BitPeppr/Hojicha44/generated/renders/v0.5.0/bright/orbit_08.png

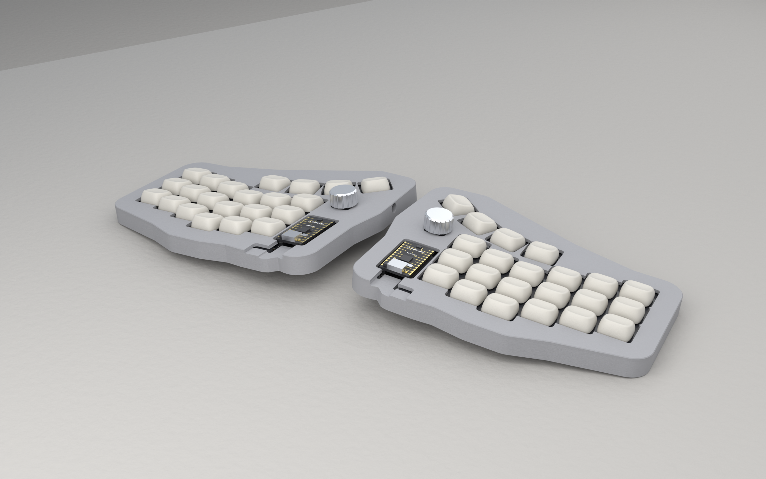
generated/renders/v0.5.0/bright/orbit_08.png
