BitPeppr/Hojicha44/generated/renders/v0.5.0/env/mat.png

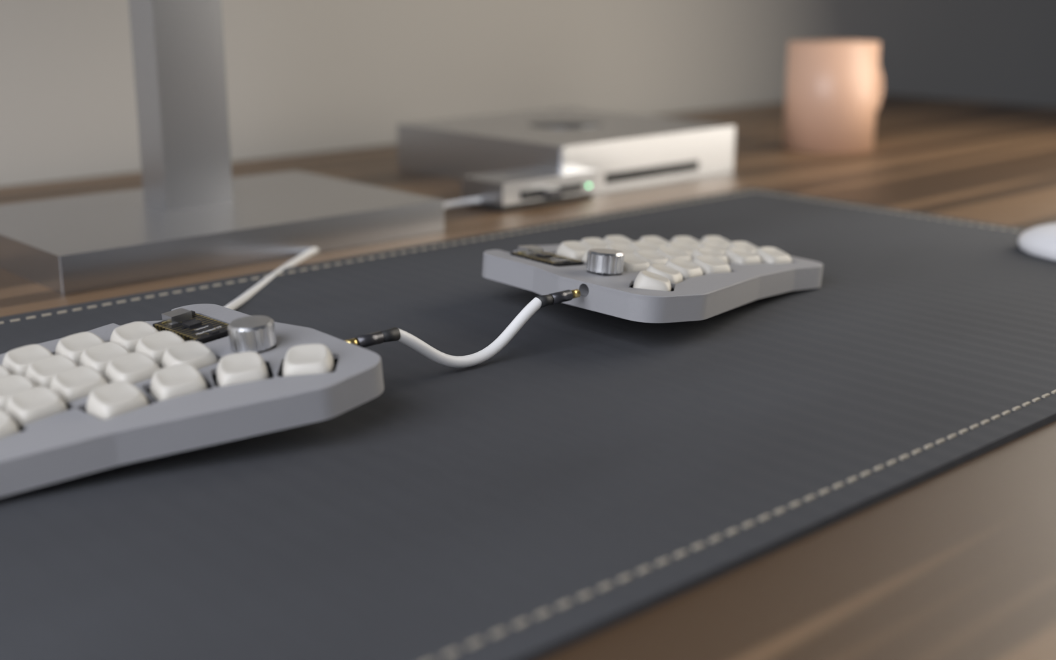
generated/renders/v0.5.0/env/mat.png
