BitPeppr/Hojicha44/generated/renders/v0.5.0/bright/exploded.png

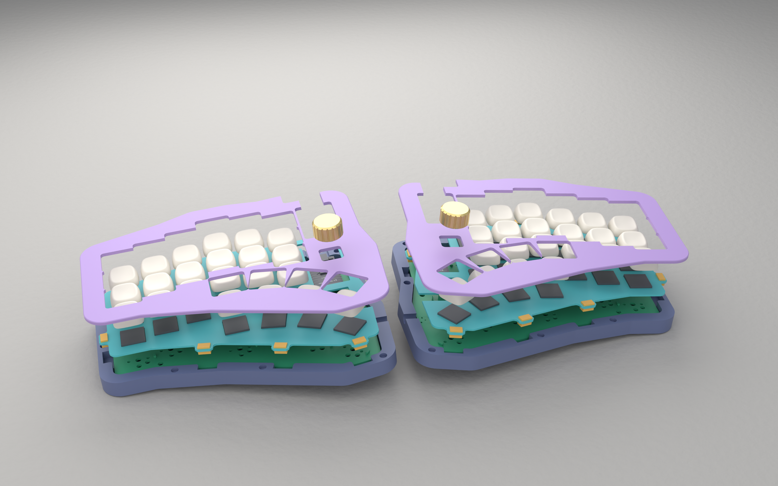
generated/renders/v0.5.0/bright/exploded.png
