BitPeppr/Hojicha44/generated/renders/v0.5.0/bright/hero.png

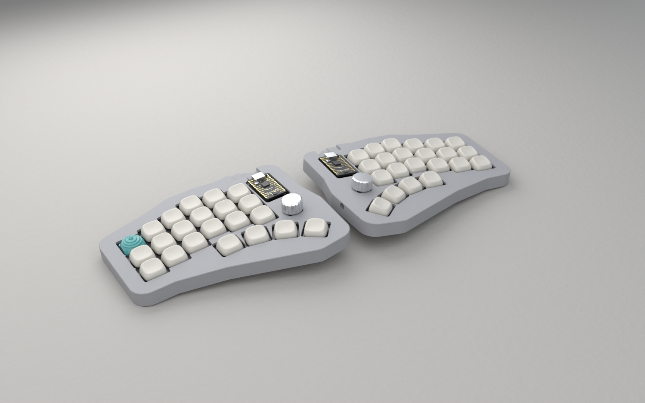
generated/renders/v0.5.0/bright/hero.png
