BitPeppr/Hojicha44/generated/renders/v0.5.0/bright/orbit_02.png

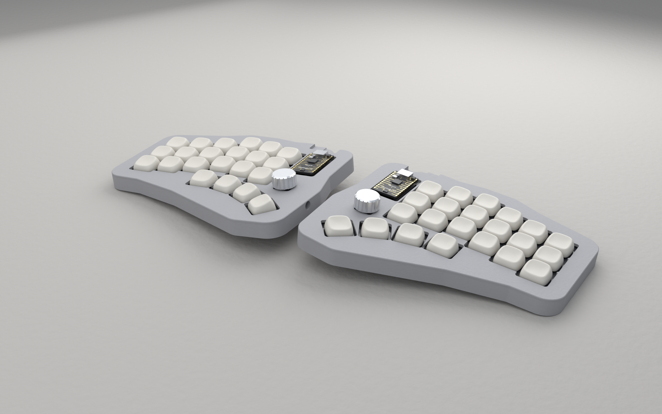
generated/renders/v0.5.0/bright/orbit_02.png
