BitPeppr/Hojicha44/generated/renders/v0.5.0/dark/hero.png

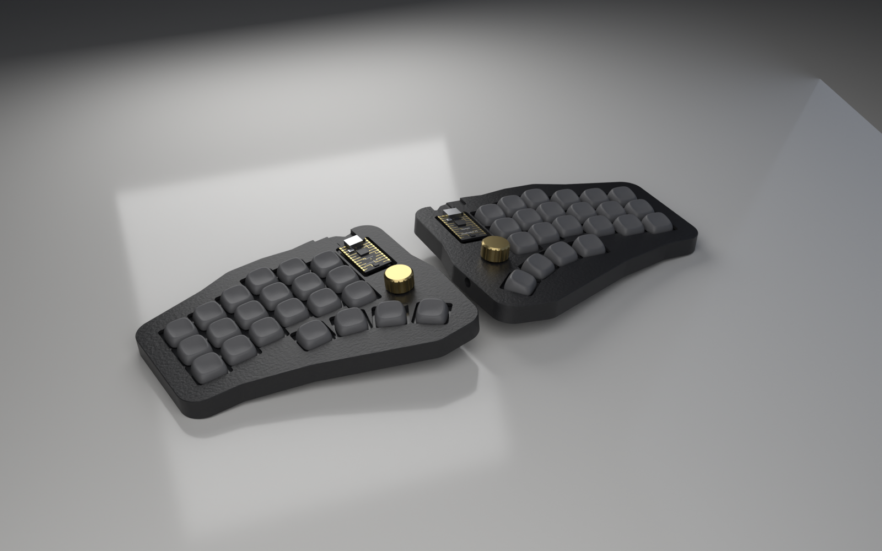
generated/renders/v0.5.0/dark/hero.png
