BitPeppr/Hojicha44/generated/renders/v0.5.0/dark/orbit_02.png

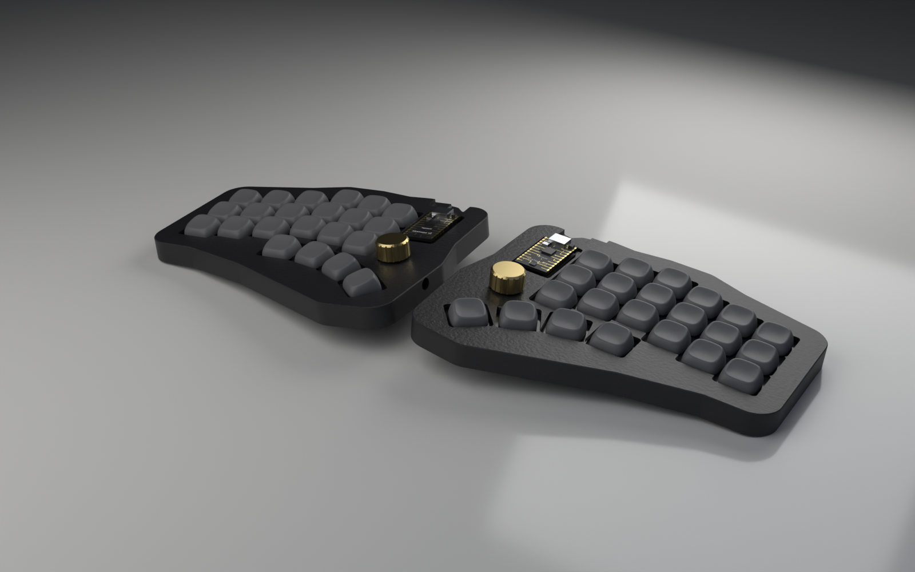
generated/renders/v0.5.0/dark/orbit_02.png
