BitPeppr/Hojicha44/generated/renders/v0.5.0/env/desk.png

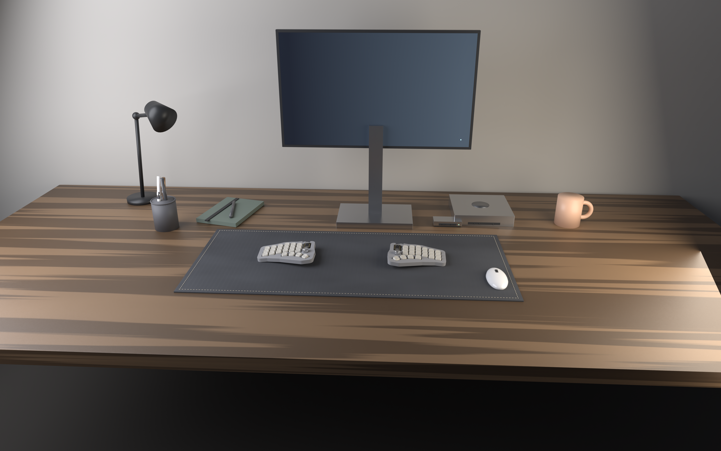
generated/renders/v0.5.0/env/desk.png
