BitPeppr/Hojicha44/spec/bom.md

# Hojicha44 — bill of materials (per half ×2, plus assembly notes)

Source of truth for part numbers: `spec/electronics.yaml`. Schematic symbols
carry `MPN` (all parts) and `Datasheet` (controller) properties from
`pcb/generators/gen_schematic.py`; verify with:

```sh
K=/Applications/KiCad/KiCad.app/Contents/MacOS/kicad-cli
$K sch export bom --fields "Reference,Value,Footprint,MPN,Datasheet,QUANTITY" \
  -o /tmp/bom.csv pcb/kicad/Hojicha44-Left.kicad_sch
```

`Datasheet` holds a URL only where one is certain (controller docs); every
other part is identified by exact `MPN` text — no guessed vendor links.

## SMT (fab assembly)

| Qty | Part | Notes |
|---|---|---|
| 22 | 1N4148W, SOD-123 (example MPN: Diodes Incorporated 1N4148W-7-F, SOD-123 — listed at DigiKey `1N4148W-7-F` and Mouser `1N4148W-7-F`, manufacturer page `diodes.com/part/view/1N4148W`; or equivalent) | matrix diodes, front side |

## Hand assembly (through-hole / modules / mechanical)

| Qty | Part | Notes |
|---|---|---|
| 22 | Kailh PG1350 (Choc v1) switches | top side, seat into sockets — PG1350 names the family/series; builder chooses the exact feel/variant as a kit part (e.g. linear/tactile/clicky) — any PG1350 Choc v1 fits |
| 22 | MBK Choc v1 keycaps (PBT) | one per switch; 44–50 for the split incl. spares — order rows in `pcb/BOM_ORDER.md` §D |
| 22 | Kailh Choc v1 hotswap sockets | SMD bottom (pads part of footprint) |
| 1 | nice!nano v2 module | socketed, USB end to board notch |
| 2 | machine-pin SIP strips 2×12, 2.54mm pitch | socket rows 15.24mm apart; ASSEMBLED STACK HEIGHT (socket + pins, no module) must measure 4.5–5.0mm — caliper at first article; the 2.11mm-height Mill-Max 315 variant is banned BY HEIGHT (cannot clear the 3.0 cell); the 43-112-41-003000 3.0-class socket + matching pins are the order |
| 1 | Rotary encoder, **short-shaft EC11-class with push** (generic "EC11 10–15mm D-shaft, 30 detents/15 pulses, with push" — the class the Sofle Choc build guide documents; verify tip ≤14mm above the PCB + push on the listing) | ALPS EC11E15244G1 (20mm actuator, tip 24.55mm) is the fallback — pair it with a tall knob or trim the shaft; ALPS EC12 (≈8.5mm total) is lower still but has NO push switch |
| 1 | Knob, Ø6 D bore, **round Ø15–17, height ≤12** (committed geometry: Ø16.8 × 9.2, 18 flutes, e.g. fluted aluminium EC11 knobs or 3D-print `renders/build_assets.py`'s) | skirt bottom ≥ 0.9mm above the 5.2 cover (EC11 push travel 0.5±0.3); bore ceiling above the ~13.5 tip; the Ø16.8 sweep clears the nearest cap corner (SW_L17, 24.04mm centre − 12.0 cap half-diagonal) by 3.6mm at every angle — round knobs need no 45° corner sweep check |
| 1 | XKB PJ-320A TRRS 3.5mm | bring-up/debug link only; 90° cable required |
| 1 | TRRS cable, 4-pole CTIA, right-angle 3.5mm both ends, short | mouths face each other across a 22.40mm gap — straight plugs collide head-on; measure the boot, must clear the recessed mouths (0.99mm). No vendor link guessed; any CTIA right-angle cable meeting the fit check in §1 does |
| 1 | Kapton (polyimide) tape, ≥10mm wide | cell sandwich: pouch face + nano underside before the cell goes in |
| 1 | JST S2B-PH-K-S + PHR-2 housing + 2× SPH-002T-P0.5S crimps | battery connector set, side-entry |
| 1 | Würth WS-SLTV 450301014042 | slide SPDT, pad 1 (middle) = common, 300mA switching (fine at 100mA default; leave charge-boost open) |
| 1 | 301230 LiPo cell (see below) | with protection PCM + JST-PH 2.0mm pigtail |

## Case (rev-1 plate + gaskets, per half ×2)

| Qty | Part | Notes |
|---|---|---|
| 1 | Switch plate, **1.2mm**, laser-cut | `plate/Hojicha44-{Left,Right}-plate.dxf` (R12, mm); material per `spec/case.md` (default PC); **22× 14×14 Choc cutouts** (the 13.8 lower body must pass and the clip must overlap the plate edge — 15.0 gave no retention), **16.2×12.4 encoder window** (clears the encoder's 14.95mm terminal-block envelope at the rev-2 plate height), component windows, 8 gasket tabs (NO screws/holes beyond openings). **EXTRA INSTRUCTION TO THE VENDOR: the RELIEF layer is a 0.55mm PARTIAL-DEPTH pocket in the UNDERSIDE under each of the 22 diodes — machine it, do NOT cut through** (0.65mm of plate must remain) |
| ~2 | Poron gasket stock, 4701-30 Very Soft 240kg/m³, 3mm adhesive (sheet/strip cut to 90×4; Keebox 32-pack -40 strips are the drop-in fallback) | per half: 16 pads (8 tabs × 2 faces) cut 7×4 (audit-round carve, corner-edge 0.71mm); swap ladder -30-15 → -40 → -50, no CAD change |
| 16 | N52 disc magnet Ø4×2×2mm (nickel-plated) | TUB magnet pockets (8 per half, Ø4.3×2.2 recess, face-UP flush at the lip plane) |
| 16 | N52 disc magnet Ø4×1.5mm (nickel-plated) | COVER magnet pockets (8 per half, Ø4.3×1.7 recess, face-DOWN flush — T4 review fix: 1.3mm pocket floor; asymmetric pair with the tub's 2.0s is fine, faces meet at the lip plane); supermagnete/GK-class stocked size |

## Cell — locked to orderable stock (was TBD)

- Primary: kriscables 301230 110mAh + JST PH 2.0mm (€8.90–18.90 seen,
  re-check at checkout; SKU
  `Li-Po Battery 110mah-1`, tagged nice!nano — order 2 for a split).
  Verified on the listing: 3×12×30mm, 3.7V, 110mAh, PH 2.0mm, ~3cm leads.
  Charge math on the same page: 100mA → ~1.1h, i.e. 0.9C — suitable.
- Alternates (same class, check stock): KEEBD 301230 110mAh (states PCM
  explicitly, PH 2.0mm options, $5.00) and Typeractive 110mAh 301230
  (PH 2.0mm, "fits snugly underneath a nice!nano", $3.00) — both were
  sold out at check time.
- Hard requirements any cell must meet: 301230 size (302030 does NOT fit —
  20mm fouls the socket pins), 3.7V, ≥100mAh, protection PCM (reject any
  unprotected pouch on arrival), JST-PH 2.0mm pigtail with red=pack+.
- Pack+ (red) → PPTC fuse → switch common, pack− (black) → GND; charges
  only with the switch ON. Meter the pigtail polarity against JST pin 1
  BEFORE the first plug-in (reverse polarity kills board and cell).
- Series PPTC polyfuse, 0.5–1 A hold, ≥16 V, in the pack+ lead — not a
  PCB part; 1 per half (the first-article list buys 20 for 10 halves).
- First-article DMM checks (both halves): RAW↔B+ short, GND↔B− short,
  RAW↔VCC open; charge-ON orange LED.
- Charge-ON labeling: mark the case at each half "charge only when ON"
  (switch upstream of RAW — OFF does nothing); first-article verifies the
  orange LED lights with switch ON and stays dark with OFF.

## Fab limits — confirm with the chosen fab BEFORE ordering

- Confirm minima/cost for this 2-layer 1.6mm stackup: 0.25mm track /
  0.2mm clearance / 0.30-drill-in-0.65-pad signal vias + 0.50-in-1.00
  power vias, plus routed-slot rules for rev-2 flex
  cuts (typically >=1mm). Do not order until the fab accepts the
  Gerber/drill pack against these limits.

## Not parts (fab features)

3× fiducials + 2× 3.2mm NPTH tooling holes per half, placed by the
generator. Gasket mounting uses no PCB holes.

## Fab note

Each half is ~150×115mm — over the 100×100mm value tier at JLCPCB/PCBWay,
so price both tiers (and panel-by-2 quotes) before ordering. Design-vs-fab
limits, checked 2026-10-14 against JLCPCB's published 1–2 layer
capabilities (PCBWay comparable — recheck its page if you use them):
0.25mm tracks (min 0.10), 0.2mm clearance (min 0.10), 0.3/0.65mm signal
vias + 0.5/1.0mm power vias (min drill 0.3 this tier, annular ≥0.15;
ours = 0.30 drill in 0.65 pad → annular 0.175 — JLC-verified 2026-10; the
old "0.15/0.25" line quoted the KiCad template, not the boards),
150×115mm halves (2-layer max 670×600), 1.6mm/0.3 drill = 5.3:1 aspect
(max 8:1). Order **tab-routed, not V-scored**: V-cut wants 0.3mm
copper-to-edge and our measured minimum is 0.29. The outline is concave,
so put this in the fab order comment verbatim: `CONCAVE OUTLINE —
TAB-ROUTE ONLY, NO V-CUT / V-SCORE` — otherwise the outline is rejected
or broken at depaneling.

Stack budget (cell under module, per half): 4.5mm sockets − 3.0 cell −
~0.5 PCM − ~0.2 tape ≈ 0.8mm spare (1.3 with 5.0mm rows). Mill-Max 2.11mm
goes negative — banned, as specified. Confirm PCM/tape thickness and wire
dressing on the first cell; JST lives beside the cell, never under it.
