BitPeppr/Hojicha44/generated/release/v0.5.0/Left/bom.csv

Reference | Value | Footprint | MPN | Datasheet | QUANTITY
D_L00 | 1N4148W | Diode_SMD:D_SOD-123 | 1N4148W |  | 1
D_L01 | 1N4148W | Diode_SMD:D_SOD-123 | 1N4148W |  | 1
D_L02 | 1N4148W | Diode_SMD:D_SOD-123 | 1N4148W |  | 1
D_L03 | 1N4148W | Diode_SMD:D_SOD-123 | 1N4148W |  | 1
D_L04 | 1N4148W | Diode_SMD:D_SOD-123 | 1N4148W |  | 1
D_L05 | 1N4148W | Diode_SMD:D_SOD-123 | 1N4148W |  | 1
D_L06 | 1N4148W | Diode_SMD:D_SOD-123 | 1N4148W |  | 1
D_L07 | 1N4148W | Diode_SMD:D_SOD-123 | 1N4148W |  | 1
D_L08 | 1N4148W | Diode_SMD:D_SOD-123 | 1N4148W |  | 1
D_L09 | 1N4148W | Diode_SMD:D_SOD-123 | 1N4148W |  | 1
D_L10 | 1N4148W | Diode_SMD:D_SOD-123 | 1N4148W |  | 1
D_L11 | 1N4148W | Diode_SMD:D_SOD-123 | 1N4148W |  | 1
D_L12 | 1N4148W | Diode_SMD:D_SOD-123 | 1N4148W |  | 1
D_L13 | 1N4148W | Diode_SMD:D_SOD-123 | 1N4148W |  | 1
D_L14 | 1N4148W | Diode_SMD:D_SOD-123 | 1N4148W |  | 1
D_L15 | 1N4148W | Diode_SMD:D_SOD-123 | 1N4148W |  | 1
D_L16 | 1N4148W | Diode_SMD:D_SOD-123 | 1N4148W |  | 1
D_L17 | 1N4148W | Diode_SMD:D_SOD-123 | 1N4148W |  | 1
D_L18 | 1N4148W | Diode_SMD:D_SOD-123 | 1N4148W |  | 1
D_L19 | 1N4148W | Diode_SMD:D_SOD-123 | 1N4148W |  | 1
D_L20 | 1N4148W | Diode_SMD:D_SOD-123 | 1N4148W |  | 1
D_L21 | 1N4148W | Diode_SMD:D_SOD-123 | 1N4148W |  | 1
ENC_L1 | EC11E-Switch | Rotary_Encoder:RotaryEncoder_Alps_EC11E-Switch_Vertical_H20mm_CircularMountingHoles | Alps EC11E15244G1 |  | 1
J_L1 | PJ-320A TRRS | Hojicha44:TRRS-PJ-320A | XKB PJ-320A |  | 1
J_L2 | BATT_LIPO | Connector_JST:JST_PH_S2B-PH-K_1x02_P2.00mm_Horizontal | JST S2B-PH-K-S |  | 1
SW_L00 | K00 | Hojicha44:SW_Hotswap_Kailh_Choc_V1_1.00u | Kailh PG1350 |  | 1
SW_L01 | K01 | Hojicha44:SW_Hotswap_Kailh_Choc_V1_1.00u | Kailh PG1350 |  | 1
SW_L02 | K02 | Hojicha44:SW_Hotswap_Kailh_Choc_V1_1.00u | Kailh PG1350 |  | 1
SW_L03 | K03 | Hojicha44:SW_Hotswap_Kailh_Choc_V1_1.00u | Kailh PG1350 |  | 1
SW_L04 | K04 | Hojicha44:SW_Hotswap_Kailh_Choc_V1_1.00u | Kailh PG1350 |  | 1
SW_L05 | K05 | Hojicha44:SW_Hotswap_Kailh_Choc_V1_1.00u | Kailh PG1350 |  | 1
SW_L06 | K06 | Hojicha44:SW_Hotswap_Kailh_Choc_V1_1.00u | Kailh PG1350 |  | 1
SW_L07 | K07 | Hojicha44:SW_Hotswap_Kailh_Choc_V1_1.00u | Kailh PG1350 |  | 1
SW_L08 | K08 | Hojicha44:SW_Hotswap_Kailh_Choc_V1_1.00u | Kailh PG1350 |  | 1
SW_L09 | K09 | Hojicha44:SW_Hotswap_Kailh_Choc_V1_1.00u | Kailh PG1350 |  | 1
SW_L10 | K10 | Hojicha44:SW_Hotswap_Kailh_Choc_V1_1.00u | Kailh PG1350 |  | 1
SW_L11 | K11 | Hojicha44:SW_Hotswap_Kailh_Choc_V1_1.00u | Kailh PG1350 |  | 1
SW_L12 | K12 | Hojicha44:SW_Hotswap_Kailh_Choc_V1_1.00u | Kailh PG1350 |  | 1
SW_L13 | K13 | Hojicha44:SW_Hotswap_Kailh_Choc_V1_1.00u | Kailh PG1350 |  | 1
SW_L14 | K14 | Hojicha44:SW_Hotswap_Kailh_Choc_V1_1.00u | Kailh PG1350 |  | 1
SW_L15 | K15 | Hojicha44:SW_Hotswap_Kailh_Choc_V1_1.00u | Kailh PG1350 |  | 1
SW_L16 | K16 | Hojicha44:SW_Hotswap_Kailh_Choc_V1_1.00u | Kailh PG1350 |  | 1
SW_L17 | K17 | Hojicha44:SW_Hotswap_Kailh_Choc_V1_1.00u | Kailh PG1350 |  | 1
SW_L18 | K18 | Hojicha44:SW_Hotswap_Kailh_Choc_V1_1.00u | Kailh PG1350 |  | 1
SW_L19 | K19 | Hojicha44:SW_Hotswap_Kailh_Choc_V1_1.00u | Kailh PG1350 |  | 1
SW_L20 | K20 | Hojicha44:SW_Hotswap_Kailh_Choc_V1_1.00u | Kailh PG1350 |  | 1
SW_L21 | K21 | Hojicha44:SW_Hotswap_Kailh_Choc_V1_1.00u | Kailh PG1350 |  | 1
SW_LPWR1 | PWR_SW | Button_Switch_THT:SW_Slide-03_Wuerth-WS-SLTV_10x2.5x6.4_P2.54mm | Wuerth 450301014042 |  | 1
U_L1 | nice!nano v2 | Hojicha44:Socket_Strips_2x12_P2.54mm_NiceNano | nice!nano v2 | https://nicekeyboards.com/docs/nice-nano/ | 1
