BitPeppr/Hojicha44/case/out/Hojicha44-Right-cover.step

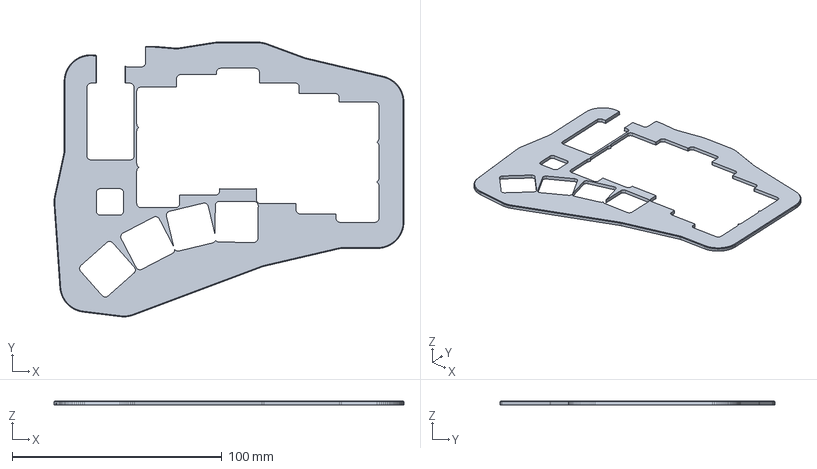
[picture p11: CAD file, 2026-10-24]
case/out/Hojicha44-Right-cover.step
166.9 x 131.0 x 2.00 mm
