BitPeppr/Hojicha44/layout/generated/v2/outlines/board.dxf

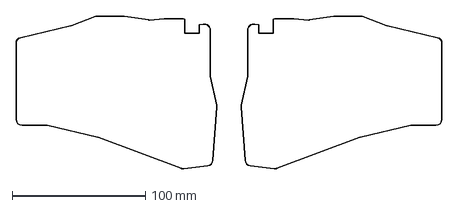
[picture p12: CAD file, 2026-10-21]
layout/generated/v2/outlines/board.dxf
319.5 x 114.7 mm
