BitPeppr/Hojicha44/plate/Hojicha44-Right-plate.dxf

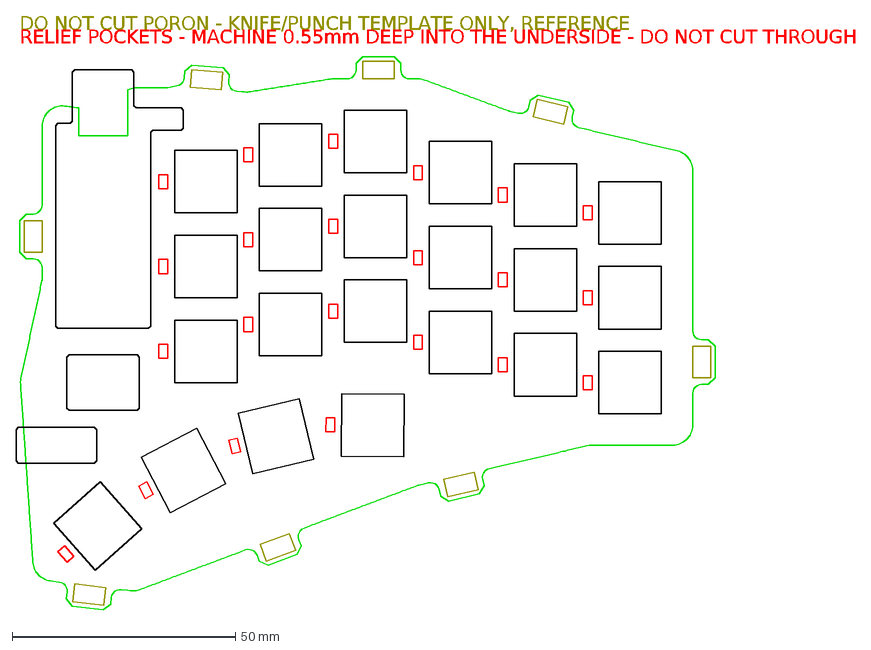
[picture p13: CAD file, 2026-10-22]
plate/Hojicha44-Right-plate.dxf
DO NOT CUT PORON - KNIFE/PUNCH TEMPLATE ONLY, REFERENCE
RELIEF POCKETS - MACHINE 0.55mm DEEP INTO THE UNDERSIDE - DO NOT CUT THROUGH
