BitPeppr/Hojicha44/plate/Hojicha44-Left-plate.dxf

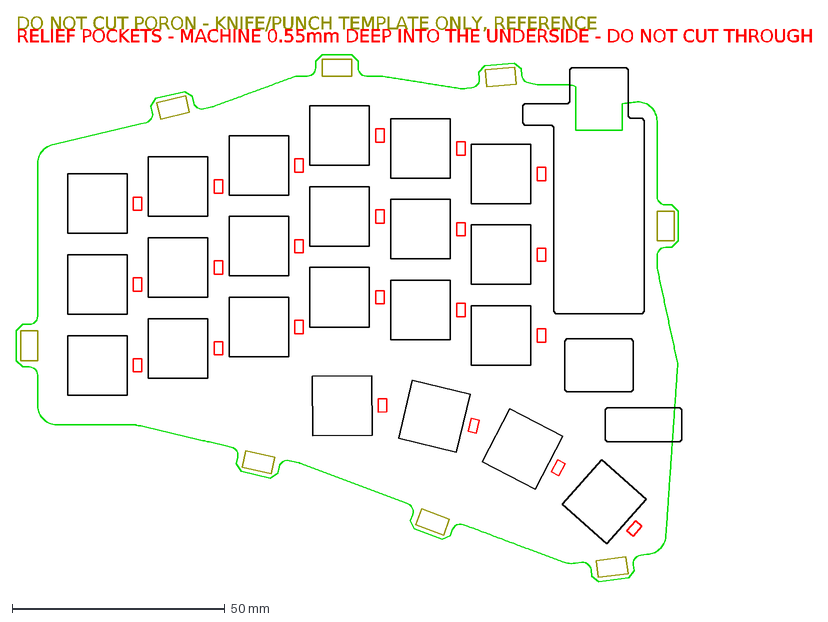
[picture p14: CAD file, 2026-10-22]
plate/Hojicha44-Left-plate.dxf
DO NOT CUT PORON - KNIFE/PUNCH TEMPLATE ONLY, REFERENCE
RELIEF POCKETS - MACHINE 0.55mm DEEP INTO THE UNDERSIDE - DO NOT CUT THROUGH
