BitPeppr/Hojicha44/case/out/Hojicha44-Right-tub.step

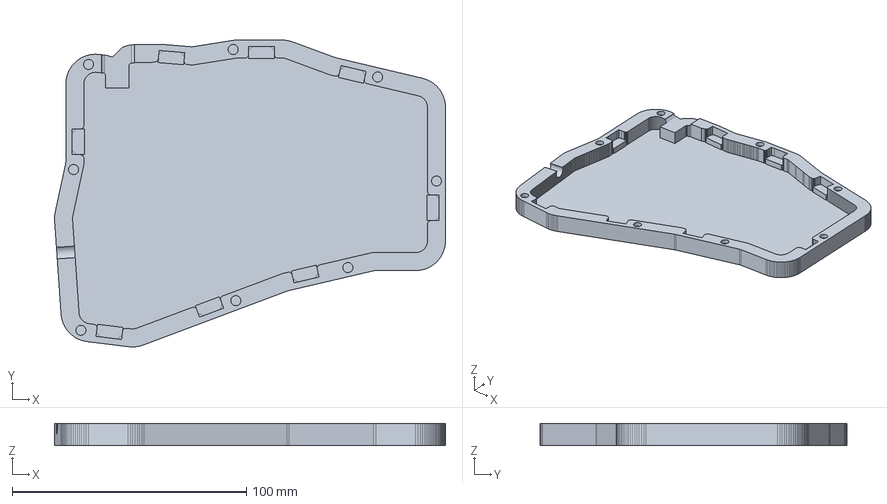
[picture p15: CAD file, 2026-10-24]
case/out/Hojicha44-Right-tub.step
166.9 x 131.0 x 9.55 mm
