BitPeppr/Hojicha44/(list of files, cad)

Other CAD files:
case/out/Hojicha44-Left-cover.step
case/out/Hojicha44-Left-tub.step
