BitPeppr/Hojicha44/pcb/kicad/Hojicha44-Right.kicad_pcb

## KiCad design pcb/kicad/Hojicha44-Right.kicad_pcb (2026-10-23)

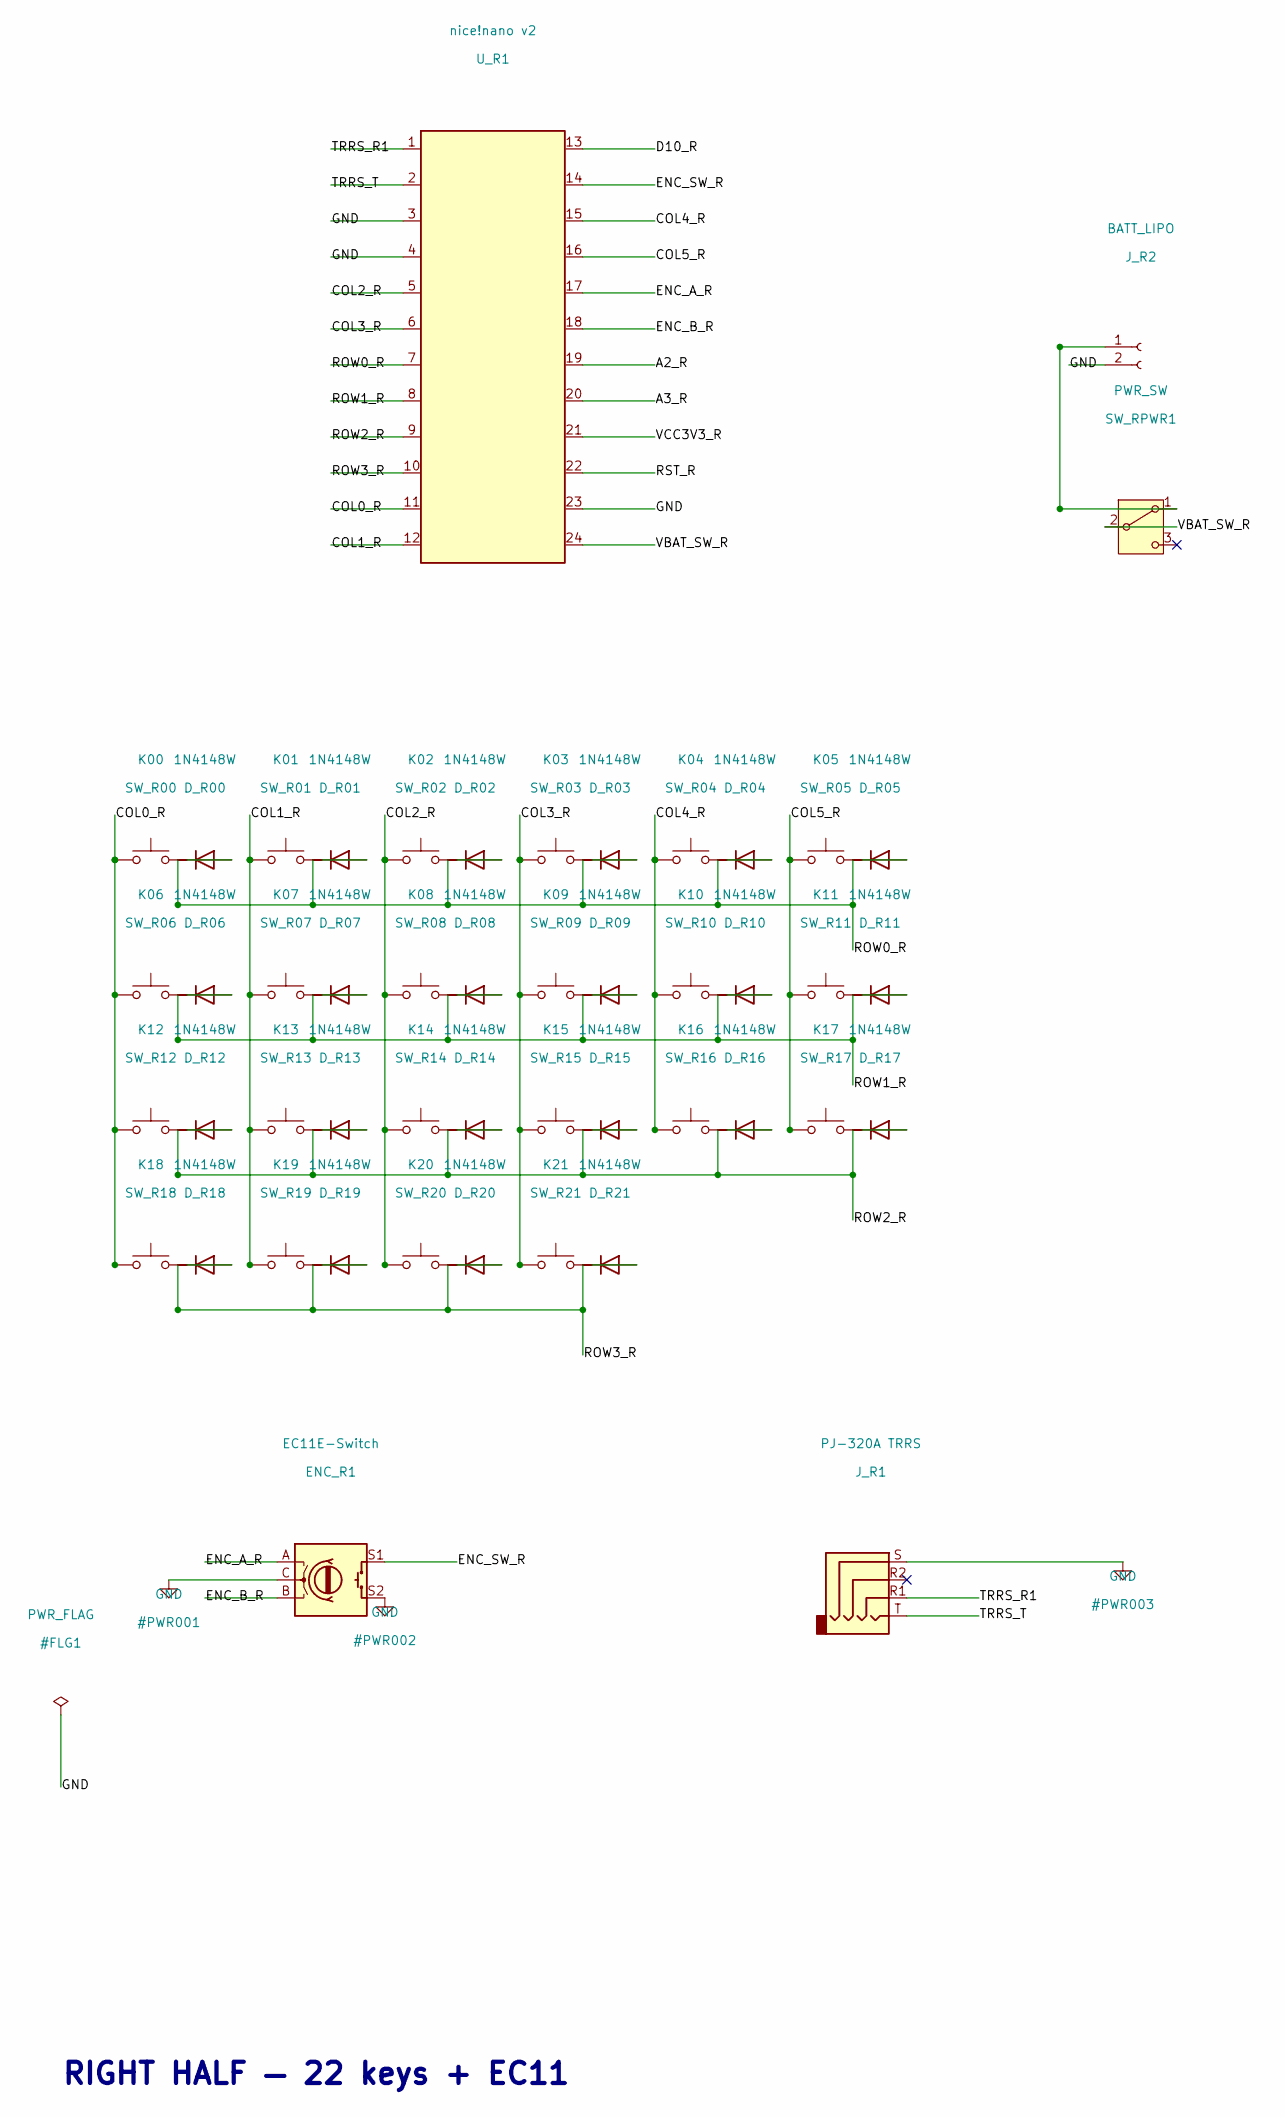
[picture p16: schematic Hojicha44-Right.kicad_sch, Hojicha44 Hojicha44-Right]

Parts:
D_R00, D_R01, D_R02, D_R03, D_R04, D_R05, D_R06, D_R07, D_R08, D_R09, D_R10, D_R11, D_R12, D_R13, D_R14, D_R15, D_R16, D_R17, D_R18, D_R19, D_R20, D_R21: 1N4148W; D_SOD-123; MPN 1N4148W
ENC_R1: EC11E-Switch; RotaryEncoder_Alps_EC11E-Switch_Vertical_H20mm_CircularMoun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; MPN Alps EC11E15244G1
J_R1: PJ-320A TRRS; TRRS-PJ-320A; MPN XKB PJ-320A
J_R2: BATT_LIPO; JST_PH_S2B-PH-K_1x02_P2.00mm_Horizontal; MPN JST S2B-PH-K-S
SW_R00: K00; SW_Hotswap_Kailh_Choc_V1_1.00u; MPN Kailh PG1350
SW_R01: K01; SW_Hotswap_Kailh_Choc_V1_1.00u; MPN Kailh PG1350
SW_R02: K02; SW_Hotswap_Kailh_Choc_V1_1.00u; MPN Kailh PG1350
SW_R03: K03; SW_Hotswap_Kailh_Choc_V1_1.00u; MPN Kailh PG1350
SW_R04: K04; SW_Hotswap_Kailh_Choc_V1_1.00u; MPN Kailh PG1350
SW_R05: K05; SW_Hotswap_Kailh_Choc_V1_1.00u; MPN Kailh PG1350
SW_R06: K06; SW_Hotswap_Kailh_Choc_V1_1.00u; MPN Kailh PG1350
SW_R07: K07; SW_Hotswap_Kailh_Choc_V1_1.00u; MPN Kailh PG1350
SW_R08: K08; SW_Hotswap_Kailh_Choc_V1_1.00u; MPN Kailh PG1350
SW_R09: K09; SW_Hotswap_Kailh_Choc_V1_1.00u; MPN Kailh PG1350
SW_R10: K10; SW_Hotswap_Kailh_Choc_V1_1.00u; MPN Kailh PG1350
SW_R11: K11; SW_Hotswap_Kailh_Choc_V1_1.00u; MPN Kailh PG1350
SW_R12: K12; SW_Hotswap_Kailh_Choc_V1_1.00u; MPN Kailh PG1350
SW_R13: K13; SW_Hotswap_Kailh_Choc_V1_1.00u; MPN Kailh PG1350
SW_R14: K14; SW_Hotswap_Kailh_Choc_V1_1.00u; MPN Kailh PG1350
SW_R15: K15; SW_Hotswap_Kailh_Choc_V1_1.00u; MPN Kailh PG1350
SW_R16: K16; SW_Hotswap_Kailh_Choc_V1_1.00u; MPN Kailh PG1350
SW_R17: K17; SW_Hotswap_Kailh_Choc_V1_1.00u; MPN Kailh PG1350
SW_R18: K18; SW_Hotswap_Kailh_Choc_V1_1.00u; MPN Kailh PG1350
SW_R19: K19; SW_Hotswap_Kailh_Choc_V1_1.00u; MPN Kailh PG1350
SW_R20: K20; SW_Hotswap_Kailh_Choc_V1_1.00u; MPN Kailh PG1350
SW_R21: K21; SW_Hotswap_Kailh_Choc_V1_1.00u; MPN Kailh PG1350
SW_RPWR1: PWR_SW; SW_Slide-03_Wuerth-WS-SLTV_10x2.5x6.4_P2.54mm; MPN Wuerth 450301014042
U_R1: nice!nano v2; Socket_Strips_2x12_P2.54mm_NiceNano; MPN nice!nano v2

Connections:
/A2_R: U_R1.19 (A2)
/A3_R: U_R1.20 (A3)
/COL0_R: SW_R00.1, SW_R06.1, SW_R12.1, SW_R18.1, U_R1.11 (D8)
/COL1_R: SW_R01.1, SW_R07.1, SW_R13.1, SW_R19.1, U_R1.12 (D9)
/COL2_R: SW_R02.1, SW_R08.1, SW_R14.1, SW_R20.1, U_R1.5 (D2)
/COL3_R: SW_R03.1, SW_R09.1, SW_R15.1, SW_R21.1, U_R1.6 (D3)
/COL4_R: SW_R04.1, SW_R10.1, SW_R16.1, U_R1.15 (D14)
/COL5_R: SW_R05.1, SW_R11.1, SW_R17.1, U_R1.16 (D15)
/D10_R: U_R1.13 (D10)
/ENC_A_R: ENC_R1.A, U_R1.17 (A0)
/ENC_B_R: ENC_R1.B, U_R1.18 (A1)
/ENC_SW_R: ENC_R1.S1, U_R1.14 (D16)
/ROW0_R: D_R00.1 (K), D_R01.1 (K), D_R02.1 (K), D_R03.1 (K), D_R04.1 (K), D_R05.1 (K), U_R1.7 (D4)
/ROW1_R: D_R06.1 (K), D_R07.1 (K), D_R08.1 (K), D_R09.1 (K), D_R10.1 (K), D_R11.1 (K), U_R1.8 (D5)
/ROW2_R: D_R12.1 (K), D_R13.1 (K), D_R14.1 (K), D_R15.1 (K), D_R16.1 (K), D_R17.1 (K), U_R1.9 (D6)
/ROW3_R: D_R18.1 (K), D_R19.1 (K), D_R20.1 (K), D_R21.1 (K), U_R1.10 (D7)
/RST_R: U_R1.22 (RST)
/TRRS_R1: J_R1.R1, U_R1.1 (D1)
/TRRS_T: J_R1.T, U_R1.2 (D0)
/VBAT_SW_R: SW_RPWR1.2 (B), U_R1.24 (RAW)
/VCC3V3_R: U_R1.21 (VCC)
GND: ENC_R1.C, ENC_R1.S2, J_R1.S, J_R2.2, U_R1.3 (GND), U_R1.4 (GND), U_R1.23 (GND)
unnamed: D_R00.2 (A), SW_R00.2
unnamed: D_R01.2 (A), SW_R01.2
unnamed: D_R02.2 (A), SW_R02.2
unnamed: D_R03.2 (A), SW_R03.2
unnamed: D_R04.2 (A), SW_R04.2
unnamed: D_R05.2 (A), SW_R05.2
unnamed: D_R06.2 (A), SW_R06.2
unnamed: D_R07.2 (A), SW_R07.2
unnamed: D_R08.2 (A), SW_R08.2
unnamed: D_R09.2 (A), SW_R09.2
unnamed: D_R10.2 (A), SW_R10.2
unnamed: D_R11.2 (A), SW_R11.2
unnamed: D_R12.2 (A), SW_R12.2
unnamed: D_R13.2 (A), SW_R13.2
unnamed: D_R14.2 (A), SW_R14.2
unnamed: D_R15.2 (A), SW_R15.2
unnamed: D_R16.2 (A), SW_R16.2
unnamed: D_R17.2 (A), SW_R17.2
unnamed: D_R18.2 (A), SW_R18.2
unnamed: D_R19.2 (A), SW_R19.2
unnamed: D_R20.2 (A), SW_R20.2
unnamed: D_R21.2 (A), SW_R21.2
unnamed: J_R2.1, SW_RPWR1.1 (A)

Notes on the sheet:
RIGHT HALF — 22 keys + EC11

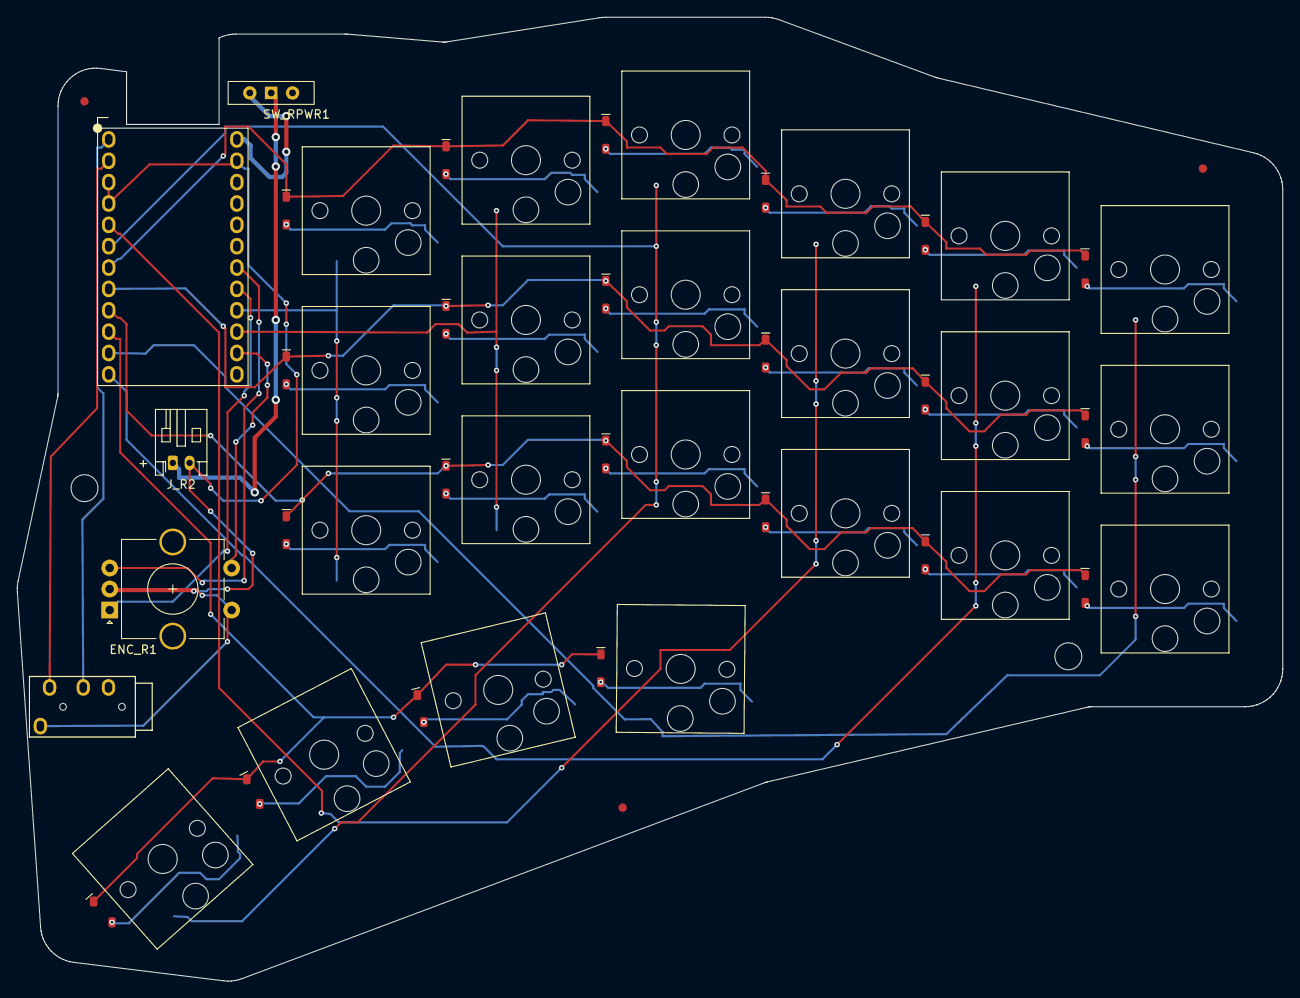
[picture p17: board Hojicha44-Right.kicad_pcb from above]

Board: 2 copper layers, 150.5 x 114.6 mm, 54 parts (0 on the bottom side), 40 nets.

Other parts of the board:
FID_R1, FID_R2, FID_R3: FIDUCIAL; Fiducial_1mm_Mask3mm
MT_R1, MT_R2: TOOLING; MountingHole_3.2mm_M3
