BitPeppr/Hojicha44/pcb/generators/gen_pcb.py

#!/usr/bin/env python3
"""Hojicha44 PCB generator — source of truth for placed+routed .kicad_pcb.

Reads ergogen points + board outline DXF + the per-half schematic netlists,
embeds footprints at their placed positions, and writes both board files.

  python3 pcb/generators/gen_pcb.py        # place + route + DRC

Routed: tracks/vias come from the deterministic router
(pcb/generators/gen_route.py). Hand-tuned copper is preserved by an explicit
provenance manifest (pcb/kicad/hand-copper.txt): only items matching a
manifest signature survive a regen, everything else is router-owned and
regenerated wholesale — extraction reads the committed baseline (git HEAD),
so a failed build can never become its own next input. DRC must show zero
unconnected (clean modulo waivers W1/W2); what this pass must satisfy is
outline validity, footprint embedding, net assignment parity with the
schematic, and courtyard sanity.

Right-half rule: the mirror_* points are already mirrored coordinates. Use
them directly with the SAME layers and the given rotations — no footprint
mirroring/flipping. (Flipping would swap F.Cu/B.Cu and put sockets on top.)
"""
import math
import os
import re
import shutil
import subprocess
import sys
import uuid

import frame

REPO = os.path.dirname(os.path.dirname(os.path.dirname(os.path.abspath(__file__))))
PCB_DIR = os.path.join(REPO, "pcb", "kicad")
POINTS = os.path.join(REPO, "layout", "generated", "v2", "points", "points.yaml")
BOARD_DXF = os.path.join(REPO, "layout", "generated", "v2", "outlines", "board.dxf")
PROJECT = {"L": "Hojicha44-Left", "R": "Hojicha44-Right"}
HALVES = ("L", "R")
MIRROR_AXIS = 145.75  # (x_left + x_mirror)/2 for every ergogen pair

KICAD_CLI = os.environ.get(
    "KICAD_CLI",
    shutil.which("kicad-cli")
    or "/Applications/KiCad/KiCad.app/Contents/MacOS/kicad-cli",
)
STOCK_FP = "/Applications/KiCad/KiCad.app/Contents/SharedSupport/footprints"

FP_SRC = {
    "SW": ("Hojicha44", "SW_Hotswap_Kailh_Choc_V1_1.00u"),
    "DIODE": ("Diode_SMD", "D_SOD-123"),
    "MCU": ("Hojicha44", "Socket_Strips_2x12_P2.54mm_NiceNano"),
    "ENC": ("Rotary_Encoder",
            "RotaryEncoder_Alps_EC11E-Switch_Vertical_H20mm_CircularMountingHoles"),
    "TRRS": ("Hojicha44", "TRRS-PJ-320A"),
    "JST": ("Connector_JST", "JST_PH_S2B-PH-K_1x02_P2.00mm_Horizontal"),
    "PWR": ("Button_Switch_THT", "SW_Slide-03_Wuerth-WS-SLTV_10x2.5x6.4_P2.54mm"),
    "FID": ("Fiducial", "Fiducial_1mm_Mask3mm"),
    "TOOL": ("MountingHole", "MountingHole_3.2mm_M3"),
}

COLS = ["outer", "pinky", "ring", "middle", "index", "inner"]
ROW_OF_R = {0: "top", 1: "home", 2: "bottom"}
THUMBS = ["t_ctrl", "t_cmd", "t_l1", "t_space"]

# 3D-model overrides, applied at embed: the footprint keeps its stock
# geometry (pads/silk/courtyard untouched — DRC sees the same copper),
# only the render/stack model pointer is re-homed to a vendored file.
# Needed because the stock references dangle: neither file ships in any
# KiCad bundle nor exists in any upstream repo (footprints added without
# their models). ENC remap: measured DIRECTLY from the STEP pin geometry,
# not from marbastlib's pairing (whose offset (-2.5,-7.5)+rot-90 does not
# land its own model's pins on its own pads — provenance untrustworthy).
# Model-space contacts: 3-pin column x=0 at y=-5.01/-2.48/+0.02, 2-pin
# column x=14.5 at y=-5.03/-0.02, lugs x~7.47 at y=-8.38/+3.39. Stock pads:
# A/B/C x=0 y=0/5/2.5, S2/S1 x=14.5 y=0/5, MP x=7.5 y=-3.1/8.1. Pure shift
# (0,5,0) + rot 0 lands every signal/switch pin within 0.03mm (lugs within
# 0.3mm — fine inside the 2.6mm MP drills) and the shaft at (7.47,2.49).
# NOTE the trap: the shaft alone lands (within 0.03mm) under rot-180 too,
# so shaft-centering can NOT verify this — only legs-on-pads can.
MODEL_OVERRIDES = {
    ("Rotary_Encoder",
     "RotaryEncoder_Alps_EC11E-Switch_Vertical_H20mm_CircularMountingHoles"):
        ("${KIPRJMOD}/Hojicha44.3dshapes/ROT_EC11E.step",
         "(xyz 0 5 0)", "(xyz 0 0 0)"),
    ("Button_Switch_THT",
     "SW_Slide-03_Wuerth-WS-SLTV_10x2.5x6.4_P2.54mm"):
        ("${KIPRJMOD}/Hojicha44.3dshapes/ws-sltv-envelope.wrl",
         "(xyz 0 0 0)", "(xyz 0 0 0)"),
}


def U():
    return str(uuid.uuid4())


def r2(v):
    return round(v, 3)


# ---------------------------------------------------------------- points

def load_points():
    """{name: (x, y, r)} parsed with regex (no yaml dependency)."""
    t = open(POINTS).read()
    out = {}
    for m in re.finditer(
            r"^([A-Za-z0-9_]+):\n  x: ([-\d.]+)\n  'y': ([-\d.]+)\n  r: ([-\d.]+)",
            t, re.M):
        out[m.group(1)] = (float(m.group(2)), float(m.group(3)), float(m.group(4)))
    assert len(out) >= 60, f"points: {len(out)} entries, want >= 60"
    return out


def key_points(pts, tag):
    """22 (idx, point_name, x, y, rot) in schematic idx order.

    Schematic idx: r0c0..r0c5 (0-5, top row), r1 (6-11, home), r2 (12-17,
    bottom), thumbs R3C0-3 (18-21, west->east). Right half uses the already-
    mirrored mirror_* coordinates with their given rotations.
    """
    pre = "" if tag == "L" else "mirror_"
    out = []
    for r in range(3):
        for c in range(6):
            idx = r * 6 + c
            name = f"{pre}matrix_{COLS[c]}_{ROW_OF_R[r]}"
            x, y, rot = pts[name]
            out.append((idx, name, x, y, rot))
    for i, th in enumerate(THUMBS):
        idx = 18 + i
        name = f"{pre}thumbs_{th}_cluster"
        x, y, rot = pts[name]
        out.append((idx, name, x, y, rot))
    assert len(out) == 22
    return out


# ---------------------------------------------------------------- netlist

def load_nets(tag, refresh=False):
    """Schematic netlist -> (nets, pin_net).

    Exported by kicad-cli straight into pcb/kicad/<project>-<tag>.net,
    a TRACKED artifact: the export is deterministic and byte-stable
    (unlike the boards, which are only geometry-stable — uuid/date
    churn), and CI's check_board has no KiCad — it parses the
    committed bytes and is the only net source when kicad-cli is
    absent.

    refresh=False (default) READS the committed netlist and never
    touches the file — the gates must not mutate tracked artifacts
    (audit round 2026-10-21: the gates re-exported the netlist in
    place whenever kicad-cli was present, so a "read-only" gate rewrote
    a tracked file and locally tested different bytes than CI did).
    refresh=True is the BUILDER's path: it re-exports the netlist from
    the schematic before placing.

    nets: [(code, name)]; pin_net: {(ref, pin): (code, name)}.
    """
    netpath = os.path.join(PCB_DIR, PROJECT[tag] + ".net")
    sch = os.path.join(PCB_DIR, PROJECT[tag] + ".kicad_sch")
    if refresh and os.path.exists(KICAD_CLI):
        r = subprocess.run(
            [KICAD_CLI, "sch", "export", "netlist", "--format",
             "kicadsexpr", "-o", netpath, sch],
            capture_output=True, text=True)
        if r.returncode != 0:
            raise RuntimeError(f"netlist export failed for {tag}:\n{r.stderr}")
        # KiCad stamps the header (date "…") and the ABSOLUTE source
        # path of the exporting machine — both non-deterministic /
        # machine-specific bytes in the export (audit-3 R3-03). Neutralize
        # both so consecutive builds on any machine commit identical,
        # machine-neutral files (same hygiene as the board uuid/date
        # churn); the committed artifact names its source repo-relatively.
        body = open(netpath).read()
        body = re.sub(r'\(date\s*"[^"]*"\)', '(date "")', body)
        body = re.sub(r'\(source\s*"[^"]*"\)',
                      f'(source "pcb/kicad/{PROJECT[tag]}.kicad_sch")',
                      body)
        open(netpath, "w").write(body)
    elif not os.path.exists(netpath):
        raise RuntimeError(f"{tag}: kicad-cli absent and {netpath} missing "
                           "(the committed netlist is CI's only source)")
    s = open(netpath).read()
    nets = [(0, "")]
    pin_net = {}
    for m in re.finditer(
            r"\(net\s*\(code \"(\d+)\"\)\s*\(name \"([^\"]*)\"\)"
            r"\s*\(class \"[^\"]*\"\)(.*?)\n\t\t\)", s, re.S):
        code, name, body = int(m.group(1)), m.group(2), m.group(3)
        nets.append((code, name))
        for n in re.finditer(
                r"\(node\s*\(ref \"([^\"]+)\"\)\s*\(pin \"([^\"]+)\"\)",
                body):
            pin_net[(n.group(1), n.group(2))] = (code, name)
    nn = len(nets) - 1  # nets[0] is the (0, "") placeholder
    if not 30 <= nn <= 70:
        raise RuntimeError(
            f"{tag}: {nn} nets parsed — outside the sane 30..70 band "
            "(a regex/netlist regression used to pass at len==1 with 0 "
            "pin nets, silently dropping every connectivity gate)")
    return nets, pin_net


# ---------------------------------------------------------------- outline

def load_dxf_entities():
    """Parse ENTITIES section: [('line', x1,y1,x2,y2), ('arc', cx,cy,r,a1,a2)]."""
    lines = open(BOARD_DXF).read().splitlines()
    try:
        i = lines.index("ENTITIES")
    except ValueError:
        raise RuntimeError("board.dxf has no ENTITIES section")
    ents = []
    j = i + 1
    while j < len(lines):
        t = lines[j].strip()
        if t == "ENDSEC":
            break
        if t == "LINE":
            d = {}
            j += 1
            while j + 1 < len(lines) and lines[j].strip() != "0":
                d[lines[j].strip()] = lines[j + 1].strip()
                j += 2
            ents.append(("line", float(d["10"]), float(d["20"]),
                         float(d["11"]), float(d["21"])))
            continue
        if t == "ARC":
            d = {}
            j += 1
            while j + 1 < len(lines) and lines[j].strip() != "0":
                d[lines[j].strip()] = lines[j + 1].strip()
                j += 2
            ents.append(("arc", float(d["10"]), float(d["20"]),
                         float(d["40"]), float(d["50"]), float(d["51"])))
            continue
        j += 1
    return ents


def arc_segments(cx, cy, r, a1, a2, max_step=6.0):
    """DXF arc (deg, CCW) -> list of ((x1,y1),(x2,y2)) chords.

    Ergogen emits zero-span fillet dots (span ~1e-7 deg) at tangent joints;
    those are not geometry — skip them, and drop sub-micron chords, so the
    loop-closure check sees real joints only.
    """
    while a2 < a1:
        a2 += 360.0
    span = a2 - a1
    if span < 1e-3:
        return []
    n = max(2, int(math.ceil(span / max_step)))
    pts = []
    for k in range(n + 1):
        a = math.radians(a1 + span * k / n)
        pts.append((cx + r * math.cos(a), cy + r * math.sin(a)))
    segs = list(zip(pts, pts[1:]))
    return [(p1, p2) for p1, p2 in segs
            if math.hypot(p2[0] - p1[0], p2[1] - p1[1]) >= 1e-3]


def outline_graphics(side):
    """Edge.Cuts gr_line items for one side, arcs segmented."""
    ents = load_dxf_entities()
    out = []
    n_arc = 0
    for e in ents:
        if e[0] == "line":
            _, x1, y1, x2, y2 = e
            if side == "L" and max(x1, x2) >= MIRROR_AXIS:
                continue
            if side == "R" and min(x1, x2) < MIRROR_AXIS:
                continue
            out.append(
                f'\t(gr_line (start {r2(x1)} {r2(y1)}) (end {r2(x2)} {r2(y2)})'
                f' (layer "Edge.Cuts") (stroke (width 0.1) (type solid))'
                f' (uuid "{U()}"))')
        else:
            _, cx, cy, r, a1, a2 = e
            if side == "L" and cx >= MIRROR_AXIS:
                continue
            if side == "R" and cx < MIRROR_AXIS:
                continue
            n_arc += 1
            for (p1, p2) in arc_segments(cx, cy, r, a1, a2):
                out.append(
                    f'\t(gr_line (start {r2(p1[0])} {r2(p1[1])})'
                    f' (end {r2(p2[0])} {r2(p2[1])})'
                    f' (layer "Edge.Cuts") (stroke (width 0.1) (type solid))'
                    f' (uuid "{U()}"))')
    # closed-loop sanity: every segment endpoint meets another segment
    ends = {}
    for g in out:
        m = re.search(r"\(start ([-\d.]+) ([-\d.]+)\) \(end ([-\d.]+) ([-\d.]+)\)", g)
        a = (round(float(m.group(1)), 2), round(float(m.group(2)), 2))
        b = (round(float(m.group(3)), 2), round(float(m.group(4)), 2))
        ends[a] = ends.get(a, 0) + 1
        ends[b] = ends.get(b, 0) + 1
    dangle = [p for p, n in ends.items() if n != 2]
    print(f"  outline {side}: {len(out)} segments ({n_arc} arcs), "
          f"{len(dangle)} open endpoints")
    assert not dangle, f"outline {side} not closed: {dangle[:6]}"
    return out


# ---------------------------------------------------------------- footprints

def fp_source(lib, name):
    """Footprint definition text.

    Hojicha44 = the project's own lib. Anything else must be a stock
    KiCad lib resolve from pcb/stock/<lib>.pretty (byte-identical
    vendored copies — KiCad-free CI has no install; see pcb/stock/
    README.md), falling back to the local install for anything missing.
    """
    if lib == "Hojicha44":
        p = os.path.join(PCB_DIR, "Hojicha44.pretty", name + ".kicad_mod")
    else:
        v = os.path.join(REPO, "pcb", "stock", lib + ".pretty",
                         name + ".kicad_mod")
        p = v if os.path.exists(v) else \
            os.path.join(STOCK_FP, lib + ".pretty", name + ".kicad_mod")
    return open(p).read()


# KiCad footprint rotation is CLOCKWISE-positive (verified: stock TRRS at
# rot=270 maps local (-2.3,11.3) to global offset (-11.3,-2.3), i.e. CW270).
# Ergogen r is CCW-positive (makerjs). Same visual orientation therefore
# needs KiCad rot = -ergogen_r. Gets this wrong and every rotated footprint
# tilts the mirror image (plus a lib_footprint_mismatch warning per part).
def krot(erg_r):
    return r2(-erg_r)


def embed(src, libref, ref, value, x, y, rot, pin_nets, hide_ref=False,
          ref_on_fab=False, strip_silk=False, cathode_tick=False,
          ref_shift=(0.0, 0.0)):
    """Embed a .kicad_mod as a board instance.

    Keeps all local geometry; sets the instance position, reference/value,
    per-pad nets, and fresh uuids (instances must not share uuids).
    hide_ref hides the silk reference designator; ref_on_fab moves it to
    Fab instead (dense matrix: silk refs sit on neighbour silk/pads);
    ref_shift offsets the Reference field's local coordinates (per-half
    silk-collision dodge; PWR uses mirrored x signs across the halves);
    strip_silk drops F.SilkS graphics (SOD-123: the cathode bar sits 0.2mm
    from the pad and trips angle-dependent DRC noise; Fab keeps polarity).
    cathode_tick re-adds a minimal cathode tick for stripped SOD-123s:
    1.0mm bar just outside pad 1 (cathode) at 0.29mm local clearance, so
    on-board polarity stays readable after placement (independent review
    F1). Local geometry rotates with the footprint, so the clearance is
    rotation-proof; DRC re-verifies every placed rotation.
    """
    s = re.sub(r'\(footprint "[^"]*"', f'(footprint "{libref}"', src, count=1)
    s = re.sub(r'(\(layer "F\.Cu"\)\n)',
               rf'\1\t(uuid "{U()}")\n\t(at {r2(x)} {r2(y)} {r2(rot)})\n',
               s, count=1)
    s = re.sub(r'\(property "Reference" "[^"]*"',
               f'(property "Reference" "{ref}"', s, count=1)
    # ref_shift nudges the silk Reference field off the stock position
    # (M3: the PWR switch moved +4.3 inboard; the 8-char ref string is
    # left-justified and pronounced into the nice!nano socket's silk
    # spill at x>=109.05, y~48.07 — M2 avoided this only because the
    # switch sat 4.3mm further west). Keeps the ref on-board and clear.
    if ref_shift[0] or ref_shift[1]:
        def ref_at(m):
            toks = m.group(2).split()
            rest = toks[2:] if len(toks) > 2 else []
            at = (f"{r2(float(toks[0]) + ref_shift[0])} "
                  f"{r2(float(toks[1]) + ref_shift[1])}")
            if rest:
                at += " " + " ".join(rest)
            return f"{m.group(1)}{at}{m.group(3)}"
        s = re.sub(r'(\(property "Reference" "[^"]*"\n\t\t\(at )([^)]*)(\))',
                   ref_at, s, count=1)
    if hide_ref:
        s = re.sub(r'(\(property "Reference" "[^"]*"\n\t\t\(at [^)]*\)\n'
                   r'\t\t\(layer "[^"]*"\))',
                   r'\1\n\t\t(hide yes)', s, count=1)
    if ref_on_fab:
        s = re.sub(r'(\(property "Reference" "[^"]*"\n\t\t\(at [^)]*\)\n'
                   r'\t\t\(layer ")F\.SilkS(")',
                   r'\1F.Fab\2', s, count=1)
    if strip_silk:
        s = strip_layer_graphics(s, "F.SilkS")
    s = re.sub(r'\(property "Value" "[^"]*"',
               f'(property "Value" "{value}"', s, count=1)

    def padsub(blk, num):
        if num and num in pin_nets and "(net " not in blk:
            code, name = pin_nets[num]
            if "(uuid " in blk:
                blk = blk.replace("(uuid ", f'(net {code} "{name}") (uuid ',
                                  1)
            else:
                blk = blk[:-1].rstrip() + f' (net {code} "{name}")\n\t)'
        return blk

    out = []
    i = 0
    while i < len(s):
        m = re.search(r'\(pad "([^"]*)"', s[i:])
        if not m:
            out.append(s[i:])
            break
        j = i + m.start()
        out.append(s[i:j])
        depth, k = 0, j
        while True:
            if s[k] == "(":
                depth += 1
            elif s[k] == ")":
                depth -= 1
                if depth == 0:
                    break
            k += 1
        out.append(padsub(s[j:k + 1], m.group(1)))
        i = k + 1
    s = "".join(out)
    s = re.sub(r'uuid "[^"]*"', lambda m: f'uuid "{U()}"', s)
    if cathode_tick:
        s = (s.rstrip()[:-1].rstrip() +
             f'\n\t(fp_line (start -2.45 -0.5) (end -2.45 0.5)'
             f' (stroke (width 0.12) (type solid)) (layer "F.SilkS")'
             f' (uuid "{U()}"))\n)')
    if ":" in libref:
        _lib, _name = libref.split(":", 1)
        if (_lib, _name) in MODEL_OVERRIDES:
            _path, _off, _rot = MODEL_OVERRIDES[(_lib, _name)]
            _new = (f'\t(model "{_path}"\n'
                    f'\t\t(offset\n\t\t\t{_off}\n\t\t)\n'
                    f'\t\t(scale\n\t\t\t(xyz 1 1 1)\n\t\t)\n'
                    f'\t\t(rotate\n\t\t\t{_rot}\n\t\t)\n'
                    f'\t)')
            s, _n = re.subn(
                r'\t\(model "[^"]*"\n'
                r'(?:\t\t\(\w+\n\t\t\t\(xyz [^)]*\)\n\t\t\)\n)+'
                r'\t\)', _new, s)
            assert _n == 1, f"model override missed for {libref}"
    return s


def ref_nets(pin_net, ref):
    """{pin: (code, name)} for one refdes."""
    return {p: v for (r, p), v in pin_net.items() if r == ref}


def cw_rotate(x, y, deg):
    """KiCad clockwise-positive rotation of a local point."""
    a = math.radians(deg)
    return (x * math.cos(a) + y * math.sin(a),
            -x * math.sin(a) + y * math.cos(a))


def outline_loops(side):
    """Closed Edge.Cuts loops for one side, largest first."""
    ents = load_dxf_entities()
    segs = []
    for e in ents:
        if e[0] == "line":
            _, x1, y1, x2, y2 = e
            if side == "L" and max(x1, x2) >= MIRROR_AXIS:
                continue
            if side == "R" and min(x1, x2) < MIRROR_AXIS:
                continue
            segs.append(((x1, y1), (x2, y2)))
        else:
            _, cx, cy, r, a1, a2 = e
            if side == "L" and cx >= MIRROR_AXIS:
                continue
            if side == "R" and cx < MIRROR_AXIS:
                continue
            segs.extend(arc_segments(cx, cy, r, a1, a2))
    # chain into loops (segments usable in either direction)
    def key(p):
        return (round(p[0], 2), round(p[1], 2))
    adj = {}
    for a, b in segs:
        adj.setdefault(key(a), []).append((a, b))
        adj.setdefault(key(b), []).append((a, b))
    used = set()
    loops = []
    for idx, (a0, b0) in enumerate(segs):
        if idx in used:
            continue
        loop, cur, prev = [key(a0)], key(b0), key(a0)
        # mark first segment used
        for j, (a, b) in enumerate(segs):
            if j not in used and ((key(a) == prev and key(b) == cur)
                                  or (key(b) == prev and key(a) == cur)):
                used.add(j)
                break
        while cur != loop[0]:
            nxt = None
            for j, (a, b) in enumerate(segs):
                if j in used:
                    continue
                if key(a) == cur and key(b) != prev:
                    nxt = (j, key(b))
                    break
                if key(b) == cur and key(a) != prev:
                    nxt = (j, key(a))
                    break
            if nxt is None:
                # dead end: try any unused segment touching cur (T-junction)
                for j, (a, b) in enumerate(segs):
                    if j in used:
                        continue
                    if key(a) == cur:
                        nxt = (j, key(b))
                        break
                    if key(b) == cur:
                        nxt = (j, key(a))
                        break
            if nxt is None:
                raise RuntimeError(f"outline {side}: open loop at {cur}")
            used.add(nxt[0])
            prev, cur = cur, nxt[1]
            loop.append(cur)
            assert len(loop) < len(segs) + 2, f"outline {side}: loop runaway"
        loops.append(loop)
    def area(loop):
        return sum(loop[i][0] * loop[(i + 1) % len(loop)][1]
                   - loop[(i + 1) % len(loop)][0] * loop[i][1]
                   for i in range(len(loop))) / 2
    loops.sort(key=lambda l: -abs(area(l)))
    return loops


def inside_outline(loops, x, y):
    """In largest loop and not inside any smaller (notch/hole) loop."""
    def inside(loop):
        c = False
        n = len(loop)
        for i in range(n):
            x1, y1 = loop[i]
            x2, y2 = loop[(i + 1) % n]
            if ((y1 > y) != (y2 > y)):
                xin = (x2 - x1) * (y - y1) / (y2 - y1) + x1
                if x < xin:
                    c = not c
        return c
    if not loops or not inside(loops[0]):
        return False
    return not any(inside(l) for l in loops[1:])


def footprint_pads(src, numbered=True):
    """[(number, x, y)] for pads in a .kicad_mod.

    numbered=True (default): only net-assignable pads. numbered=False also
    returns NPTH/mechanical "" pads — needed for clearance searches (a
    tooling hole drilled 1.5mm from a switch mounting hole proved it).
    """
    return [(m.group(1), float(m.group(2)), float(m.group(3)))
            for m in re.finditer(r'\(pad "([^"]*)"\s+\S+\s+\S+\s*\(at ([-\d.]+) ([-\d.]+)',
                                 src) if (m.group(1) or not numbered)]


def courtyard_segments(src, circle_steps=16):
    """F.CrtYd outline as segments (circles approximated), footprint-local."""
    segs = []
    s = src

    def blocks():
        i = 0
        while True:
            m = re.search(
                r"\n\t\((fp_line|fp_rect|fp_circle|fp_arc|fp_poly)[\s]", s[i:])
            if not m:
                return
            j = i + m.start()
            depth, k = 0, j + 1
            while True:
                if s[k] == "(":
                    depth += 1
                elif s[k] == ")":
                    depth -= 1
                    if depth == 0:
                        break
                k += 1
            yield s[j:k + 1]
            i = k + 1

    for blk in blocks():
        if '(layer "F.CrtYd")' not in blk:
            continue
        if blk.startswith("\n\t(fp_line"):
            a = re.search(r"\(start ([-\d.]+) ([-\d.]+)\)", blk)
            b = re.search(r"\(end ([-\d.]+) ([-\d.]+)\)", blk)
            segs.append(((float(a.group(1)), float(a.group(2))),
                         (float(b.group(1)), float(b.group(2)))))
        elif blk.startswith("\n\t(fp_rect"):
            a = re.search(r"\(start ([-\d.]+) ([-\d.]+)\)", blk)
            b = re.search(r"\(end ([-\d.]+) ([-\d.]+)\)", blk)
            x1, y1, x2, y2 = (float(a.group(1)), float(a.group(2)),
                              float(b.group(1)), float(b.group(2)))
            c = [(x1, y1), (x2, y1), (x2, y2), (x1, y2)]
            segs += list(zip(c, c[1:] + c[:1]))
        elif blk.startswith("\n\t(fp_circle"):
            c = re.search(r"\(center ([-\d.]+) ([-\d.]+)\)", blk)
            e = re.search(r"\(end ([-\d.]+) ([-\d.]+)\)", blk)
            cx, cy = float(c.group(1)), float(c.group(2))
            r = math.hypot(float(e.group(1)) - cx, float(e.group(2)) - cy)
            pts = [(cx + r * math.cos(2 * math.pi * k / circle_steps),
                    cy + r * math.sin(2 * math.pi * k / circle_steps))
                   for k in range(circle_steps)]
            segs += list(zip(pts, pts[1:] + pts[:1]))
    return segs


def check_containment(tag, placements):
    """Every numbered pad must sit inside its half's outline.

    Would have caught the original TRRS error (mouth-end pads off-board)
    which DRC does not check.
    """
    loops = outline_loops(tag)
    bad = []
    for kind, lib, name, ref, value, x, y, rot, *_ in placements:
        if kind in ("FID", "TOOL"):
            if not inside_outline(loops, x, y):
                bad.append(f"{ref} at ({r2(x)}, {r2(y)})")
            continue
        src = fp_source(lib, name)
        for num, px, py in footprint_pads(src):
            gx, gy = cw_rotate(px, py, rot)
            if not inside_outline(loops, x + gx, y + gy):
                bad.append(f"{ref}.{num} at ({r2(x + gx)}, {r2(y + gy)})")
    print(f"  containment {tag}: {len(placements)} "
          f"footprints checked" + ("" if not bad else f" — {len(bad)} OFF-BOARD"))
    for b in bad[:10]:
        print(f"  !! off-board pad {b}")
    assert not bad, f"{len(bad)} pads outside the {tag} outline"


def strip_layer_graphics(s, layer):
    """Drop top-level fp_* graphics blocks on one layer (keep pads/text)."""
    out = []
    i = 0
    while i < len(s):
        m = re.search(r"\n\t\((fp_line|fp_rect|fp_circle|fp_arc|fp_poly|fp_curve|fp_text)[\s]",
                      s[i:])
        if not m:
            out.append(s[i:])
            break
        j = i + m.start()
        out.append(s[i:j])
        depth, k = 0, j + 1
        while True:
            if s[k] == "(":
                depth += 1
            elif s[k] == ")":
                depth -= 1
                if depth == 0:
                    break
            k += 1
        blk = s[j:k + 1]
        if f'(layer "{layer}")' not in blk:
            out.append(blk)
        i = k + 1
    return "".join(out)


def seg_dist(px, py, a, b):
    """Distance from a point to a segment."""
    (ax, ay), (bx, by) = a, b
    dx, dy = bx - ax, by - ay
    L2 = dx * dx + dy * dy
    t = 0.0 if L2 == 0 else max(0.0, min(1.0, ((px - ax) * dx + (py - ay) * dy) / L2))
    return math.hypot(px - (ax + t * dx), py - (ay + t * dy))


# ---------------------------------------------------------------- fiducials

FID_EDGE_MM = 3.0  # min distance from any Edge.Cuts segment (fix.md P0-2)
FID_PAD_MM = 3.0   # min distance from any placed pad centre (mask clearance)


def pick_fiducials(tag, placements, n=3):
    """n fiducial centres on real board area, clear of the edge and pads.

    Targets are the old intent (outer top-left, outer top-right, bottom
    centre) but each one snaps to the nearest valid 1 mm grid point. The old
    bbox-corner rule put all six fiducials outside the irregular outline.
    """
    loops = outline_loops(tag)
    edges = [(a, b) for loop in loops
             for a, b in zip(loop, loop[1:] + loop[:1])]
    pads = []
    for kind, lib, name, ref, value, x, y, rot, *_ in placements:
        if kind == "FID":
            continue
        for num, px, py in footprint_pads(fp_source(lib, name),
                                          numbered=False):
            gx, gy = cw_rotate(px, py, rot)
            pads.append((x + gx, y + gy))

    xs = [p[0] for loop in loops for p in loop]
    ys = [p[1] for loop in loops for p in loop]
    x0, x1, y0, y1 = min(xs), max(xs), min(ys), max(ys)
    cands = []
    for gx in range(math.floor(x0), math.ceil(x1) + 1):
        for gy in range(math.floor(y0), math.ceil(y1) + 1):
            if not inside_outline(loops, gx, gy):
                continue
            if min(seg_dist(gx, gy, a, b) for a, b in edges) < FID_EDGE_MM:
                continue
            if any(math.hypot(gx - px, gy - py) < FID_PAD_MM for px, py in pads):
                continue
            cands.append((float(gx), float(gy)))
    assert cands, f"{tag}: no valid fiducial spot inside the outline"

    targets = [(x0 + 6, y1 - 6), (x1 - 6, y1 - 6), ((x0 + x1) / 2, y0 + 6)]
    chosen = []
    for tx, ty in targets[:n]:
        free = [c for c in cands
                if all(math.hypot(c[0] - q[0], c[1] - q[1]) >= 20 for q in chosen)]
        best = min(free or cands,
                   key=lambda c: math.hypot(c[0] - tx, c[1] - ty))
        chosen.append(best)
    print(f"  fiducials {tag}: " + ", ".join(f"({x:.0f},{y:.0f})" for x, y in chosen))
    return chosen


def pick_tooling(tag, placements, fiducials, n=2):
    """n 3.2mm NPTH tooling holes: inside, far from edge/pads/fiducials.

    Gasket mounting uses no PCB holes, but SMD assembly wants fab tooling.
    Stricter clearances than fiducials (drill breaks out near copper), and
    courtyard-aware: pad centres alone miss courtyard corners (MT_L1 vs
    SW_L12 proved it — 11.4mm centre distance still overlapped).
    """
    loops = outline_loops(tag)
    edges = [(a, b) for loop in loops
             for a, b in zip(loop, loop[1:] + loop[:1])]
    pads = []
    crt = []
    boxes = []
    for kind, lib, name, ref, value, x, y, rot, *_ in placements:
        if kind in ("FID", "TOOL"):
            continue
        src = fp_source(lib, name)
        for num, px, py in footprint_pads(src, numbered=False):
            gx, gy = cw_rotate(px, py, rot)
            pads.append((x + gx, y + gy))
        pts = []
        for (ax, ay), (bx, by) in courtyard_segments(src):
            gax, gay = cw_rotate(ax, ay, rot)
            gbx, gby = cw_rotate(bx, by, rot)
            crt.append(((x + gax, y + gay), (x + gbx, y + gby)))
            pts += [(x + gax, y + gay), (x + gbx, y + gby)]
        if pts:
            # grown by the tooling courtyard radius: a candidate INSIDE a
            # courtyard still has segment distance > 0, so the segment test
            # alone passes holes right through courtyards.
            xs2 = [p[0] for p in pts]
            ys2 = [p[1] for p in pts]
            boxes.append((min(xs2) - 3.7, min(ys2) - 3.7,
                          max(xs2) + 3.7, max(ys2) + 3.7))
    xs = [p[0] for loop in loops for p in loop]
    ys = [p[1] for loop in loops for p in loop]
    x0, x1, y0, y1 = min(xs), max(xs), min(ys), max(ys)
    cands = []
    for gx in range(math.floor(x0), math.ceil(x1) + 1):
        for gy in range(math.floor(y0), math.ceil(y1) + 1):
            if not inside_outline(loops, gx, gy):
                continue
            if min(seg_dist(gx, gy, a, b) for a, b in edges) < 4.0:
                continue
            if any(math.hypot(gx - px, gy - py) < 5.0 for px, py in pads):
                continue
            if any(bx0 <= gx <= bx1 and by0 <= gy <= by1
                   for bx0, by0, bx1, by1 in boxes):
                continue
            if any(seg_dist(gx, gy, a, b) < 3.7 for a, b in crt):
                continue
            cands.append((float(gx), float(gy)))
    assert cands, f"{tag}: no valid tooling-hole spot inside the outline"
    targets = [(x0 + 8, (y0 + y1) / 2), (x1 - 8, (y0 + y1) / 2)]
    chosen = []
    for tx, ty in targets[:n]:
        taken = fiducials + chosen
        free = [c for c in cands
                if all(math.hypot(c[0] - q[0], c[1] - q[1]) >= 20 for q in taken)]
        best = min(free or cands,
                   key=lambda c: math.hypot(c[0] - tx, c[1] - ty))
        chosen.append(best)
    print(f"  tooling {tag}: " + ", ".join(f"({x:.0f},{y:.0f})" for x, y in chosen))
    return chosen


# ---------------------------------------------------------------- copper
#
# Ownership split: the generator owns the outline, footprints, nets and
# placement; a human (or a router) owns copper. gen_pcb.py rebuilds the whole
# board body from scratch, so routed tracks would otherwise be thrown away by
# the next run — a fake segment injected into a sandbox copy did not survive
# build_board(). Preserved copper is remapped by net NAME (net codes are
# assigned per netlist export and are not stable) and then checked: every
# preserved track must still terminate on real copper, and none may enter the
# antenna keepout. A footprint that moves without re-routing therefore fails
# the build instead of producing a silently broken board.

ANT_R_MM = 5.0   # antenna keepout: no COPPER within 5.0mm of the
                  # antenna centre (edge-based: track centerline clears
                  # 5.0 + width/2, vias clear 5.0 + size/2 — the annular
                  # ring, not the drill hole)
COPPER_KINDS = ("segment", "via", "zone")


def top_level_items(s):
    """[(start, end, keyword)] for the board items inside (kicad_pcb ...).

    Depth 1 is a board item: the whole file is one s-expression, so the
    items to walk are the children of the root, not the root itself.
    """
    items, depth, start, keyword = [], 0, None, None
    in_str = esc = False
    for i, c in enumerate(s):
        if in_str:
            if esc:
                esc = False
            elif c == "\\":
                esc = True
            elif c == '"':
                in_str = False
        elif c == '"':
            in_str = True
        elif c == "(":
            if depth == 1:
                start = i
                m = re.match(r"\(([A-Za-z_][\w.-]*)", s[i:])
                keyword = m.group(1) if m else None
            depth += 1
        elif c == ")":
            depth -= 1
            if depth == 1 and start is not None:
                items.append((start, i + 1, keyword))
                start = None
    assert depth == 0, "unbalanced parentheses in board file"
    return items


def git_track_text(path):
    """Committed content of path at HEAD; None if the path is not in HEAD.

    Extraction reads the committed baseline, never the working file: a
    failed build on disk (DRC rejects it after the write) would otherwise
    become the next run's cut input and compound its damage — the failure
    mode that churned kept-classification across this week's runs.
    """
    rel = os.path.relpath(path, REPO)
    r = subprocess.run(["git", "cat-file", "-e", f"HEAD:{rel}"],
                       capture_output=True, cwd=REPO)
    if r.returncode != 0:
        return None
    r = subprocess.run(["git", "show", f"HEAD:{rel}"],
                       capture_output=True, text=True, cwd=REPO)
    assert r.returncode == 0, f"git show HEAD:{rel} failed:\n{r.stderr}"
    return r.stdout


def extract_copper_text(s, name_code, label):
    """[(kind, raw_block)] of existing copper, net codes remapped by name.

    A net the new netlist does not know is a hard error: silently renumbering
    would weld a track onto the wrong net, which DRC only notices as an
    unconnected item somewhere else.
    """
    code_name = {int(m.group(1)): m.group(2)
                 for m in re.finditer(r"\n\t\(net (\d+) \"([^\"]*)\"\)", s)}
    out = []
    for a, b, kw in top_level_items(s):
        if kw not in COPPER_KINDS:
            continue
        blk = s[a:b]
        m = re.search(r"\(net (\d+)\)", blk)
        if m:
            old = int(m.group(1))
            nm = re.search(r'\(net_name "([^"]*)"\)', blk)
            name = nm.group(1) if nm and nm.group(1) in name_code \
                else code_name.get(old)
            if name is None:
                raise RuntimeError(f"{label}: copper on net "
                                   f"code {old} with no name")
            if name not in name_code:
                raise RuntimeError(
                    f"{label}: preserved copper is on net "
                    f"'{name}', which the schematic no longer has — delete or "
                    f"re-route it")
            blk = blk.replace(f"(net {old})", f"(net {name_code[name]})", 1)
        out.append((kw, blk))
    return out


HAND_FILE = os.path.join(PCB_DIR, "hand-copper.txt")


def parse_hand_manifest(tag):
    """[(kind, net, layer, coords)] from pcb/kicad/hand-copper.txt for `tag`.

    The authoritative set of hand-tuned copper: only items whose signature
    matches a line under this half's [Left]/[Right] section are preserved
    across a regen; everything else is router-owned and regenerated.
    Coordinates are r2-rounded the way the generators write them. Lines
    under the other half's section are syntax-checked but not collected.
    Supported forms:

        segment NET LAYER x1,y1 -> x2,y2
        via NET x,y size,drill
        zone NET x1,y1 x2,y2 x3,y3        (first three outline points)
    """
    out = []
    cur = None
    if not os.path.exists(HAND_FILE):
        return out
    for i, ln in enumerate(open(HAND_FILE), 1):
        s = ln.strip()
        if not s or s.startswith("#"):
            continue
        if s in ("[Left]", "[Right]"):
            cur = {"[Left]": "L", "[Right]": "R"}[s]
            continue
        try:
            p = s.split()
            if p[0] == "segment":
                x1, y1 = (float(v) for v in p[3].split(","))
                x2, y2 = (float(v) for v in p[5].split(","))
                item = ("segment", p[1], p[2],
                        (round(x1, 2), round(y1, 2),
                         round(x2, 2), round(y2, 2)))
            elif p[0] == "via":
                x, y = (float(v) for v in p[2].split(","))
                size, drill = (float(v) for v in p[3].split(","))
                item = ("via", p[1], None,
                        (round(x, 2), round(y, 2),
                         round(size, 2), round(drill, 2)))
            elif p[0] == "zone":
                pts = [tuple(float(v) for v in q.split(",")) for q in p[2:5]]
                item = ("zone", p[1], None,
                        tuple(round(c, 2) for pt in pts for c in pt))
            else:
                raise ValueError(f"unknown kind {p[0]!r}")
        except (ValueError, IndexError) as e:
            sys.exit(f"{HAND_FILE}:{i}: bad line {s!r}: {e}")
        if cur == tag:
            out.append(item)
    return out


def copper_signature(kind, blk, n2c):
    """Manifest-comparable signature of one copper block, or None.

    Same 4-tuple shape as manifest entries: (kind, net, layer, coords).
    """
    mn = re.search(r"\(net (\d+)\)", blk)
    if not mn:
        return None
    net = n2c.get(int(mn.group(1)))
    r2 = lambda x: round(float(x), 2)
    if kind == "segment":
        g = re.search(r"\(start ([\d.-]+) ([\d.-]+)\)\s*"
                      r"\(end ([\d.-]+) ([\d.-]+)\)", blk)
        mly = re.search(r'\(layer "([^"]+)"\)', blk)
        if not (g and mly):
            return None
        return ("segment", net, mly.group(1),
                (r2(g.group(1)), r2(g.group(2)),
                 r2(g.group(3)), r2(g.group(4))))
    if kind == "via":
        g = re.search(r"\(at ([\d.-]+) ([\d.-]+)\)", blk)
        z = re.search(r"\(size ([\d.-]+)\)", blk)
        d = re.search(r"\(drill ([\d.-]+)\)", blk)
        if not g:
            return None
        return ("via", net, None,
                (r2(g.group(1)), r2(g.group(2)),
                 r2(z.group(1)) if z else 0.0,
                 r2(d.group(1)) if d else 0.0))
    if kind == "zone":
        pts = re.findall(r"\(xy ([\d.-]+) ([\d.-]+)\)", blk)
        if len(pts) < 3:
            return None
        flat = [v for a, b in pts[:3] for v in (r2(a), r2(b))]
        return ("zone", net, None, tuple(flat))
    return None


def manifest_line(item):
    """Manifest-format text for one signature (paste-ready debug output)."""
    kind, net, layer, v = item
    if kind == "segment":
        return (f"segment {net} {layer} "
                f"{v[0]:.2f},{v[1]:.2f} -> {v[2]:.2f},{v[3]:.2f}")
    if kind == "via":
        return f"via {net} {v[0]:.2f},{v[1]:.2f} {v[2]:.2f},{v[3]:.2f}"
    pts = " ".join(f"{v[i]:.2f},{v[i+1]:.2f}" for i in range(0, len(v), 2))
    return f"zone {net} {pts}"


def copper_pieces(copper, code_name):
    """(segments, vias) as {net name: [(...)]} for the dangling check.

    Segments carry their copper half-width (parsed from (width ..),
    default 0.125mm) and vias their drill + outer radius (parsed from
    (drill ..), default 0.4mm, and (size ..), default 0.6mm), so the
    antenna-keepout gate tests the copper EDGE against the 5.0mm
    radius, not the track centerline.
    """
    segs, vias = {}, {}
    for kind, blk in copper:
        m = re.search(r"\(net (\d+)\)", blk)
        if not m:
            continue
        name = code_name[int(m.group(1))]
        if kind == "segment":
            g = re.search(r"\(start ([\d.-]+) ([\d.-]+)\)\s*"
                          r"\(end ([\d.-]+) ([\d.-]+)\)", blk)
            w = re.search(r"\(width ([\d.-]+)\)", blk)
            try:
                hw = float(w.group(1)) / 2 if w else 0.125
            except ValueError:
                hw = 0.125
            segs.setdefault(name, []).append(
                (float(g.group(1)), float(g.group(2)),
                 float(g.group(3)), float(g.group(4)), hw))
        elif kind == "via":
            g = re.search(r"\(at ([\d.-]+) ([\d.-]+)\)", blk)
            z = re.search(r"\(size ([\d.-]+)\)", blk)
            d = re.search(r"\(drill ([\d.-]+)\)", blk)
            try:
                # the KEEPOUT is copper-edge vs radius: the via's outer
                # radius is size/2 (annular ring), NOT drill/2 — using the
                # drill under-enforces by (size-drill)/2, the hole is
                # smaller than the copper that touches the keepout
                out_r = float(z.group(1)) / 2 if z else 0.3
            except ValueError:
                out_r = 0.3
            drill = float(d.group(1)) if d else 0.4
            vias.setdefault(name, []).append(
                (float(g.group(1)), float(g.group(2)), drill, out_r))
    return segs, vias


def check_copper(tag, copper, placements, code_name, pts, dangle_items=None):
    """Copper must attach to copper and avoid the antenna keepout.

    Keepout is edge-based (spec: no copper within 5.0mm): track centerlines
    must clear 5.0 + width/2, via centres 5.0 + drill/2. Touch/dangle
    accounting runs on the MERGED board (router + preserved) — a GUI chain
    may legitimately junction into router-generated segments.

    `dangle_items` (default: all of `copper`) restricts which items the
    DANGLING check reports on. It must stay the preserved/GUI set: the
    invisible break this gate exists for ("move a footprint, regenerate,
    the old track now ends in the middle of nowhere") can only happen to
    copper that SURVIVES regeneration; router output is rebuilt from the
    current placements every run and its stub-ends near vias connect by
    copper overlap, not coordinate coincidence.
    """
    segs, vias = copper_pieces(copper, code_name)
    dsegs, dvias = copper_pieces(dangle_items, code_name) \
        if dangle_items is not None else (segs, vias)
    pads = {}
    for p in placements:
        kind, lib, name, ref, value, x, y, rot = p[:8]
        pn = p[11]
        for num, px, py in footprint_pads(fp_source(lib, name)):
            if num not in pn:
                continue
            gx, gy = cw_rotate(px, py, rot)
            pads.setdefault(pn[num][1], []).append((x + gx, y + gy))

    def same(a, b):
        return math.hypot(a[0] - b[0], a[1] - b[1]) < 0.01

    bad = []
    for name, ss in dsegs.items():
        all_ss = segs.get(name, [])
        plist, vlist = pads.get(name, []), vias.get(name, [])
        for i, seg in enumerate(ss):
            for pt in (seg[:2], seg[2:4]):
                touch = (sum(same(pt, q) for q in plist)
                         + sum(same(pt, q[:2]) for q in vlist)
                         + sum(1 for k, o in enumerate(all_ss)
                               if o is not seg and (same(pt, o[:2]) or same(pt, o[2:4]))))
                touch += sum(1 for o in all_ss
                             if o is not seg and
                             seg_dist(pt[0], pt[1], o[:2], o[2:4]) < 0.01)
                if touch == 0:
                    bad.append(f"{name}: dangling track end at "
                               f"({r2(pt[0])}, {r2(pt[1])})")
    for name, vs in dvias.items():
        plist = pads.get(name, [])
        ends = [e for s in segs.get(name, []) for e in (s[:2], s[2:4])]
        for vx, vy, _drill, _out in vs:
            pt = (vx, vy)
            touch = (sum(same(pt, q) for q in plist)
                     + sum(same(pt, q) for q in ends))
            if touch == 0:
                bad.append(f"{name}: dangling via at "
                           f"({r2(vx)}, {r2(vy)})")

    ax, ay, _ = pts["antenna" if tag == "L" else "mirror_antenna"]
    for name, ss in segs.items():
        for x1, y1, x2, y2, hw in ss:
            d = seg_dist(ax, ay, (x1, y1), (x2, y2))
            if d < ANT_R_MM + hw - 1e-9:
                bad.append(f"{name}: track passes {r2(d)}mm from the antenna "
                           f"centre (keepout r={ANT_R_MM})")
    for name, vs in vias.items():
        for vx, vy, _drill, out_r in vs:
            d = math.hypot(vx - ax, vy - ay)
            if d < ANT_R_MM + out_r - 1e-9:
                bad.append(f"{name}: via {r2(d)}mm from the antenna centre "
                           f"(keepout r={ANT_R_MM} + annular {r2(out_r)})")

    # Zones are copper too: a rev-2 GND pour must never land inside (or
    # touch) the keepout. Gate on the zone's authored rings — even-odd
    # inside test for fill-vs-holes plus ring-edge distance, so a pour
    # with a keepout cutout passes only if the cutout really keeps r out.
    for k, blk in copper:
        if k != "zone" or not re.search(r'\(layer "?[FB]\.Cu', blk):
            continue
        rings, i = [], 0
        while True:
            i = blk.find("(pts", i)
            if i < 0:
                break
            j, depth = i + 4, 1
            while depth and j < len(blk):
                if blk[j] == "(":
                    depth += 1
                elif blk[j] == ")":
                    depth -= 1
                j += 1
            inner = blk[i + 4:j - 1]
            rings.append([(float(a), float(b)) for a, b in
                          re.findall(r"\(xy ([-\d.]+) ([-\d.]+)\)", inner)])
            i = j

        def _in_ring(pt, ring):
            s, n = 0, len(ring)
            for a in range(n):
                x1, y1 = ring[a]
                x2, y2 = ring[(a + 1) % n]
                if (y1 > pt[1]) != (y2 > pt[1]):
                    s += (pt[0] - x1) * (y2 - y1) < (x2 - x1) * (pt[1] - y1)
            return s % 2 == 1

        in_fill = sum(_in_ring((ax, ay), r) for r in rings) % 2 == 1
        dmin = min((seg_dist(ax, ay, ring[a], ring[(a + 1) % len(ring)])
                    for ring in rings for a in range(len(ring))),
                   default=1e9)
        if in_fill:
            bad.append("zone lands inside the antenna keepout (centre in fill)")
        elif dmin < ANT_R_MM - 1e-9:
            bad.append(f"zone edge passes {r2(dmin)}mm from the antenna "
                       f"centre (keepout r={ANT_R_MM})")

    n = sum(1 for k, _ in copper if k == "segment")
    nv = sum(1 for k, _ in copper if k == "via")
    nz = sum(1 for k, _ in copper if k == "zone")
    print(f"  copper {tag}: {n} segments, {nv} vias, {nz} zones preserved"
          + ("" if not bad else f" — {len(bad)} PROBLEM"))
    for b in bad[:10]:
        print(f"  !! {b}")
    assert not bad, f"{len(bad)} copper problems on {tag}"


# ---------------------------------------------------------------- build

def build_placements(tag, pts, pin_net):
    """49 schematic placements + fiducials + tooling (no file I/O)."""
    placements = []

    keys = key_points(pts, tag)
    for idx, pname, x, y, rot in keys:
        placements.append(("SW", *FP_SRC["SW"], f"SW_{tag}{idx:02d}",
                           f"K{idx:02d}", x, y, krot(rot), False, True, False,
                           ref_nets(pin_net, f"SW_{tag}{idx:02d}")))
        # Diode in the inter-key gap beside its switch. The RIGHT half is a
        # true mirror: offset direction negates (east on L, west on R) while
        # the body rotation stays krot+90 — mod 180 that IS the mirrored axis
        # (-(k+90) == -k+90), and N/S polarity is preserved across the mirror
        # (nets follow pad numbers either way). Same-side offsets would pile
        # the outer-column diode against the board edge instead of the gap.
        sgn = 1 if tag == "L" else -1
        dx = sgn * 9.5 * math.cos(math.radians(rot))
        dy = sgn * 9.5 * math.sin(math.radians(rot))
        placements.append(("DIODE", *FP_SRC["DIODE"], f"D_{tag}{idx:02d}",
                           "1N4148W", x + dx, y + dy, krot(rot) + 90,
                           False, True, True,
                           ref_nets(pin_net, f"D_{tag}{idx:02d}")))

    mx, my, _ = pts["mcu" if tag == "L" else "mirror_mcu"]
    # socket USB end (local y=0) faces north: rot 180, pad-centre on mcu,
    # shifted 0.5mm south so the silk top clears the USB-notch cutout.
    # Vendored-source guard (audit 2026-10-20): the 2x12 strip's two pad
    # COLUMNS must be exactly 15.24 apart (nice!nano standard), at the
    # pinned local xs {-15.24, 0} (origin on pad column 1 — see
    # gen_schematic's 15.24 notes; the placement's -7.62 shift + rot 180
    # then straddles the mcu anchor ±7.62). The W1 content gate compares
    # committed-vs-vendored and would certify a drifted vendored file,
    # so the source itself is pinned here.
    _xcol = sorted({round(float(m.group(1)), 4) for m in re.finditer(
        r'\(pad "[^"]*" (?:smd|thru_hole) [^)]*?\(at ([-\d.]+) ([-\d.]+)',
        fp_source(*FP_SRC["MCU"]))})
    assert len(_xcol) == 2 and \
        abs((_xcol[1] - _xcol[0]) - 15.24) < 1e-3 and \
        abs(_xcol[0] + 15.24) < 1e-3, \
        f"MCU socket pad columns drifted: xs {_xcol} (want {{-15.24, 0}})"
    placements.append(("MCU", *FP_SRC["MCU"], f"U_{tag}1", "nice!nano v2",
                       mx - 7.62, my + 13.97 - 0.5, 180, False, False, False,
                       ref_nets(pin_net, f"U_{tag}1")))

    ex, ey, _ = pts["encoder" if tag == "L" else "mirror_encoder"]
    # stock origin is pad A; shaft centre is +(7.5, 2.5).
    placements.append(("ENC", *FP_SRC["ENC"], f"ENC_{tag}1", "EC11E-Switch",
                       ex - 7.5, ey - 2.5, 0, False, False, False,
                       ref_nets(pin_net, f"ENC_{tag}1")))

    tx, ty, _ = pts["trrs" if tag == "L" else "mirror_trrs"]
    # stock mouth at local +Y (sleeve text y=11.4, silk top 12.6); face the
    # split gap with the body 2mm inboard of the anchor so the mouth-end
    # pads stay on copper AND the mouth silk clears the slanted inner edge
    # (the edge leans 2.77mm over the jack height — mouth-at-anchor+8.5
    # would hang T/S pads off the board).
    if tag == "L":
        placements.append(("TRRS", *FP_SRC["TRRS"], f"J_{tag}1",
                           "PJ-320A TRRS", tx - 8.05, ty, 90,
                           False, False, False,
                           ref_nets(pin_net, f"J_{tag}1")))
    else:
        placements.append(("TRRS", *FP_SRC["TRRS"], f"J_{tag}1",
                           "PJ-320A TRRS", tx + 8.05, ty, 270,
                           False, False, False,
                           ref_nets(pin_net, f"J_{tag}1")))

    jx, jy, _ = pts["jst" if tag == "L" else "mirror_jst"]
    placements.append(("JST", *FP_SRC["JST"], f"J_{tag}2", "BATT_LIPO",
                       jx, jy, 0, False, False, False,
                       ref_nets(pin_net, f"J_{tag}2")))

    px, py, _ = pts["pwrsw" if tag == "L" else "mirror_pwrsw"]
    placements.append(("PWR", *FP_SRC["PWR"], f"SW_{tag}PWR1", "PWR_SW",
                       px, py, 0, False, False, False,
                       ref_nets(pin_net, f"SW_{tag}PWR1")))

    # every schematic footprint must be placed exactly once (no extras, none
    # missing) — otherwise net parity is a lie.
    placed_refs = {p[3] for p in placements}
    # pin_net only holds refs that own nets; power symbols own none. The
    # schematic-placement cross-check lives in gen_schematic; here assert the
    # 49 expected schematic footprints are present.
    want = {f"SW_{tag}{i:02d}" for i in range(22)} | \
        {f"D_{tag}{i:02d}" for i in range(22)} | \
        {f"U_{tag}1", f"ENC_{tag}1", f"J_{tag}1", f"J_{tag}2", f"SW_{tag}PWR1"}
    assert placed_refs == want, \
        f"placement refs drift: {sorted(placed_refs ^ want)}"

    # fiducials: three targets on real board area (see pick_fiducials —
    # edge-and-pad-clear, inside the outline; the old bbox-corner rule put
    # all six off the board).
    for i, (fx, fy) in enumerate(pick_fiducials(tag, placements), start=1):
        placements.append(("FID", *FP_SRC["FID"], f"FID_{tag}{i}",
                           "FIDUCIAL", fx, fy, 0, True, True, False, {}))
    # tooling holes: 2x 3.2mm NPTH for SMD assembly (gasket mounting itself
    # uses no PCB holes — these are fab tooling, in confirmed-open areas).
    fid_pts = [(p[5], p[6]) for p in placements if p[0] == "FID"]
    for i, (hx, hy) in enumerate(pick_tooling(tag, placements, fid_pts), start=1):
        placements.append(("TOOL", *FP_SRC["TOOL"], f"MT_{tag}{i}",
                           "TOOLING", hx, hy, 0, True, True, False, {}))
    return placements


def build_board(tag, pts):
    # the BUILDER re-exports the netlist from the schematic before
    # placing (the gates read the committed netlist read-only)
    nets, pin_net = load_nets(tag, refresh=True)
    codes = {c for c, _ in nets}
    assert 0 in codes, "net 0 missing"
    placements = build_placements(tag, pts, pin_net)
    gfx = outline_graphics(tag)

    # --- emit ---
    path = os.path.join(PCB_DIR, PROJECT[tag] + ".kicad_pcb")
    blank = open(path).read()
    name_code = {n: c for c, n in nets}
    # Copper comes from the committed baseline; the working preamble (same
    # source-of-truth story as below: setup block survives local edits).
    # The committed board may be design-frame (pre-v0.4.0) or the new
    # y-negated storage frame; the copper signatures are design-frame, so
    # convert before extraction.  The final board is reflected at the write
    # boundary (see frame.py) — every builder above stays in design frame.
    track = git_track_text(path)
    if track is not None:
        track = frame.to_design(track)
    label = "HEAD:" + os.path.relpath(path, REPO)
    copper = [] if track is None else extract_copper_text(track, name_code,
                                                          label)
    import gen_route as router
    tag_now = f"placed+routed r{router.ROUTER_VERSION}"
    head = blank.split('(net 0 "")')[0] + '(net 0 "")\n'
    head = frame.set_frame(head, frame.DESIGN)
    head = re.sub(r'\(comment 2 "[^"]*"\)', f'(comment 2 "{tag_now}")', head)
    for code, name in sorted(nets):
        if code == 0:
            continue
        head += f'\t(net {code} "{name}")\n'

    body = []
    for kind, lib, name, ref, value, x, y, rot, hide, fab, strip, pn in placements:
        src = fp_source(lib, name)
        if kind == "PWR":
            # M3: the switch moved +4.3 inboard; the stock left-justified
            # 8-char ref string now pronounces past the body end. Shift it
            # away from that half's inner bite wall (mirrored signs), keeping
            # the two halves' silk mirror-images of each other.
            ref_shift = (-3.0, 0.0) if tag == "L" else (3.0, 0.0)
        else:
            ref_shift = (0.0, 0.0)
        if kind == "DIODE":
            # co-invariant (audit 2026-10-20): the stripped SOD-123 must
            # actually lose its native silk — the cathode tick re-adds
            # the mark and unstripped native bar + tick would double-mark
            # the diode polarity (radiant ambiguity for hand-solder).
            assert strip, \
                f"{ref}: DIODE without strip_silk — native cathode bar " \
                f"would double-mark beneath the tick"
        body.append(embed(src, f"{lib}:{name}", ref, value, x, y, rot, pn,
                          hide_ref=hide, ref_on_fab=fab, strip_silk=strip,
                          cathode_tick=(kind == "DIODE"),
                          ref_shift=ref_shift))

    # antenna keepout marking + JST pin-1 "+" (placement review aids; the
    # copper-pour keepout is enforced at routing — no pours exist yet).
    ax, ay, _ = pts["antenna" if tag == "L" else "mirror_antenna"]
    jx, jy, _ = pts["jst" if tag == "L" else "mirror_jst"]
    body.append(
        f'\t(gr_circle (center {r2(ax)} {r2(ay)}) (end {r2(ax + 5)} {r2(ay)})'
        f' (layer "Cmts.User") (stroke (width 0.15) (type solid))'
        f' (fill none) (uuid "{U()}"))')
    body.append(
        f'\t(gr_text "ANT KEEPOUT" (at {r2(ax)} {r2(ay - 7)} 0)'
        f' (layer "Cmts.User") (uuid "{U()}")'
        f' (effects (font (size 1 1) (thickness 0.15))))')
    body.append(
        f'\t(gr_text "+" (at {r2(jx - 3.5)} {r2(jy)} 0)'
        f' (layer "F.SilkS") (uuid "{U()}")'
        f' (effects (font (size 1 1) (thickness 0.15))))')

    # --- route (deterministic; generator-owned copper) ---
    # Hand-copper provenance (pcb/kicad/hand-copper.txt) replaces the old
    # classify-by-reproduction heuristic: phase 1 was an unseeded plan run
    # solely to guess which tracked items were hand-tuned ("not reproduced
    # = GUI"), but the seeded phase-2 plan diverges near its own seeds —
    # so the next run classified phase-2's output as GUI and churned the
    # board on every regen (observed: kept oscillated 0 -> 11 -> 15 -> 59
    # as the same copper was reclassified). Provenance instead: manifest
    # items are preserved verbatim from the committed board; every other
    # copper item is regenerated. The router may change freely — the
    # preserve set no longer depends on reproducing its output, so the
    # plan is a pure function of (netlist, placements, manifest).
    import collections
    want = collections.Counter(parse_hand_manifest(tag))
    got = collections.Counter()
    kept, dropped = [], []
    n2c = {c: n for c, n in nets}
    for k, b in copper:
        sig = copper_signature(k, b, n2c)
        if sig is not None and got[sig] < want[sig]:
            got[sig] += 1
            kept.append((k, b))
        else:
            dropped.append(sig)
    miss = [s2 for s2 in want if want[s2] > got[s2]]
    if miss:
        sys.exit(f"{PROJECT[tag]}: hand-copper.txt claims {len(miss)} items "
                 f"the committed board does not contain — the manifest is "
                 f"authoritative and must match (first: "
                 + "; ".join(manifest_line(s2) for s2 in miss[:3])
                 + ")")
    if dropped:
        print(f"  copper {tag}: {len(kept)} hand items kept "
              f"({len(copper)} extracted), {len(dropped)} router-owned "
              f"regenerated")
        if os.environ.get("PCB_KEPT_DEBUG"):
            for sig in dropped:
                print(f"    drop "
                      f"{manifest_line(sig) if sig else '(unparseable)'}")
    # Single seeded plan — fresh routes de-conflict against the hand copper
    # they will share the board with (M2 round fix).
    _board, _tracks, _vias = router.plan(
        tag, pts, placements, nets, pin_net,
        avoid_segs=[b for k, b in kept if k == "segment"],
        avoid_vias=[b for k, b in kept if k == "via"])
    _segs, _vv = router.emit(_board, _tracks, _vias)
    # drop router vias that duplicate preserved GUI vias (same net, same
    # spot — emit's dedupe only sees its own list; co-located drills are
    # a DRC warning)
    gui_vias = []
    for k, b in kept:
        if k == "via":
            m = re.search(r"\(at ([\d.-]+) ([\d.-]+)\)", b)
            mn = re.search(r"\(net (\d+)\)", b)
            if m and mn:
                gui_vias.append((int(mn.group(1)), float(m.group(1)),
                                 float(m.group(2))))

    def _gui_dup(via_block):
        m = re.search(r"\(at ([\d.-]+) ([\d.-]+)\)", via_block)
        mn = re.search(r"\(net (\d+)\)", via_block)
        if not (m and mn):
            return False
        code, x, y = int(mn.group(1)), float(m.group(1)), float(m.group(2))
        return any(c == code and math.hypot(x - gx, y - gy) < 0.1
                   for c, gx, gy in gui_vias)

    _vv = [b for b in _vv if not _gui_dup(b)]
    route_blocks = _segs + _vv

    # M2 round: the dangle/keepout check must see the FINAL board copper
    # (routed + preserved). Preserved-only was a false-positive machine:
    # GUI-tuned chains legitimately junction into router-generated
    # segments (e.g. the pwrsw stubs meet the router's trunk at a
    # mid-board point no pad claims), and the isolation view flagged
    # those junctions as dangling. The gate's contract ("preserved track
    # must still terminate on real copper") is about the merged board.
    merged = kept + [(b.split()[0].strip("()"), b) for b in route_blocks]
    # Gates BEFORE the file hits disk: a failing build no longer leaves a
    # broken .kicad_pcb in the tree for silent patch-up afterwards.
    check_containment(tag, placements)
    check_copper(tag, merged, placements, {c: n for c, n in nets}, pts,
                 dangle_items=kept)
    text = (head
            + "\n".join(gfx) + "\n"
            + "\n".join(body + route_blocks + [b for _, b in kept]) + "\n)\n")
    # KiCad's Gerber/Excellon writers negate stored y.  Storing the board
    # y-negated makes the release artwork land in the plate/case design
    # frame (see frame.py for the full rationale and the T12/T10 gate).
    text = frame.to_storage(text)
    with open(path, "w") as f:
        f.write(text)
    print(f"{PROJECT[tag]}: {len(placements)} footprints, "
          f"{len(nets)} nets, {len(gfx)} edge segments, "
          f"{len(route_blocks)} routed + {len(kept)} preserved copper items")
    return path


def drc(tag):
    """Run DRC and enforce the placement gate.

    Passes with: documented waivers W1/W2 only. unconnected_items is NOT
    waived (routing landed — DRC is the connectivity backstop).
    Anything else fails the build.
    """
    out = os.path.join(PCB_DIR, PROJECT[tag] + "-drc.rpt")
    src = os.path.join(PCB_DIR, PROJECT[tag] + ".kicad_pcb")
    # DRC on the design-frame reflection, not the y-negated storage file.
    # The two are the same physical board (frame.py); KiCad's library
    # comparison, however, compares footprint-LOCAL geometry, and the
    # storage file deliberately mirrors every local primitive so the
    # Gerber export lands in the plate frame.  Running DRC on storage would
    # flag all 54 footprints as lib_footprint_mismatch (the 20 intentional
    # W1 edits would be buried); the reflection is an isometry, so DRC on
    # the design copy is the same geometry with the library in its native
    # frame.  Keep the copy inside the project dir so KIPRJMOD/lib tables
    # resolve exactly as for the exported board.
    stem = os.path.join(PCB_DIR, f".{PROJECT[tag]}-drc-design")
    tmp = stem + ".kicad_pcb"
    # KiCad picks design rules from <board-stem>.kicad_pro.  Without the
    # matching project copy the temp board silently falls back to the
    # default 0.5mm edge clearance and reports false copper_edge_clearance
    # hits that the real project rule allows.  Copy the project (and custom
    # rules, if any) beside the temp board, then remove all three.
    copied = [tmp]
    try:
        with open(tmp, "w") as f:
            f.write(frame.read_design(src))
        for ext in (".kicad_pro", ".kicad_dru"):
            s = os.path.join(PCB_DIR, PROJECT[tag] + ext)
            if os.path.exists(s):
                shutil.copyfile(s, stem + ext)
                copied.append(stem + ext)
        r = subprocess.run(
            [KICAD_CLI, "pcb", "drc", "--severity-all", "--format", "report",
             "-o", out, tmp], capture_output=True, text=True)
    finally:
        for p in copied:
            if os.path.exists(p):
                os.unlink(p)
    tail = (r.stdout + r.stderr).strip().splitlines()
    print(f"  {tail[-1] if tail else 'drc done'}")
    if r.returncode != 0:
        # a crashed/empty report must never read as "clean" — the checker
        # would pass on the absence of violations. Return 1: main() owns
        # the exit path so it can revert the rejected board first.
        print(f"  kicad-cli DRC failed for {tag} (exit {r.returncode}):\n"
              + "\n".join(tail[-10:]))
        return 1
    assert os.path.exists(out) and os.path.getsize(out) > 0, \
        f"drc wrote no report for {tag}"
    return check_drc_report(out, tag)


def w1_want(tag):
    """Waiver W1: exact expected lib_footprint_mismatch set per half.
    28 = 22x D_SOD-123 (stripped silk + cathode tick) + 4x thumb Choc
    (rotated) + MCU socket (reversed column) + TRRS (renamed pads).
    NOTE (verified 2026-10-15): (model ...) lines do NOT participate in
    the mismatch check — relinking the encoder/slide-switch bodies to
    vendored files left the set at exactly 28. Geometry only.
    A 29th mismatch (or a missing one) fails the build instead of passing
    silently under the old blanket skip. Shared with check_board (the
    content gate compares each waived ref's committed pads here)."""
    return (
        {("D_SOD-123", f"D_{tag}{i:02d}") for i in range(22)}
        | {("SW_Hotswap_Kailh_Choc_V1_1.00u", f"SW_{tag}{i:02d}")
           for i in (18, 19, 20, 21)}
        | {("Socket_Strips_2x12_P2.54mm_NiceNano", f"U_{tag}1"),
           ("TRRS-PJ-320A", f"J_{tag}1")}
    )


def check_drc_report(path, tag=None):
    """0 if clean (modulo waivers), 1 otherwise. Prints non-waived items."""
    import collections
    if tag is None:
        tag = "R" if "-Right-" in path or "Right" in path else "L"
    s = open(path).read()
    pats = re.findall(r"\[(.*?)\]: (.*?)\n((?:    .*\n)+)", s)
    counts = collections.Counter()
    bad = []
    w1_got = set()
    for typ, desc, body in pats:
        counts[typ] += 1
        # unconnected_items: NOT waived — routing landed (r10), DRC is the
        # backstop and must stay armed. Any unconnected item fails the build.
        if typ == "lib_footprint_mismatch":
            txt = f"{desc}\n{body}"
            for m in re.finditer(
                    r"Footprint '([^']+)' does not match.*?Footprint (\S+)",
                    txt, re.S):
                w1_got.add((m.group(1), m.group(2)))
            continue  # set asserted after the loop, not blanket-skipped
        if typ == "silk_over_copper":
            refs = set(re.findall(r"of (SW_[LR]\d+|SW_[LR]PWR1) on [BM]\.Cu", body))
            segs = set(re.findall(r"Segment of (SW_[LR]\d+|SW_[LR]PWR1) on [BM]\.Silk(?:screen|S)", body))
            pads = re.findall(r"Pad (\d+) \[.*?\] of (SW_[LR]\d+|SW_[LR]PWR1) on ([BM])\.Cu", body)
            # waiver W2: Choc B.SilkS socket outline vs its OWN pad 2 —
            # vendor marginality, proven angle-dependent rasterization noise
            # (lone footprint: rot +13.5 clean, -13.5 flagged; rigid geometry
            # is rotation-invariant, so the flag cannot be real). Silk sits
            # under the socket frame, covered by the solder fillet.
            if (refs == segs and len(refs) == 1
                    and all(p[0] == "2" and p[1] in refs and p[2] == "B"
                            for p in pads) and pads):
                continue
        bad.append((typ, desc, body))
    if w1_got != w1_want(tag):
        print(f"  drc W1 mismatch {tag}: want {len(w1_want(tag))}, "
              f"got {len(w1_got)}")
        for m in sorted(w1_want(tag) - w1_got)[:10]:
            print(f"  !! W1 missing {m}")
        for m in sorted(w1_got - w1_want(tag))[:10]:
            print(f"  !! W1 extra {m}")
        bad.append(("lib_footprint_mismatch", "W1 set drift",
                    f"want {sorted(w1_want(tag))}\ngot {sorted(w1_got)}\n"))
    print(f"  drc: {dict(counts)}" +
          ("" if not bad else f" — {len(bad)} NON-WAIVED"))
    for typ, desc, body in bad[:10]:
        print(f"  !! [{typ}] {desc}\n{body}")
    return 1 if bad else 0


def board_dirty(tag):
    """True if the working .kicad_pcb differs from HEAD (hand edits?)."""
    r = subprocess.run(
        ["git", "status", "--porcelain", "--",
         os.path.join("pcb", "kicad", PROJECT[tag] + ".kicad_pcb")],
        capture_output=True, text=True, cwd=REPO)
    return bool(r.stdout.strip())


def main():
    import datetime
    pts = load_points()
    stamp = datetime.datetime.now().strftime("%Y%m%d-%H%M%S")
    # Pre-regen hygiene: extraction reads HEAD, so uncommitted working-board
    # edits would be silently overwritten by the regen write. Archive them
    # first (hand copper flows into gen_pcb via hand-copper.txt, not by
    # working-file persistence).
    dirty = {}
    for tag in HALVES:
        src = os.path.join(PCB_DIR, PROJECT[tag] + ".kicad_pcb")
        dirty[tag] = board_dirty(tag)
        if dirty[tag]:
            dst = os.path.join(REPO, "opencode",
                               f"pre-regen-{tag}-{stamp}.kicad_pcb")
            shutil.copyfile(src, dst)
            print(f"{PROJECT[tag]}: uncommitted board edits archived to "
                  f"{os.path.relpath(dst, REPO)} — if these are hand copper, "
                  f"capture the items into hand-copper.txt; regen cuts from "
                  f"the committed baseline")
    for tag in HALVES:
        build_board(tag, pts)
    # Artifact gates (committed check_board.py — were /tmp scripts):
    # outline topology, fiducials, notch openness, per built board file.
    # DRC gate: placement must be clean modulo documented waivers
    # (W1/W2 only — unconnected is NOT waived).
    import check_board
    failed = set()
    rc = 0
    for tag in HALVES:
        rcg = check_board.check(tag, pts)
        rc |= rcg
        if rcg:
            failed.add(tag)
    for tag in HALVES:
        rcg = drc(tag)
        rc |= rcg
        if rcg:
            failed.add(tag)
    # Self-cleanup: a rejected board must never linger in the worktree to
    # feed some future tooling by accident. Revert to the committed baseline
    # (safe: if the tree was dirty pre-regen, the hand edits are archived
    # above already, so only this run's output is being discarded).
    for tag in sorted(failed):
        path = os.path.join(PCB_DIR, PROJECT[tag] + ".kicad_pcb")
        if dirty[tag]:
            print(f"{PROJECT[tag]}: build rejected — board left as-built "
                  f"(pre-regen archive above has the prior state)")
        else:
            dst = os.path.join(REPO, "opencode",
                               f"rejected-{tag}-{stamp}.kicad_pcb")
            shutil.copyfile(path, dst)
            subprocess.run(["git", "checkout", "--",
                            os.path.relpath(path, REPO)], cwd=REPO)
            print(f"{PROJECT[tag]}: build rejected — reverted to committed "
                  f"baseline (rejected copy: {os.path.relpath(dst, REPO)})")
    sys.exit(rc)


if __name__ == "__main__":
    main()
