BitPeppr/Hojicha44/spec/layout.yaml

# Layout-phase specification (frozen v2 baseline).
# Source of truth for geometry is layout/ergogen/config.yaml;
# this file records the keymap and decisions around it.
# Statuses: fixed | provisional | candidate | measured | undecided.

version: 0.9.3  # mirrors layout/ergogen/config.yaml (v7/0.9.2 = frozen snapshot)
status: provisional  # geometry agreed + PCB envelope added, awaiting print-test

key_count:
  total: 44
  per_side: 22
  matrix: 18        # 6 columns x 3 rows, MX 19 mm pitch
  thumbs: 4
  number_row: false # status: fixed — numbers/symbols live on L1

matrix:
  columns: [outer, pinky, ring, middle, index, inner]
  rows: [top, home, bottom]
  splay: 0                  # status: fixed — parallel columns
  stagger:                  # status: provisional — mm offsets, outer sits low
    outer: -8
    pinky: 4
    ring: 5
    middle: 7
    index: -3
    inner: -6

thumbs:
  # Left west->east / right west->east. All standalone keys (status: fixed),
  # all 1u. The four sit on one true circle (R=91.2 about the thumb joint)
  # even ~13.9deg steps give even ~22mm chords and
  # clock-tangent rotations (tangent error <=1.6deg), so every key sits ON
  # the curve facing along it. Edge clearance >=1.0mm on every cap pair at true 18x17 MBK caps
  (1.5mm at the modelled 17.5x16.5 KLP footprint; 1.3 was the KLP number)
  # (verified by polygon check, not center distance).
  left: [Esc, L1, Tab, Space]              # west->east == outer->inner
  right: [Enter, Backspace, L2, Delete]     # west->east == inner->outer
  notes:
    - Rev 3 (home-row mods): all four modifiers live on the home row, so
      the thumbs are freed for the frequent keys.  Measured off the
      thumb-joint circle (R=91.2mm, even ~13.9deg steps): the two MIDDLE
      keys sit 7.25/6.66deg off the arc's neutral and the extremes 21deg,
      so the rare keys (Esc/Delete) take the outermost, the layer HOLDS
      take the accessible mid-outer (comfort for a long hold), Tab and
      Backspace the mid-inner, and Space/Enter the innermost primaries.
      The space-hand variants swap Space and Enter between the two
      innermost thumbs; everything else is fixed (status: fixed).
    - Cmd is Super; Opt is Alt — both now live on the home row (rev 3).
    - L1 and L2 stay separate layers (status: fixed).
    - Fn is the L1+L2 chord, not a key (status: provisional).
    - Cluster arcs down-east into the split gap; inner key most rotated.

encoder:
  per_side: 1 # status: fixed — one EC11 per half (54 footprints/half incl. it)
  position: south of the inner column, clear of the MCU zone at top-inner
  # Knock-through belongs to the PLATE/CASE, not the PCB: the EC11E body sits
  # ON the board and all seven of its pads need copper (the A/B/C row is within
  # 7.9mm of the knob centre, i.e. inside an 8mm-radius hole).
  plate_cutout: 16.2 x 12.4mm chamfered window at the shaft (terminal-block
    envelope), cut in plate/
    (plate/Hojicha44-{Left,Right}-plate.dxf) — layout/generated/v2/outlines/plate.dxf
    is legacy ergogen output and no longer the cutout source
  footprint: Ergogen stock `rotary` (EC11), attached in the PCB phase

mcu:
  keepout: 18.3x34.1 rect (envelope only) north of the encoder, in the gap (`_mcu` outline)
  part: nice!nano (Pro Micro footprint) # status: provisional
  orientation: >-
    USB-UP — the USB end points at the north board edge, which is open, so
    the plug seats in the `usb` notch. The module's USB shell does NOT
    overhang that edge (measured: shell x 113.5..122.5 vs board edge x=131.5,
    so it sits ~9mm inboard); the notch alone provides plug seating.
    Because the nice!nano v2 puts D1/RAW at the USB end, that means pads
    1 (D1) and 24 (RAW) face north and the ANTENNA end (pads 12/13) faces
    south, into the board. Antenna keepout is the `antenna_keepout` circle
    (r=5) at `antenna`, copper-free for 5mm past the module's south edge.
  status: fixed (placement); case clearance for the antenna is a CAD-phase
    cut — mark the keepout on the case too.
  battery: 301230 (3x12x30) sits UNDER the socketed module; the `batt`
    outline reserves its footprint. JST tail exits south to the `jst` point.

non-key anchors:  # PCB-phase mechanical envelope (status: fixed; see config)
  usb:    module USB-C centre at the north edge (opens the seat notch)
  antenna: module south (antenna) end — r=5 copper keepout
  batt:   301230 cell under the module (outline `_batt`, 12.5x31)
  jst:    JST-PH socket, south of the battery (`_jst`, 9x9 zone)
  pwrsw:  WS-SLTV slide switch on the north edge, west of the USB notch;
    outline `_pwrsw` (13x5), case slot over the actuator
  trrs: >-
    PJ-320A at the inner (gap-facing) edge, outline `_trrs` (17x7) centred
    on the `trrs` anchor. Measured on placed boards with J_L1 at
    (122.45,-22) rot 90 and J_R1 at (169.05,-22) rot 270 (CW-positive) —
    plastic mouths at L 134.55 and R 156.95 for 22.40mm mouth-to-mouth,
    each 0.99mm RECESSED behind its board edge (edges L 135.54 and R
    155.96 for 20.42mm edge-to-edge). Silk tops at 21.40mm, still 0.49mm
    recessed. Supersedes the stale 3.46mm-proud and 139.00 claim. The jack
    is THT with its pin row inboard and the barrel stays behind the edge.

split_width:
  mirror_distance: 4.5kx + 16
      # status: fixed — user-approved widening
    # Single line in `layout/ergogen/config.yaml` under `mirror:`.
    # Revert by deleting the "+ 16" — that restores the frozen baseline.
    # Snapshots of both widths: layout/- FINAL/keyboard_layout_v8.yaml
    # (4.5kx) and keyboard_layout_v8_exp_split.yaml (4.5kx + 16).
    # Left-half key geometry is bit-identical in both; only the right half
    # translates. Frozen v7 left-half key positions unchanged.
  inner_gap_at_encoder: 18.50mm between the two board edges  # status: measured
  inner_gap_at_trrs: >-
    20.42mm board-edge to board-edge at y=-22; plastic TRRS mouths at
    22.40mm mouth-to-mouth, each 0.99mm recessed (silk tops at 21.40mm,
    0.49mm recessed). 90-degree plugs need about 8mm of the 22.40mm gap
    and fit easily; a molded straight pair needs about 24mm and is
    marginal. Status measured.
    # PCB GATE — confirm the molded plug BOOTS (wider than the barrel)
    # also clear within 22.40mm. If they foul, use thinner boots or option (a).
  trrs_resolution: the +16mm widening RESOLVED the frozen-width problem — at
    4.5kx the mouths faced each other across ~4.4mm and no plug could seat.
    # The widening was chosen because it fixes TRRS without moving any key.
    # Superseded alternatives, if the widened gap ever becomes a problem:
    #   (a) both jacks on the OUTER edge, cable looping around the back,
    #   (b) one jack per half on the north edge above the MCU zone,
    #   (d) drop the wired split (BLE-only; TRRS is optional per
    #       spec/electronics.yaml architecture.split_link).
    # All of these change only the jack, never the key geometry.
  battery_antenna_overlap: the 301230 cell (`_batt`, y 16.5..47.5) sits over
    the antenna keepout circle (r=5 centred y=16.5) over y 16.5..21.5  # status: fixed — accepted, standard practice
    # RESOLVED 2026-10-13 by researching the reference builds. EVERY mainstream
    # wireless split puts the cell directly under the socketed nice!nano:
    #   Lily58 (typeractive build guide)  2x 301230 under the module; "you can't
    #     go much larger than 301230"
    #   Corne (crkbd#149, typeractive)     301230 under the module; needs a
    #     taller pin row (Mill-Max 335/800/350) for the 3mm cell
    #   Sofle v2.0w / SofleChocWireless / Aurora Sofle V2 — 110mAh slid under
    #     the controller; 4mm spring pins required, or lift the pins to make room
    #   splitkb Aurora series (Lily58/Corne/Sofle/Sweep/Helix): "80mAh or 110mAh
    #     ... can usually be placed between the PCB and the controller"
    #   nicekeyboards nice!nano docs: "in most cases the battery should fit
    #     underneath the socketed nice!nano"
    # NOT ONE of them applies an antenna keepout for the cell. Physically the
    # cell sits ABOVE this PCB and BELOW the module, so the r=5 COPPER keepout
    # on our board is honoured regardless — the two are independent layers.
    # Electrically a PCB trace antenna has a null perpendicular to its plane,
    # so a cell 3mm directly below the antenna end sits in that null rather
    # than shadowing the main lobe. Empirically it is not a practical problem.
    # IF range ever disappoints: 301228 (90mAh) is a drop-in shorter cell, and
    # the documented capacity upgrade is a 306080 between PCB and bottom plate
    # with 9mm standoffs (Sofle) — which also puts FR4 between antenna and cell.

screws:
  removed # no screws in the layout phase; revisit at CAD if plates need mounting

preview:
  outline: stacks board + keycaps + encoder holes + MCU rect + non-key zones
  use: ergogen.xyz Outlines tab, not the points demo

board:
  construction: concave hull per half (concavity 25) incl. MCU rect,
    expanded 4.5mm with rounded joints + fillet; encoder circles NOT cut
    (they live in `plate`) — the EC11E body rests on the PCB
  smoothing: helper point bridges the dip between thumb fan and outer
    columns so the contour runs gentle there
  note: plate truth is pure-Python plate/gen_plate.py; this is a preview

relocated_keys:  # v1 -> v2/v3 dispositions (status: fixed unless noted)
  Tab_1_5u: left thumb (rev 3; was inner-bottom-left, was v1 1.5u key)
  Cmd_1_5u: home row (rev 3; was left thumb)  # GUI: A for GACS, D for CAGS
  Shift_1_5u: home row (rev 3; was right thumb)  # F/J, the index home keys
  Ctrl: home row (rev 3; was left thumb)  # A for CAGS, D for GACS
  Opt_Alt: home row (rev 3; was right thumb)  # S/L, the ring home keys
  quote_column: base layer, right inner-bottom (rev 3; was planned for L1)
  dash_key: base layer, left inner-bottom (rev 3; new on the base)
  Esc: left thumb outermost (rev 3; was right inner-bottom)
  Delete: right thumb outermost (rev 3; new)
  Backspace: right thumb (rev 3; new)
  Func_key: dropped  # superseded by the L1+L2 chord -> Adjust
  blank_placeholders: dropped

keymap:
  # (column, row): left-hand legends; right hand mirrors per
  # layout/generators/export_kle.py MLAB.  Rev 3 (keymap finalisation):
  # the inner-bottom keys became dash and quote (Tab/Esc moved to the
  # thumbs); the letters are UNCHANGED QWERTY.  This block is the single
  # source for config/gen_keymap.py — the keymap files are GENERATED from
  # it and gated (see spec/keymap.md).
  left:
    outer: [Q, A, Z]
    pinky: [W, S, X]
    ring: [E, D, C]
    middle: [R, F, V]
    index: [T, G, B]
    inner: ["~`", "{[_-", "-_"]
  right:
    inner: ["|\\", "}]", "'\""]
    index: [Y, H, N]
    middle: [U, J, M]
    ring: [I, K, "<"]
    pinky: [O, L, ">."]
    outer: [P, ":;0", "?/"]
  variants:
    # name -> [mod order, space thumb].  Mod orders are the HOME-ROW mod
    # order, pinky->index (see spec/keymap.md for the sourcing):
    #   GACS = miryoku / precondition's Windows-Linux default
    #          (GUI Alt Ctrl Shift; Shift on the index, the strongest
    #          finger, gets the most-used modifier)
    #   CAGS = the macOS adaptation (Cmd=GUI outranks Ctrl, so GUI moves
    #          to the middle finger: Ctrl Alt GUI Shift)
    # space: which thumb carries Space (the other carries Enter).
    default: mac_left
    mac_left: [CAGS, left]
    mac_right: [CAGS, right]
    win_left: [GACS, left]
    win_right: [GACS, right]

open_points:
  # RESOLVED 2026-10-22 (keymap finalisation, spec/keymap.md): all four
  # modifiers are home-row mod-taps (mirrored by column), so no thumb
  # carries a modifier and no Shift chord needs hand gymnastics;
  # Backspace = right thumb mid-inner (and L2), Delete = right thumb
  # outermost (and L2); digits in QWERTY order on L1 row 0; nav/media/BT
  # on L2; the L1+L2 chord is the Adjust layer (boot/reset).
  - Print-test at 1:1, then tag layout baseline in git.
