BitPeppr/Hojicha44/(commit log)

2026-10-11 Layout baseline v0.9.0
    - Ergogen source (layout/ergogen yaml/config.yaml): 6x3 matrix,
    circular thumb fan, encoder, MCU keepout, plate outlines
    - KLE sketches v1-v4 + Ergogen snapshots v5-v6 in layout/versions/
    - export_kle.py generator (Ergogen points -> KLE, verified identical)
    - spec/layout.yaml decisions; .gitignore (deps, generated outputs)
2026-10-13 PCB baseline r10: placed+routed, DRC-clean modulo W1
    Both halves 54 footprints / 48 nets, deterministic 2-layer router
    (anode-first, matrix rails with MCU taps, no rip-up). Zero unconnected
    items; DRC shows only documented waiver W1 (28 lib_footprint_mismatch
    per half, environmental). ERC 0 errors (5 deliberate spare warnings);
    silk audit symmetric OK. Schematic symbols carry MPN + controller
    datasheet; BOM in spec/bom.md; first-article gate in
    spec/first-article.md with 1:1 prints (out/, ignored).
    [Hojicha44-Left.kicad_pcb, Hojicha44-Left.kicad_sch, Hojicha44-Right.kicad_pcb, Hojicha44-Right.kicad_sch]
2026-10-13 Release hardening: fab-real DRC rules, explicit-layer Gerbers, doc pointers
    - .kicad_pro rules: edge clearance 0.075->0.2, via annular 0.05->0.15,
    min clearance 0.0->0.2 (netclasses already enforced; DRC re-verified
    clean modulo W1 on both halves)
    - fix.md table points P0-4/P0-6 at §9 DONE state
    - zmk: document shared left_encoder node (per-half rename would break
    the sensors reference)
    - notes: release-hardening addendum (Gerber layer list lives in
    out/release/, ignored)
2026-10-14 Enforceable gates + committed artifact checks + verified release docs
    - ERC gate parses the report (0 errors + 5 documented spare warnings);
    --exit-code-violations deliberately not used (counts warnings).
    Proven: fails injected errors/unknown warnings, passes spares.
    - DRC unconnected_items waiver deleted (routing landed); proven to fail
    injected unconnected items. Gate comments updated.
    - check_board.py: committed outline/fiducial/notch artifact gates
    (were /tmp scripts), wired into gen_pcb.main; fails clean on sabotage.
    - fix.md §5.1/§5.3/§3 acceptance reconciled with enforced behavior;
    verified release commands (explicit gerber layers, csv-mm pos).
    - notes.md release-hardenin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
    [Hojicha44-Left.kicad_pcb, Hojicha44-Left.kicad_sch, Hojicha44-Right.kicad_pcb, Hojicha44-Right.kicad_sch]
2026-10-14 Review fixes: encoder firmware, measured doc reconciliation
    - zmk: steps 30->15 (pulses, EC11E15244G1); enc_sw rebuilt as proper
    gpio-keys child (ACTIVE_LOW, closes to GND) + direct-kscan keymap
    path bound to C_MUTE (assumed, first-article); transform untouched
    - docs measured, not copied: column pitch 19.00, TRRS mouths 22.40
    recessed 0.99 (supersedes stale 13.50-proud claim), USB-unplug-BOTH
    TRRS rule, flex cuts deferred-to-rev-2, diode 1N4148W-7-F example
    - fit sheets carry F.Cu pads; first-article reworded to match
    [electronics.yaml, layout.yaml]
2026-10-14 VBAT off USB notch + mask expansion + rating corrections
    - Router r13: power-class notch keepout (bite band floor-0.5 to
    floor+2) moves the battery rail off the plug-bump edge; measured
    min VBAT copper-edge to outline 2.518mm both halves (was 0.25mm
    at the notch floor with a via at (111.75,47.5) — both gone).
    - Carve/re-block: other-net clearance re-blocked after own carve so
    shared THT slivers steer exits instead of grazing (fixed the
    GND-vs-COL2 graze the reroute exposed). DRC green both halves.
    - Mask expansion 0.05 (was 0) in both .kicad_pro; no reroute needed.
    - WS-SLTV corrected to 300mA switching; boost jumper stays OPEN;
    100x100 pricing note; USB-cable dry-fit note in f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
    [Hojicha44-Left.kicad_pcb, Hojicha44-Right.kicad_pcb]
2026-10-14 Review F1-F8: diode cathode ticks, doc reconciliation
    - F1: generator-owned F.SilkS cathode tick on all 44 SOD-123s (0.29mm
    local clearance, rotation-proof); DRC 0 new silk violations, audit
    symmetric; on-board polarity gate now met
    - F8: gpio-map.md right-half tip/ring1 wording fixed (nets were correct)
    - F2/F3/F5/F6: no-pour decision, KiCad CPL convention, boot-width and
    TRRS-22.40 lines in first-article; 13.5 rebuttal with footprint math
    - 13.5 mouth-gap claim rebutted (no geometric basis; 22.40 stands)
    [Hojicha44-Left.kicad_pcb, Hojicha44-Left.kicad_sch, Hojicha44-Right.kicad_pcb, Hojicha44-Right.kicad_sch]
2026-10-14 Adversarial re-audit fixes + verified rebuild
    - Docs: r13 routed counts (446/590), W2-retired wording, P1-8
    inline supersede marker, re-audit evidence section
    - Rebuilt schematic+boards green (SCH/PCB/SILK 0, ERC 0e/5w,
    DRC W1-only, check_board CLEAN); release re-cut + manifest
    [Hojicha44-Left.kicad_pcb, Hojicha44-Left.kicad_sch, Hojicha44-Right.kicad_pcb, Hojicha44-Right.kicad_sch]
2026-10-14 ZMK CI: standard shield layout + cloud builds for both halves
    - boards/shields/hojicha44/: shared dtsi, per-half overlays, Kconfig
    pair (left central default), metadata, empty per-half confs (Corne
    mirror); right overlay gains col-offset <6> (was missing: both
    halves reported columns 0-5)
    - config/: west.yml (ZMK v0.3 pin), hojicha44.keymap + .conf (moved)
    - build.yaml (nice_nano_v2 x left/right) + reusable-workflow CI job
    - Left = central convention; single 24-cell keymap serves both halves
2026-10-14 ZMK: comma form RC(r,c) in matrix transform (C preprocessor)
    [Hojicha44-Left.kicad_pcb, Hojicha44-Left.kicad_sch, Hojicha44-Right.kicad_pcb, Hojicha44-Right.kicad_sch]
2026-10-14 ZMK CI: nice_nano//zmk board variant (Zephyr 4.1 requirement)
2026-10-14 ZMK CI: classic nice_nano_v2 board + compat marker
2026-10-14 ZMK CI: pin workflow to v0.3, drop compat marker
    [Hojicha44-Left.kicad_sch, Hojicha44-Right.kicad_sch]
2026-10-14 Release hardening close-out: versioned v0.3.1, exact W1 gate, courtyard errors, static CI
    - TRRS source comment corrected to measured 22.40/20.42/recessed geometry
    - spec erc stanza restored (0 errors + 5 documented spares)
    - gen_pcb W1 waiver now asserts exact 28-entry set per half (rejects 29th/drift)
    - PTH/NPTH-inside-courtyard severity ignore->error (generator-enforced)
    - scripts/make_release.py writes tracked generated/release/vX.Y.Z + MANIFEST
    - .gitignore negates generated/release so ERC/DRC evidence stays versioned
    - tests/spec_checks.cjs + npm test + checks.yml CI (no KiCad needed)
    - hygiene: dedupe 1N4001 NEED, drop *.lck noise
    [Hojicha44-Left-B_Cu.gbl, Hojicha44-Left-B_Mask.gbs, Hojicha44-Left-B_Paste.gbp, Hojicha44-Left-B_Silkscreen.gbo, Hojicha44-Left-Edge_Cuts.gm1, Hojicha44-Left-F_Cu.gtl, Hojicha44-Left-F_Mask.gts, Hojicha44-Left-F_Paste.gtp]
2026-10-14 Reorg: retire fix.md, archive layout snapshots to layout/- FINAL
    - Remove fix.md (review plan consumed; standing status lives in
    notes.md release-review sections and spec/ source comments)
    - Move layout/iterations/* -> layout/- FINAL/ (100% renames)
    - Repair references: export_kle.py, render_preview.mjs, spec/layout.yaml,
    README.md now point at the archive location
    [keyboard_layout_v8.yaml, keyboard_layout_v8_exp_split.yaml, layout.yaml]
2026-10-14 Record generator UUID refresh (verified no semantic changes)
    [Hojicha44-Left.kicad_pcb, Hojicha44-Left.kicad_sch, Hojicha44-Right.kicad_pcb, Hojicha44-Right.kicad_sch]
2026-10-14 Fab package: refresh release v0.3.1 to HEAD, place verified copy in layout/- FINAL/fab
    [Hojicha44-Left-B_Cu.gbl, Hojicha44-Left-B_Mask.gbs, Hojicha44-Left-B_Paste.gbp, Hojicha44-Left-B_Silkscreen.gbo, Hojicha44-Left-Edge_Cuts.gm1, Hojicha44-Left-F_Cu.gtl, Hojicha44-Left-F_Mask.gts, Hojicha44-Left-F_Paste.gtp]
2026-10-14 Move fab package: layout/- FINAL/fab -> pcb/- FINAL/fab (fab outputs belong with pcb)
    [Hojicha44-Left-B_Cu.gbl, Hojicha44-Left-B_Mask.gbs, Hojicha44-Left-B_Paste.gbp, Hojicha44-Left-B_Silkscreen.gbo, Hojicha44-Left-Edge_Cuts.gm1, Hojicha44-Left-F_Cu.gtl, Hojicha44-Left-F_Mask.gts, Hojicha44-Left-F_Paste.gtp]
2026-10-14 Record flattened fab package + evidence reports in pcb/- FINAL
    [Hojicha44-Left-B_Cu.gbl, Hojicha44-Left-B_Mask.gbs, Hojicha44-Left-B_Paste.gbp, Hojicha44-Left-B_Silkscreen.gbo, Hojicha44-Left-Edge_Cuts.gm1, Hojicha44-Left-F_Cu.gtl, Hojicha44-Left-F_Mask.gts, Hojicha44-Left-F_Paste.gtp]
2026-10-14 Version fab evidence reports in pcb/- FINAL (gitignore negation)
2026-10-14 Cleanup: make_release.py -> pcb/, drop dead empty dirs (zmk/boards, decisions, experiments)
2026-10-14 First-article: power/safety gates, bring-up, case labels, rev-2 backlog
2026-10-14 3D models: vendored choc/TRRS/nano, linked in local footprints, release re-cut
    [Hojicha44-Left-B_Cu.gbl, Hojicha44-Left-B_Mask.gbs, Hojicha44-Left-B_Paste.gbp, Hojicha44-Left-B_Silkscreen.gbo, Hojicha44-Left-Edge_Cuts.gm1, Hojicha44-Left-F_Cu.gtl, Hojicha44-Left-F_Mask.gts, Hojicha44-Left-F_Paste.gtp]
2026-10-14 Plate rev-1: generator + DXF/SVG/lands, case contract, BOM/checklist updates
2026-10-14 Move plate generator to top-level plate/ stage
2026-10-14 Consolidate plate stage: outputs live in plate/, paths updated
    [Hojicha44-Left-plate.dxf, Hojicha44-Right-plate.dxf]
2026-10-14 Plate preview: numbered gasket lands + legend
2026-10-14 Plate: strip gaskets, material gate, paired XY, web pull-in
    [Hojicha44-Left-plate.dxf, Hojicha44-Right-plate.dxf]
2026-10-14 Plate: tab-and-jacket suspension, material gate, jacket contract
    [Hojicha44-Left-plate.dxf, Hojicha44-Right-plate.dxf]
2026-10-14 Plate: fix tab splice/fillet geometry, 6 tabs, self-checks, inner-edge documented
    [Hojicha44-Left-plate.dxf, Hojicha44-Right-plate.dxf]
2026-10-15 Plate: pinned corner tabs, plate/PCB frame note
    [Hojicha44-Left-plate.dxf, Hojicha44-Right-plate.dxf]
2026-10-15 Plate: encoder hole centered on shaft, not footprint origin
    [Hojicha44-Left-plate.dxf, Hojicha44-Right-plate.dxf]
2026-10-15 Plate: 8 tabs with poron pads top+bottom, PORON layer, strip stock
    [Hojicha44-Left-plate.dxf, Hojicha44-Right-plate.dxf]
2026-10-15 Plate: pads on tongues, window union, full legend
    [Hojicha44-Left-plate.dxf, Hojicha44-Right-plate.dxf]
2026-10-15 Populated renders: switch bodies via throwaway dummies (repo untouched)
2026-10-15 Vendored EC11 STEP + switch envelope, MODEL_OVERRIDES in generator
    [Hojicha44-Left-B_Cu.gbl, Hojicha44-Left-B_Mask.gbs, Hojicha44-Left-B_Paste.gbp, Hojicha44-Left-B_Silkscreen.gbo, Hojicha44-Left-Edge_Cuts.gm1, Hojicha44-Left-F_Cu.gtl, Hojicha44-Left-F_Mask.gts, Hojicha44-Left-F_Paste.gtp]
2026-10-16 Audit fixes: 46-cell ZMK transform, BLE-only split, gate hardening, doc consistency
    [Hojicha44-Left-B_Cu.gbl, Hojicha44-Left-B_Mask.gbs, Hojicha44-Left-B_Paste.gbp, Hojicha44-Left-B_Silkscreen.gbo, Hojicha44-Left-Edge_Cuts.gm1, Hojicha44-Left-F_Cu.gtl, Hojicha44-Left-F_Mask.gts, Hojicha44-Left-F_Paste.gtp]
2026-10-16 Case tub v1: stepped walls, captive M3-nylon bosses, 6.0 lip, floor-step spec
2026-10-16 Case v2: smooth homogeneous skin, internal pockets, port slots, no bosses
2026-10-16 Case v3: uniform 6mm dilation exterior (Sofle/Corne lesson), gate span-bug fixed
2026-10-17 Case v3.1: dilate the PCB rim (no tab bulges), through-wall port slots, adaptive pocket noses
2026-10-17 Case v3.2: wall strength (outset 7.0, tab-tip walls 1.5), port slots save the floor slab, TRRS 9.5 boot-fit, antenna keepout gate
2026-10-17 Case v3.3-v3.5: shaped port bores, magnet retention + ring cover (review-fixed); plate encoder 12.7; firmware bringup
    Case (case/):
    - v3.3-v3.4: ports re-cut as shaped bores sized to the real plugs
    (USB 14-wide slot z 2..top with bottom fillets; TRRS = round Ø9.5
    bore on the measured jack axis; full-wall rectangles retired)
    - v3.5: pwrsw actuator slot on the exact north-rim plateau; 8x per
    half Ø4.2x2.2 N52 magnet pockets on the band top (rect-aware station
    gates: band/SAT/antenna/spacing, USB-anchor ring rotation); flush
    ring cover z 6..9 as a single solid (TRRS blind tunnel, pwrsw slot
    keeps a 1.1 inner web)
    - user-review round: cover interior moved to PCB rim + 0.5 so the ri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
    [Hojicha44-Left-B_Cu.gbl, Hojicha44-Left-B_Mask.gbs, Hojicha44-Left-B_Paste.gbp, Hojicha44-Left-B_Silkscreen.gbo, Hojicha44-Left-Edge_Cuts.gm1, Hojicha44-Left-F_Cu.gtl, Hojicha44-Left-F_Mask.gts, Hojicha44-Left-F_Paste.gtp]
2026-10-17 release v0.3.1: cut @38c6910c195d — stage outputs, MANIFEST stamp clean
    [Hojicha44-Left-B_Cu.gbl, Hojicha44-Left-B_Mask.gbs, Hojicha44-Left-B_Paste.gbp, Hojicha44-Left-B_Silkscreen.gbo, Hojicha44-Left-Edge_Cuts.gm1, Hojicha44-Left-F_Cu.gtl, Hojicha44-Left-F_Mask.gts, Hojicha44-Left-F_Paste.gtp]
2026-10-18 Review round 2: B1 pillar clearance blocker + T4 cover magnets + M2 pwrsw shift + M1 floor ruler + gate hardening
    B1 (blocker): tab pillar fuse reached 1.0mm inboard of the rim - solid
    case material under the PCB at all 8 stations (board rests ~1.05mm
    high, bottom pads unload). Pillar now starts 0.3 outboard of the rim;
    new gates: per-tab footprint-clear probes + plan-wide PCB-rim sweep
    at z=-1.0. First attempt (fuse deletion) was wrong - the gates caught
    it: the tab lobes are cavity in the v3.1 dilation, the fuse IS the
    shelf. Tub 68.0 -> 67.4 cm3.
    T4: cover magnets 04x1.5 (16 pcs, pocket 1.7, floor 0.8 -> 1.3mm);
    faces still meet at the lip plane; BOM rows added (magnets were
    missing enti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
    [Hojicha44-Left.kicad_pcb, Hojicha44-Right.kicad_pcb]
2026-10-18 release v0.3.1: re-cut @8092ca28ce3c — boards changed (pwrsw shift), MANIFEST stamp clean
    [Hojicha44-Left-B_Cu.gbl, Hojicha44-Left-B_Mask.gbs, Hojicha44-Left-B_Paste.gbp, Hojicha44-Left-B_Silkscreen.gbo, Hojicha44-Left-Edge_Cuts.gm1, Hojicha44-Left-F_Cu.gtl, Hojicha44-Left-F_Mask.gts, Hojicha44-Left-F_Paste.gtp]
2026-10-19 M3: recentre pwrsw to SAT window centres 106.3/185.2 — plateau frozen to committed Edge.Cuts, routes regenerated (nets 20/45 router-owned, silk ref_shift mirrored)
    Multi-model datasheet verification overturned the M2 offset reading; the
    switch is now centred on the SAT-pinned window on both halves (mirror-exact
    about x=145.75). Window tracks the switch via ergogen pwrsw shift 11.3;
    plateau decoupled and frozen so frame stays axis-exact. Gates: gen_pcb exit
    0, DRC 28 x W1-waived per half only, ERC 0 err / 5 spare warns per half,
    topology 0 dangling, npm test green, plate --check CLEAN, case+cover
    regenerated with census green. Switch body 101.3..111.3, lever band
    0.70/side vs window - was 4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
    [Hojicha44-Left-plate.dxf, Hojicha44-Left.kicad_pcb, Hojicha44-Left.kicad_sch, Hojicha44-Right-plate.dxf, Hojicha44-Right.kicad_pcb, Hojicha44-Right.kicad_sch]
2026-10-19 M3.1: post-audit P0 batch + provenance pipeline
    - gen_pcb: pcb/kicad/hand-copper.txt manifest replaces the
    classify-by-reproduction heuristic (phase-1 deleted; extraction reads
    the committed baseline via git HEAD; copper gates before write; a
    DRC-rejected board is archived + reverted so it never feeds the next
    build). Idempotency proven: three consecutive regens byte-identical
    modulo uuid/date, DRC clean (28 W1-waived only); Left corridor
    regenerated fresh and converged (the 6 stale corridor items were
    router-owned; frozen they pinned a 1.0607mm via collision).
    - gen_route: via rules from this round stand — signal pads 0.60->0.65
    (annular), same-net pairs keep the drill rul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
    [Hojicha44-Left-plate.dxf, Hojicha44-Left.kicad_pcb, Hojicha44-Left.kicad_sch, Hojicha44-Right-plate.dxf, Hojicha44-Right.kicad_pcb, Hojicha44-Right.kicad_sch]
2026-10-19 release v0.3.1: re-cut @ab0652338e9c — boards changed (provenance pipeline + P0 batch), MANIFEST stamp clean + ENIG finish
    [Hojicha44-Left-B_Cu.gbl, Hojicha44-Left-B_Mask.gbs, Hojicha44-Left-B_Paste.gbp, Hojicha44-Left-B_Silkscreen.gbo, Hojicha44-Left-Edge_Cuts.gm1, Hojicha44-Left-F_Cu.gtl, Hojicha44-Left-F_Mask.gts, Hojicha44-Left-F_Paste.gtp]
2026-10-19 CI verdict fixes: track points.yaml gate input; keymap L2 sensors to volume pair
2026-10-19 CI fixes round 2: fetch-depth 0, tracked kicadsexpr netlists for KiCad-less gates
    [gen_pcb.py]
2026-10-19 release v0.3.1: re-cut @df2bfb0a895a — CI gate hardening (no board change)
    [Hojicha44-Left-B_Cu.gbl, Hojicha44-Left-B_Mask.gbs, Hojicha44-Left-B_Paste.gbp, Hojicha44-Left-B_Silkscreen.gbo, Hojicha44-Left-Edge_Cuts.gm1, Hojicha44-Left-F_Cu.gtl, Hojicha44-Left-F_Mask.gts, Hojicha44-Left-F_Paste.gtp]
2026-10-19 CI fix round 3: track board.dxf outline for check_board placements
    [board.dxf]
2026-10-19 CI fix round 4: vendor six stock footprint defs for KiCad-free pad reconstruction
    [gen_pcb.py]
2026-10-19 release v0.3.1: re-cut @e67bb0ae5de2 — CI gate hardening round 4 (no board change)
    [Hojicha44-Left-B_Cu.gbl, Hojicha44-Left-B_Mask.gbs, Hojicha44-Left-B_Paste.gbp, Hojicha44-Left-B_Silkscreen.gbo, Hojicha44-Left-Edge_Cuts.gm1, Hojicha44-Left-F_Cu.gtl, Hojicha44-Left-F_Mask.gts, Hojicha44-Left-F_Paste.gtp]
2026-10-19 docs: manufacturing order guide (JLCPCB field-by-field, pcb/MANUFACTURING.md)
2026-10-20 design audit round: symmetric magnet stations, reviewer-floor margins, 5 new PCB gates
    Six-review synthesis round (2026-10-20). Fixes, gates, and the doc
    reconciliation they forced — no board geometry change (routed copper
    re-verified clean: min clearance 0.3064/0.3750, antenna keepout
    5.175/5.225 >= 5.0).
    Case/plate
    - magnet stations symmetric BY CONSTRUCTION: the LEFT set is computed
    once per geometry and mirrored (x -> 291.5 - x = 2*MIRROR_AX) for
    Right, re-validated against the right boundaries/obstructions/
    antenna; an asymmetric rejection aborts the build. The old per-half
    walk resolved to 6 stations on Left vs 7 on Right, putting Left's
    retention ON the >=1.5 kg pull-test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
    [Hojicha44-Left-B_Cu.gbl, Hojicha44-Left-B_Mask.gbs, Hojicha44-Left-B_Paste.gbp, Hojicha44-Left-B_Silkscreen.gbo, Hojicha44-Left-Edge_Cuts.gm1, Hojicha44-Left-F_Cu.gtl, Hojicha44-Left-F_Mask.gts, Hojicha44-Left-F_Paste.gtp]
2026-10-20 release v0.3.1: re-cut @21a165eed089 — six-review design audit round (no board change)
    Re-cut because the fix batch touched pcb/generators (board-affecting
    pathspec). Copper is unchanged: the audit round moved no track, via or
    pad — it raised case/plate margins to the reviewer floors and grew the
    committed-artifact gates (pad/via containment, antenna keepout, TRRS
    crossover pin-map, W1 pad-content equality, silk-to-edge).
    The manifest stamp is now clean: "pcb-baseline-r10-67-g21a165e" (no
    "-dirty"). Root cause fixed in make_release.py — the tree stamp was
    taken after the cut deleted the tracked release dir, so every cut
    self-reported a dirty tree it never had; the stamp is now capture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
    [Hojicha44-Left-B_Cu.gbl, Hojicha44-Left-B_Mask.gbs, Hojicha44-Left-B_Paste.gbp, Hojicha44-Left-B_Silkscreen.gbo, Hojicha44-Left-Edge_Cuts.gm1, Hojicha44-Left-F_Cu.gtl, Hojicha44-Left-F_Mask.gts, Hojicha44-Left-F_Paste.gtp]
2026-10-20 design audit round: close two gate defects + single-source the port anchors
    Self-review of the audit batch before sign-off found three real defects
    in the new code and one unverified assumption. All fixed, all with
    negative controls.
    - check_board's new silk-to-edge gate sampled only polyline VERTICES:
    a silk line running parallel to the edge is closest along its
    INTERIOR, and a silk line that CROSSES the edge has true distance 0
    while its endpoints sit far away — both would have read as clear.
    Now exact segment-to-segment distance (crossing = 0). Control: an
    injected crossing silk reports 0.00mm and fails the gate; the old
    scan reported 2.00mm and passed it.
    - the mirrored-st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
    [check_board.py]
2026-10-20 release v0.3.1: re-cut @7d86ca8b998b — post-self-review fixes (no board change)
    Re-cut because the self-review fixes touched pcb/generators (the
    board-affecting pathspec). Copper unchanged: the fixes were gate
    logic and the port-anchor single-source, not routing.
    Manifest stamp clean: "pcb-baseline-r10-69-g7d86ca8" (no "-dirty").
    Gerber diffs vs the previous cut are creation-date lines only.
    [Hojicha44-Left-B_Cu.gbl, Hojicha44-Left-B_Mask.gbs, Hojicha44-Left-B_Paste.gbp, Hojicha44-Left-B_Silkscreen.gbo, Hojicha44-Left-Edge_Cuts.gm1, Hojicha44-Left-F_Cu.gtl, Hojicha44-Left-F_Mask.gts, Hojicha44-Left-F_Paste.gtp]
2026-10-20 docs: keep the 2026-10-20 design-audit reports as review records
    The six-review round's raw findings reports, committed so the accepted
    / rejected ledger in notes.md can be checked against its sources. Each
    file carries a provenance header: read-only review INPUT, not a spec,
    and every measured number in it is the PRE-fix state (tub 67.4 cm3,
    wall_min 1.49/1.50, 6/7 magnet stations) — current truth lives in the
    generators and notes.md.
2026-10-21 design audit round 2: gates read the artifact, release re-runs DRC, absolute floors
    Second review round (three max-thinking reviewers run one at a time:
    MiniMax M3.1 Flash Free, GLM-5.3 Flash Free, DeepSeek V4.1 Flash Free).
    31 raw findings; the three converged on the same systemic shape — gates
    that re-derived what they claimed to verify.
    Gates now read the committed artifact
    - check_board parses the COMMITTED board's own pad blocks (flip and
    y-axis convention verified pad-for-pad against the generator's model)
    and containment, the antenna keepout (pads + vias + TRACKS, which
    nothing covered), the TRRS crossover pin-map (the board's own pad
    nets) and W1 content (now including the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
    [check_board.py, gen_pcb.py, gen_route.py]
2026-10-21 release v0.3.1: re-cut @a45f3e87a358 — artifact-reading gates + fresh DRC (no board change)
    Re-cut because the audit-round-2 fixes touched pcb/generators (the
    board-affecting pathspec). Copper is unchanged: the round moved no
    track, via or pad — it changed what the gates READ and what the cut
    PROVES.
    The manifest now certifies the board bytes (board sha256) and the
    ERC/DRC reports in the release are re-run on the exported board at cut
    time (fresh report 12:31 vs the 08:05 one the old cut would have
    copied). Stamp clean: pcb-baseline-r10-72-ga45f3e8.
    [Hojicha44-Left-B_Cu.gbl, Hojicha44-Left-B_Mask.gbs, Hojicha44-Left-B_Paste.gbp, Hojicha44-Left-B_Silkscreen.gbo, Hojicha44-Left-Edge_Cuts.gm1, Hojicha44-Left-F_Cu.gtl, Hojicha44-Left-F_Mask.gts, Hojicha44-Left-F_Paste.gtp]
2026-10-21 docs: refresh the stale PORTS pointer in gen_plate, drop an unsourced pad-pair size
    Audit pass over the second review round's findings found two leftovers:
    the plate's port-rect comment still pointed at case/gen_case.py PORTS
    (now case/params.py) with the pre-mirror trrs anchor and the pwrsw NW
    corner, and the new BOM_ORDER socket line carried a pad-pair size that
    no spec states (removed rather than invented).
2026-10-21 frame: store board y-negated so releases match plate; gate it
    KiCad's Gerber/drill/pos writers negate stored y. The board was stored
    in the plate/case design frame, so every release was the Y-mirror of the
    plate: T12 centres landed on the mirror of the cutouts and the T10 switch
    posts were handed the wrong way (a standard Choc could not install).
    - add pcb/generators/frame.py: full board reflection (global + footprint
    local geometry/angles), title-block frame marker, idempotent readers
    - gen_pcb builds in design frame and reflects at the write boundary
    - plate/case/check_board readers convert storage -> design
    - check_board: cross-artifact frame gate (T12 centres, T10 post
    handedness,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
    [Hojicha44-Left-B_Cu.gbl, Hojicha44-Left-B_Mask.gbs, Hojicha44-Left-B_Paste.gbp, Hojicha44-Left-B_Silkscreen.gbo, Hojicha44-Left-Edge_Cuts.gm1, Hojicha44-Left-F_Cu.gtl, Hojicha44-Left-F_Mask.gts, Hojicha44-Left-F_Paste.gtp]
2026-10-21 check_board: gate release pos.csv against the design frame
    KiCad's pos writer reflects both Y and rotation, so a correct gerber set
    can still ship with a mirrored assembly file. Verify every release pos
    row against the committed board in design frame (position + rotation),
    with 0.5mm and 1-degree negative controls in --self-test.
    Also fix the release ignore rules: /generated/ excluded the parent
    directory, so the later !release patterns could not re-include v0.4.0
    without force-add.
    [check_board.py]
2026-10-21 release: v0.4.0 frame-corrected fabrication bundle
    Cut from board commit da35227. All release artwork is now in the
    plate/case design frame: T12 drill centres match the plate cutouts to
    0.0000mm, T10 posts pass the standard Choc handedness test, the USB
    notch floor matches the plate, and pos.csv carries design-frame
    positions/rotations. Manifest uses full SHA-256 for every file and the
    board bytes; verify with python3 pcb/make_release.py --check.
    [Hojicha44-Left-B_Cu.gbl, Hojicha44-Left-B_Mask.gbs, Hojicha44-Left-B_Paste.gbp, Hojicha44-Left-B_Silkscreen.gbo, Hojicha44-Left-Edge_Cuts.gm1, Hojicha44-Left-F_Cu.gtl, Hojicha44-Left-F_Mask.gts, Hojicha44-Left-F_Paste.gtp]
2026-10-21 release: re-cut v0.4.0 after the pos-gate commit
    The release-currency gate treats pcb/generators changes as board-
    affecting, so e4077ed moved the certified commit even though the board
    bytes are unchanged. Re-cut the bundle from e4077ed; the board hashes
    are unchanged, only the export timestamps and manifest digests are new.
    python3 pcb/make_release.py --check -> CLEAN
    python3 pcb/generators/check_board.py --self-test -> CLEAN
    [Hojicha44-Left-B_Cu.gbl, Hojicha44-Left-B_Mask.gbs, Hojicha44-Left-B_Paste.gbp, Hojicha44-Left-B_Silkscreen.gbo, Hojicha44-Left-Edge_Cuts.gm1, Hojicha44-Left-F_Cu.gtl, Hojicha44-Left-F_Mask.gts, Hojicha44-Left-F_Paste.gtp]
2026-10-21 layout: close H-7 left/right mirror (plateau + plate tabs)
    The right board outline consumed mirror_matrix_inner_top plateau
    points in left-order, which mirrored the polygon's turn direction and
    left a 0.41mm north-plateau bump at x=196.7 (plate outline 1.16mm,
    tab-4 0.40mm / 6.16 deg). Swap the two right plateau points so the
    outline is the exact mirror of the left.
    That fixed the board rim, but the right plate tab walk still sampled
    one 1mm grid point over at the bottom-inner tab (170.57 vs 170.64mm),
    leaving a 0.07mm plate/case asymmetry. gen_plate.py now derives the
    RIGHT tab roots from the LEFT roots and re-projects them onto the
    right rim, with an output-side 0.05mm mirror check; the r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
    [Hojicha44-Left.kicad_pcb, Hojicha44-Right-plate.dxf, Hojicha44-Right.kicad_pcb, board.dxf]
2026-10-21 release: re-cut v0.4.0 after the H-7 mirror fix
    The board outline (right plateau) and plate tabs changed, so the
    release must be cut from the H-7 board commit 81c1835. Manifest
    board hashes and every exported artifact are refreshed; the frame gate
    still proves T12/T10/USB-notch/pos alignment against the new plate.
    case/.venv/bin/python case/mirror_gate.py -> CLEAN
    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
    [Hojicha44-Left-B_Cu.gbl, Hojicha44-Left-B_Mask.gbs, Hojicha44-Left-B_Paste.gbp, Hojicha44-Left-B_Silkscreen.gbo, Hojicha44-Left-Edge_Cuts.gm1, Hojicha44-Left-F_Cu.gtl, Hojicha44-Left-F_Mask.gts, Hojicha44-Left-F_Paste.gtp]
2026-10-21 check_board: mirror every plate layer, not just the outline
    The H-7 gate compared the plate OUTLINE only. Extend it to CUTOUT and PORON as well: a switch cutout or poron pad could drift while the rim stays symmetric. The layer comparator uses a two-sided Hausdorff bound over all loops; the existing 0.5mm/0.02mm negative controls run on each layer.
    CURRENT: board 0.0000, plate outline 0.0100, cutout 0.0000, poron 0.0000 mm (floor 0.05).
    [check_board.py]
2026-10-21 release: re-cut v0.4.0 after the plate-layer mirror gate
    The release-currency rule treats pcb/generators changes as board-affecting, so the certified commit moves to 08bfb69. Board bytes are unchanged; refresh the bundle and manifest so the gate is clean.
    [Hojicha44-Left-B_Cu.gbl, Hojicha44-Left-B_Mask.gbs, Hojicha44-Left-B_Paste.gbp, Hojicha44-Left-B_Silkscreen.gbo, Hojicha44-Left-Edge_Cuts.gm1, Hojicha44-Left-F_Cu.gtl, Hojicha44-Left-F_Mask.gts, Hojicha44-Left-F_Paste.gtp]
2026-10-21 case: implement support strategy (b) — Choc clip retention, 1.2mm plate
    The rev-1 plate (15.0mm cutout, 1.5mm PC, 2.0mm gap) held the switch
    by FRICTION only: the Choc v1 clip cannot reach a 15.0mm hole and a
    1.5mm plate is thicker than the switch's 1.3mm clip band, so the
    "lower catch" never engaged (Keebio; the Sofle choc thread). The
    switch rocked in the plate and could lift out.
    Rev-2 (support b):
    * CUTOUT 15.0 -> 14.0. The PG1350 lower body is 13.8 square
    (Kailh's plate-footprint datum) and the 15.0 span is the clip wing,
    so 14.0 gives 0.10mm/side on the body (13.8 is line-to-line and
    risks a switch that will not insert) while keeping 0.50mm/side of
    clip-wing overlap for th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
    [Hojicha44-Left-plate.dxf, Hojicha44-Right-plate.dxf]
2026-10-21 release: cut v0.5.0 (support strategy b — 14.0 cutout, 1.2mm plate)
    The spec version moves 0.4.0 -> 0.5.0 with the support-(b) plate and
    the re-derived case stack, so the bundle is re-cut from 482811b. The
    PCB itself is unchanged (the diodes stay on the top side; the plate
    absorbs the change with its relief pockets), so the board hashes are
    the same as v0.4.0 and the frame gate still proves T12/T10/USB-notch
    /pos alignment against the new plate.
    python3 pcb/make_release.py --check -> CLEAN (boards @482811bf7632)
    npm test -> all spec checks ok (incl. stack-ties, w1-gate, manifest)
    [Hojicha44-Left-B_Cu.gbl, Hojicha44-Left-B_Mask.gbs, Hojicha44-Left-B_Paste.gbp, Hojicha44-Left-B_Silkscreen.gbo, Hojicha44-Left-Edge_Cuts.gm1, Hojicha44-Left-F_Cu.gtl, Hojicha44-Left-F_Mask.gts, Hojicha44-Left-F_Paste.gtp]
2026-10-21 spec: module retention decision — the PCB is retained, not the module
    Documents the hold-down answer from the module research: the module
    sits in its socket and the PCB is retained by the case (as on every
    XIAO/nice!nano board); a locating pocket, if added, must be a loose
    0.2-0.3mm fit, never a press fit in MJF PA12, and the USB plug load
    is reacted by the case's 14.0mm mouth rather than by the module.
    [electronics.yaml]
2026-10-21 release: re-cut v0.5.0 after the module-retention spec note
    spec/electronics.yaml is a board-affecting path in the release-currency
    rule, so the certified commit moves to 8523273 and the bundle is
    re-cut. Board bytes are unchanged.
    [Hojicha44-Left-B_Cu.gbl, Hojicha44-Left-B_Mask.gbs, Hojicha44-Left-B_Paste.gbp, Hojicha44-Left-B_Silkscreen.gbo, Hojicha44-Left-Edge_Cuts.gm1, Hojicha44-Left-F_Cu.gtl, Hojicha44-Left-F_Mask.gts, Hojicha44-Left-F_Paste.gtp]
2026-10-21 spec: keep the open-items research memo in the tree
    The compliance/LiPo/hold-down/pilot decisions cite the research they
    came from, so the memo moves from untracked scratch into
    spec/research-open-items-2026-10-21.md.
2026-10-21 release: re-cut v0.5.0 after the memo reference update
    spec/electronics.yaml is board-affecting in the release-currency rule,
    so the certified commit moves; the board bytes are unchanged.
    [Hojicha44-Left-B_Cu.gbl, Hojicha44-Left-B_Mask.gbs, Hojicha44-Left-B_Paste.gbp, Hojicha44-Left-B_Silkscreen.gbo, Hojicha44-Left-Edge_Cuts.gm1, Hojicha44-Left-F_Cu.gtl, Hojicha44-Left-F_Mask.gts, Hojicha44-Left-F_Paste.gtp]
2026-10-21 spec: fold the PG1350 geometry memo into the tracked research file
    The plate's gap and cutout are now sourced to measured geometry (the
    Kailh outline drawing + a community STEP model): clip lip 0.9-1.3mm,
    ears 2.2-3.0mm, body 13.8mm. That makes the gap 1.00 (not 1.05 -
    the ears would foul the plate top) and the diode relief 0.40 (the
    floor stays at 1.40mm, keeping 0.14mm over the measured 1.26mm diode
    top). Case stack follows: plate top 2.20, lip 4.70, cover 4.70..7.70,
    tub 71.1 cm3.
2026-10-21 case: gap 1.00 (not 1.05) and a 0.40mm diode relief — the ears must seat
    The PG1350 geometry memo (spec/research-open-items-2026-10-21.md §6,
    from Kailh's outline drawing + a community STEP model) pins the stack
    above the PCB: skirt 0-0.9, clip arms 0.9-2.2 with the retaining LIP
    at 0.9-1.3, then the 14.8-15.0 EARS at 2.2-3.0 that bear on the
    plate's top. The plate must therefore lie between the lip and the
    ears:
    gap 1.00 + plate 1.20 -> plate occupies 1.00..2.20
    lip grabs the underside, ears seat exactly on the top.
    The 1.05 gap I shipped in the previous commit would have lifted the
    ears 0.05mm INTO the plate (the switch pushed up, the grab reduced),
    so it is corrected to 1.00.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
    [Hojicha44-Left-plate.dxf, Hojicha44-Right-plate.dxf]
2026-10-21 spec: correct the Bluetooth SIG cost — the Adopter tier IS free
    The SIG schedule of dues and fees (effective 2026-03-01, re-fetched)
    shows Adopter MEMBERSHIP at $0 — the earlier summary led with the
    $12,000 Product Qualification Fee and read as if joining cost money.
    Restated precisely: $0 membership + $12,000 Product Qualification
    Fee (once per design) + $1,250 Company Identifier for one keyboard
    design; the Associate tier ($11,250/yr + $6,000) only pays off if a
    second design is qualified in the same year. Our keyboard is an
    Unmodified Design (Nordic's qualified nRF52840 + ZMK), so it lists
    with no new RF testing — and if the pilot is never sold or branded,
    the SIG FAQ's 'selling, b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
2026-10-21 spec: make the cutout test coupon concrete (what to ask for, what to test)
    One 100x100mm sheet of 1.2mm PC with four 20x20mm squares (13.8 /
    14.0 / 14.2 / 15.0mm holes) plus a relief-pocket square, cut by the
    same vendor in the same material, with the test procedure written
    down — a few dollars and a day instead of two full plates.
2026-10-22 plate: the encoder does not fit the rev-2 band — widen the window
    BLOCKER found by the rev-2 audit. The rev-1 encoder hole was a 12.7
    square, sized off the vendored ROT_EC11E STEP for the rev-1 plate band
    (z 2.0..3.5) where the encoder's body is 12.30 wide. The rev-2 band
    is z 1.00..2.20 (1.00 gap + 1.20 plate) and the SAME STEP measures
    the encoder's cross-section as 14.95 x 11.70 for z 0.0..1.5 (the
    A/B/C and S1/S2 terminal blocks stand proud of the 12.30 body; the
    waist starts at z 1.6). The new band therefore sits INSIDE the
    terminal blocks: the 12.7 hole fouled the encoder by up to 1.41mm/side
    and the encoder would not have passed through the plate at all.
    (The STEP is also y-mirr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
    [Hojicha44-Left-plate.dxf, Hojicha44-Right-plate.dxf]
2026-10-22 case/plate: derive the cover's antenna probe from the lip; fix stale stack numbers in the plate header
    The cover's 'no material over the antenna' probe was a literal 7.5 --
    the rev-1 cover's mid height. The cover now spans 4.70..7.70, so
    that literal happened to stay inside the cover but would have become
    a silent no-op on the next height change; it is now derived from the
    lip (TOP_LIP_Z + COVER_T/2).
    Also: the plate generator's header still advertised the rev-1 stack
    (1.5mm plate, 2.0mm gap, 1.35mm diodes) and two comments still said
    0.35mm relief. All now state the rev-2 numbers (1.2 / 1.00 / 14.0 /
    0.40 / diodes 1.260 measured).
2026-10-22 docs: purge the rev-1 numbers from the order-facing docs
    The rev-2 stack landed in the code but several DOCUMENTATION files
    still carried the rev-1 values — including the BOM, which is what the
    user actually orders from:
    * spec/bom.md: the plate row said "1.5mm ... 22x 15x15 Choc cutouts,
    12.7^2 encoder hole" (all three now wrong: 1.2mm / 14x14 / 16.2x12.4)
    and did NOT mention the RELIEF layer at all — the vendor would have
    cut the diode pockets through. It now states the partial-depth
    instruction explicitly. The knob row's overhang note now matches
    the new window.
    * spec/case.md: the magnet/cover stack still quoted the old lip
    (6.0 -> 4.70) and the old cover span (6.0..9.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
2026-10-22 audit: fix the PCB-audit findings + two compliance corrections
    The PCB/release audit (deepseek v4.1 flash) returned nine findings; all
    are addressed here. Two of my OWN compliance claims were also wrong
    and are corrected against the primary sources.
    MAJOR
    * spec/first-article.md: the plate-clearance step still described
    rev 1 ("diodes stand ~1.35mm ... 2.0mm gap -> 0.65mm clearance, slide
    a 0.5mm feeler under the plate"). In rev 2 a 0.5mm feeler CANNOT
    pass under the plate -- the relief pockets are only 0.55 deep -- so
    the test would have FAILED on a correct build. It now checks the
    opposite: the pocket must not be cut through (0.65mm of plate left),
    and a feeler must NOT pas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
    [Hojicha44-Left-plate.dxf, Hojicha44-Right-plate.dxf]
2026-10-22 release: re-cut v0.5.0 after the audit fixes
    spec/electronics.yaml and pcb/generators/check_board.py are
    board-affecting paths, so the certified commit moves to 4adf5fb. The
    board bytes are unchanged; the bundle and manifest are refreshed.
    make_release --check -> CLEAN (boards @4adf5fbf8e9c)
    [Hojicha44-Left-B_Cu.gbl, Hojicha44-Left-B_Mask.gbs, Hojicha44-Left-B_Paste.gbp, Hojicha44-Left-B_Silkscreen.gbo, Hojicha44-Left-Edge_Cuts.gm1, Hojicha44-Left-F_Cu.gtl, Hojicha44-Left-F_Mask.gts, Hojicha44-Left-F_Paste.gtp]
2026-10-22 M3.3: keymap FINAL — 4 generated variants (mac/win x left/right-space), timeless home-row mods; gates moved into gen_keymap.py; relief docs synced 0.40->0.55
    - config/gen_keymap.py derives every binding from spec/layout.yaml and
    emits the ACTIVE keymap + all 4 variants; --check byte-compares 5
    files and structurally validates each (46x4 vs dtsi RC count, sensor
    rules, mod positions, computed hold-trigger lists, chord, sideband);
    proven non-vacuous by 5 negative controls
    - home-row mods per ZMK's documented recipe at pinned v0.3 (verified
    against the binding YAML): balanced, require-prior-idle 150,
    tapping-term 280, quick-tap 175, positional triggers + hold-trigger-
    on-release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
    [gen_keymap.py, layout.yaml]
2026-10-22 audit: close the remaining doc-vs-code drift before ordering
    - MANUFACTURING: relief 0.40 -> 0.55 (fab instruction), tub volume 75.7 -> 71.1
    - BOM_ORDER: plate 1.5 -> 1.2mm (Choc clip), volume, +PPTC fuse row, header v0.5.0
    - encoder window 12.7 -> 16.2x12.4 in README, layout.yaml, first-article
    - first-article: VBAT 184.82 -> 232.10mm measured; ~23mV drop
    - spec/bom: keycap row + PPTC in the pack+ lead
    - layout.yaml meta: 0.9.3, 54 footprints/half
    - case/README: plate stack +1.00/+2.20, current 71.1 cm3 census
    - research: 1.3mm gap recommendation marked superseded by the PG1350 1.00mm band
    - gen_plate comments: 0.40 -> 0.55; floor-gate wording clarified
    [layout.yaml]
2026-10-22 audit1+M3.4 F01: ';' row terminators INSIDE bindings arrays = dtc syntax error
    - dtc 1.8.1 controlled dyad: newline-separated rows compile clean; every
    ';'-interior shape (<&kp 7; &kp 7>, <7;>, gen emission '<7;\n7;>') errors
    exactly at the ';'. Emission matched none of the 350 v0.3 in-tree keymaps;
    the CI-compiled draft (063e47e) uses newline rows.
    - gen_keymap.py: bindings_dt emits bare-newline rows now; validate() rejects
    any interior ';' inside 'bindings = <?>' (node-only regex gate, no dtc dep)
    - regenerated all 4 variants + active; diff is +/- ';' only
    - harness (untracked scratch opencode/dtc_keymap_test.py): all 5 CLEAN,
    pre-fix file FAILS naming the guilty row (negative co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
    [gen_keymap.py]
2026-10-22 audit1 F03: encoder steps 15 -> 60 — v0.3 ec11 counts quadrature deltas/rev
    - ec11.c (v0.3): val = pulses*360/steps where 'pulses' accumulates
    single-state gray deltas; the keymap sensor loop then slices degrees by
    triggers-per-rotation. 'steps' = events/rev, not ALPS pulse periods:
    15 periods x 4 deltas = 60. In-tree reference sofle v0.3:
    20-detent full-cycle part, steps = <80> / TPR 20.
    - With steps=15 (24deg/delta) a clean 2-delta click reports 48deg = FOUR
    TPR-30 triggers per click, and a raced 00->11 sample is delta=0 —
    0 ticks either way. With steps=60 each click is 12deg = one trigger.
    - dtsi comment + spec_checks gate updated (assert steps=60, TPR=30);
    datasheet wor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
2026-10-22 audit1 F04+F05: gen_keymap gate hardening (thumbs full-coverage, sideband wiring, ordered transform)
    - validate() now asserts ALL 10 thumb slots 36-45 (Esc/L1/Tab/<Space|Enter>,
    two &none ghost gaps, Del/L2/BSPC/<Enter|Space>) — an ESC<->TAB swap or a
    filled ghost gap passes every binding-count check (negative-controlled).
    - sideband check extended: kscan = <&enc_push_kscan> + row = <0> +
    column = <0> + Mute — the dtsi push contract is now pinned in the gate.
    - dtsi transform asserted IN ORDER against CANON_MAP_ORDER (audit-verified
    column contract: left 0-5 outer->inner, right mirrored at col-offset 6,
    thumbs RC(3,0..3)/gaps RC(3,4),(3,5)/right RC(3,6..9)); a hand reorder
    or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
    [gen_keymap.py]
2026-10-22 audit1 F06+F07: purge stale strings (thumb geometry, layer count, adjust anchors, conf absence)
    - layout.yaml thumb header: R=90/13.2deg -> the measured R=91.2/13.9 (the
    rev-3 note already said this; header and note now agree), and the two
    contradictory numbers are gone
    - layout.yaml notes: dropped "Tab is an L1+Space combo (provisional)" —
    Tab is a plain base-layer key since rev 3
    - keymap.md + gen_keymap.py: bootloader/reset described by their real
    anchors (keycap W / keycap E above the ring/middle home mods); the
    unverifiable "miryoku: reset on the top-row pinky column" attribution
    is removed (E is not the pinky column in any reading)
    - spec_checks header: "exact 2 layers" -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
    [gen_keymap.py, layout.yaml]
2026-10-22 audit2: mechanical-audit fixes — relief pocket, artifact gates, capture window
    - F-01 (P0): BOM_ORDER plate row now carries the DXF layer contract
    (OUTLINE/CUTOUT through; RELIEF = 22x 0.55 partial-depth pockets in
    the underside, do NOT cut through; PORON = punch template not a cut)
    and asks the shop FIRST about 0.55 partial-depth capability
    - F-02 (P1): diode relief pocket re-derived from the SOD-123 outline
    max (DS30086 rev 31-2 p4: E 2.55-2.85 long, D 1.40-1.70 wide, A
    1.00-1.35 = height) + the vendored STEP's widest section (2.700x1.550
    at the plate plane; 2.566x1.416 was the chamfered top face) ->
    pocket 3.15x2.00. Old basis left 0.008mm/side against a
    datasheet-max pa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
    [Hojicha44-Left-plate.dxf, Hojicha44-Right-plate.dxf]
2026-10-22 audit3: verify audit cycle — transport memo fix, census re-measure, R3-03 defer
    - R3-01 (P2): the transport memo carried "UN 3480, PI 965 Section II
    (packed with equipment)" — IATA deleted PI 965 Section II (DGR 63rd
    ed, effective 1 Apr 2022; IATA 2026 guidance = DGR 67 lists bare
    cells only as PI 965 IA passenger-forbidden / IB, <=30% SoC from
    1 Jan 2026 per SP A331), and "packed with equipment" mispairs the UN
    number (UN 3481 = PI 966 II packed-with / PI 967 II contained-in).
    Memo bullet rewritten with sources; electronics.yaml (UN 3481 /
    PI 967 II) was already correct
    - R3-02 (P2): notes.md Left census "446 copper items" predates the last
    copper pass; re-measured on th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
2026-10-22 audit3: NIM cross-check — SoC-clause fix, manifest-note fix, two defers
    - Round-3 session re-bound to nvidia NIM deepseek-v4.1-flash for an
    independent verification pass (no zen respawn; deepseek v4.1 was the
    originally requested auditor family). Verdicts: R3-02 VERIFY,
    R3-03 defer VERIFY (no consumer of the .net source/date fields;
    board_commit covers pcb/kicad + pcb/generators), R3-01 QUALIFY
    - R3-01 clause fix: the <=30% SoC rule for bare UN 3480 applies since
    2016 (ICAO April-2016 rule), not from 2026; 1 Jan 2026 is when it
    extends into PI 966 packed-with-equipment (recommendation 2025,
    mandatory 2026, >2.7 Wh — our 0.407 Wh cell is under either way);
    SP A331 is the >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
2026-10-22 audit: close F02 — CI green on pushed tip ca48bd4
    - 39 commits pushed (03c5f49..ca48bd4); both workflows success at
    ca48bd465acda07d1c2242a4ab17d58986ad7674: Static repo checks run
    39864726437, ZMK firmware build run 39864726932
    - the audit cycle is fully closed: every finding fixed, refuted on a
    primary source, or explicitly deferred (next-re-cut batch: R3-03,
    A-01, A-03); remaining pre-order items are the user-action gates
    (cutout coupon, 0.55 partial-depth confirm, copper-edge confirm,
    Bluetooth-SIG consultant)
2026-10-22 research: fab capability — JLCPCB 0.2mm tab-route rule verified, PCBWay depth milling; BT-SIG gate dropped
    - copper-to-edge 0.292mm PASSES the applicable rule: JLCPCB 2026
    layout guide sets 0.3mm for V-cut panelization but 0.2mm for
    tab-routing (outline blog: "at least 0.2mm clearance from routed
    edges to copper features") — the order is TAB-ROUTE, so the notch
    corridor clears with 0.092mm margin; written fab confirmation gate
    dropped, precision routing tier (+-0.1mm) preferred at quote
    - partial depth researched: JLCPCB publishes no controlled-depth
    milling (capabilities page, fetched 2026-10-23); PCBWay documents
    Z-Axis pocket milling (help page 2026-02-02, "pocket millin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
2026-10-23 research: pocket/clearance split across plate vs PCB orders — conflict dissolves; JLCCNC cavity-depth as plan B-prime
2026-10-23 board: copper-edge nudge past 0.3mm — fab-agnostic; bundled re-cut batch
    - owner ask: raise min copper-to-edge past PCBWay's 0.3mm profile rule
    so both fabs can quote the PCB. Binding spots were three track
    corners: /COL0_L (0.292 rim), /TRRS_T (0.330), /COL0_R (0.332)
    - one-grid-step nudges chosen by measured sweep (whole re-aimed
    segments vs every edge primitive + other-net copper): Left
    0.292 -> 0.536, Right 0.330 -> 0.575 / 0.332 -> 0.576; new board
    minima Left 0.406 / Right 0.575 — inside BOTH fab rules with
    tolerance headroom (routing +-0.1 precision / +-0.2 regular)
    - regen-stable: the six segments declared in hand-copper.txt (first
    Right items); manifest lines are d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
    [Hojicha44-Left.kicad_pcb, Hojicha44-Left.kicad_sch, Hojicha44-Right.kicad_pcb, Hojicha44-Right.kicad_sch]
2026-10-23 release: re-cut v0.5.0 @8eef566 — post-nudge boards
    - gerbers/drill/pos/bom + DRC/ERC reports regenerated from the
    copper-edge-nudged boards (commit 8eef566)
    - DRC: unchanged exact W1 set (28x lib_footprint_mismatch per half,
    0 non-waived); ERC: 0 errors + the 5 documented spare labels — the
    three moved corners are DRC-clean
    - manifest stamps the new board sha256 bytes and the board-affecting
    commit; gbrjob Revision now 0.5 via the re-stamped title blocks
    [Hojicha44-Left-B_Cu.gbl, Hojicha44-Left-B_Mask.gbs, Hojicha44-Left-B_Paste.gbp, Hojicha44-Left-B_Silkscreen.gbo, Hojicha44-Left-Edge_Cuts.gm1, Hojicha44-Left-F_Cu.gtl, Hojicha44-Left-F_Mask.gts, Hojicha44-Left-F_Paste.gtp]
2026-10-23 renders: phase-10 pipeline — asset build + Blender scene + keycap sourcing
    - renders/build_assets.py (case/.venv): kicad-cli PCB STEP exports
    (tracks/pads/zones/mask/silk; VRML component models skipped by
    kicad-cli itself — hidden under the plate anyway), named glTF
    conversion via OCCT CAF reader (assembly walk so footprint names
    survive), plate solid extruded from the tracked DXF (OUTLINE 1.2mm,
    CUTOUT through, RELIEF 0.55 pockets), procedural EC11 knob (13x13 +
    knurled crown) and M2 screw, placements.json parsed from the
    committed boards, PROVENANCE.json
    - renders/scene.py (Blender 5.2 headless): assembly in the storage
    frame — two lessons encoded as guards: the glTF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
2026-10-23 docs: repository-layout map in README; gitignore the agent scratch dir
    - README gains a per-path table answering what boards/, config/, spec/,
    zephyr/module.yml, build.yaml, generated/, node_modules/, out/ and
    opencode/ each are, tracked or not, and why spec and config are NOT
    duplicates (spec = engineering source; config = ZMK build inputs,
    with the keymaps generated from the spec and byte-gated in CI)
    - opencode/ (harness scratch + gen_pcb's documented pre-regen board
    archive) is untracked by design — now explicitly ignored instead of
    polluting git status
2026-10-23 renders: seat encoder knobs on the bushing; lock phase-10 bright views
    - assemble in the design frame (y-up) and register every switch to the
    plate CUTOUT holes; abort above 0.05 mm. Measured 22/22 per half,
    worst 0.0000 mm, so caps and thumb rotations come from the matched
    hole, not a separately derived origin
    - measure the EC11 stack (body to 5.0, bushing to 14.5, shaft to 24.54)
    and seat the 10 mm knob on the bushing instead of 4 mm up the shaft:
    base 14.64, top 24.64, so the shaft is enclosed rather than exposed
    - that seat assumes a deep or through knob bore; a 6 mm blind bore would
    stand the knob 4 mm higher. Lift knobs 12 mm when exploded so they
    still clear the encoder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
2026-10-23 renders: bare encoders, G/H homing, procedural texture pass
    - drop the knob from the product views entirely: the sourced knob read
    as a tall round keycap, so the EC11 is left bare in hero and exploded.
    The knob glb stays in the asset build for future fit checks
    - move the homing caps one column inboard to the inner index home keys
    (G/H); F/J read one key too far out on each half. Measured homing
    holes (76.0,24.0) left and (215.5,24.0) right
    - add procedural surface textures: generated-coordinate noise drives a
    bump normal and roughness range on the PA12 tub/cover, PBT caps, PC
    plate, soldermask/silk and pads. No external image maps
    - add a 4 m studio floor 0.2 mm under the tub bo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
2026-10-24 case+renders: thin top plate, component windows, round TRRS side hole
    - the plate stays at the Choc v1 clip band (1.00..2.20) - moving it up
    would lose the clip - so the top comes down: TOP_LIP_Z 4.70 -> 3.20
    (new 1.5mm TOP foam at 33%, new TOP_PRELOAD) and COVER_T 3.0 -> 2.0.
    Keycaps now stand 2.4mm proud of the top plate instead of 1.6
    - the cover is a top PLATE, not a rim ring: one merged key-field
    opening around the 22 KLP cap footprints, plus windows for the MCU,
    the EC11 body (shrunk to the measured 12.0x11.7 body at the cover
    band +0.5/side, so the rectangular terminal base is covered), the
    pwrsw body/nail and the shared USB slot. Enclosed material islands
    are dropped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
2026-10-24 case+renders: key-field ledge, Ø6.0 audio side hole
    - relieve a 0.8mm-deep, 3mm-wide ledge around the merged key-field
    opening (KEY_LEDGE_W/D): the caps now stand ~3.2mm proud of the
    surface they sit in, while the outer band, magnets and gasket press
    keep the full 2.0mm plate height. The pad-press gate's second probe
    moved to z0+1.0 so it stays under any ledge
    - enlarge the TRRS side hole from Ø5.2 to Ø6.0 (zc 1.5): a 3.5mm plug
    barrel keeps 1.25mm/side and the first few mm of most slim grips
    pass; the 0.7mm closed roof under the 5.2 top is unchanged and
    re-verified by a wall section
    - re-render bright hero + exploded at 1600x1000/96; MANIFEST rehashed;
    static gates green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
2026-10-24 case: lower the whole keyboard — floor -5.6 -> -4.65, slab 1.7
    User review: the keyboard did not read as thin. The top half is
    already minimal (1.0 foam + 2.0 cover over the plate); the 12.80mm
    height was almost all bottom tub — 4.0mm of air under the PCB plus a
    2.0mm slab, provisioned by the below-PCB protrusions (encoder legs
    -3.65 untrimmed, pwrsw <=-3.5, TRRS pins -3.0, sockets -2.85).
    No trimming (user: components must not change), so:
    - FLOOR_CLEAR = 1.0mm under the deepest untrimmed part (-3.65);
    FLOOR_Z -5.6 -> -4.65
    - the implicit 2.0mm slab becomes FLOOR_T = 1.7 (MJF-safe, braced by
    the 8 tab pockets); gen_case build + zmin gate now derive from it
    - tub bottom -7.60 -> -6.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
2026-10-24 review triage: strength audit (PETG), z-stack gate, order-time STEPs
    Three review reports triaged; everything confirmed and fixable in-repo
    is fixed here. Physical/procurement items stay in first-article (they
    need hands and parts; the checklist now sequences them honestly).
    STRENGTH (user: "strong enough in PETG, 100% infill, no exotic materials")
    - measured thin-feature census: tub wall 2.62, pocket web 2.45, floor
    1.70, cover web 1.69, ledge web 1.20 (by construction), magnet floor
    1.30, TRRS roof 0.70 (plate material around a hole, not a span)
    - PETG @100% (E~2.1 GPa) is stiffer than the MJF PA12 reference on
    every load path; risks are warp/dimensional, not strength; print
    guida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
    [Hojicha44-Left-cover.step, Hojicha44-Left-tub.step, Hojicha44-Right-cover.step, Hojicha44-Right-tub.step]
2026-10-24 renders+cover: tall tilted caps, clean ledge field, hi-fi nano stand-in
    User review round:
    - the ledged field showed artifacts: 0.52mm ROW webs stood proud as
    "ridges and dots" between the thumb cluster and the main field
    (CAP_CLEAR 1.0 merged columns but not rows), and the full-height
    strip between the ledge border and the component windows read as
    "something juts out" near the encoder. Fix: CAP_CLEAR 1.0 -> 1.5 so
    rows merge too (one clean field, zero enclosed scraps, cover 14.2
    cm3), and the ledge now includes the dilated component windows with
    keepouts around the rim ports (TRRS roof re-verified 0.7 by section)
    - renders switch to the KLP Normal_Tilted family (top ~11.1mm a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
    [Hojicha44-Left-cover.step, Hojicha44-Right-cover.step]
2026-10-24 render+geometry: flat no-indent cover, 0.4mm chamfer, 15mm-actuator encoder, multi-material nano + texture pass
    - gen_cover: drop the 0.8mm ledge (review round 3 'questionable geometry');
    flat cover, rim-only 0.4mm chamfer as the sole embellishment
    - params: remove KEY_LEDGE_* (no ledge); CAP_CLEAR 1.5 still full flat proud caps
    - tests/spec_checks.cjs: drop the ledge-web PETG gate (structure now a flat plate)
    - renders/scene.py: (a) EC11 shaft truncated to 15.0mm (L1=15 BOM variant) +
    two-tone gunmetal/steel metal split; (b) nice!nano stand-in upgraded — gold
    individual castellated pads, copper traces+jogs, vias, silkscreen text,
    crystal, reset button, nRF QFN, USB-C shell; (c) ma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
    [Hojicha44-Left-cover.step, Hojicha44-Right-cover.step]
2026-10-24 render+docs: short-shaft encoder + low fluted knob, tall thumbs, colourway hierarchy, posed hero
    Encoder (round-4 review: 'shaft still exceptionally tall'):
    - RESEARCH: the vendored EC11E STEP is the 20mm-actuator part (tip
    24.55mm); my earlier '15mm-actuator' BOM reading was a misdecode.
    The real low-profile answer is the short-shaft EC11-class (Sofle
    Choc build guide's documented choice, keeps the push switch) or the
    ALPS EC12 (8.5mm total, but NO push + needs the window opened).
    - scene.py: truncation now actually works — the first cut selected on
    MESH-LOCAL z which is design Y (the board glb keeps its -90deg X
    fix on the root), so nothing was ever deleted and the full shaft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
2026-10-24 renders: complete 1.5k set + framecheck tool + fixed exploded diagram
    Full delivery set at 2400x1500 (69 MB, 17 PNGs, all framecheck-verified):
    hero, top (ortho layout proof), macro_encoder (posed knob dead-centre),
    macro_keys (cap cluster beside the seam), orbit_00..11 (12-frame
    turntable), exploded (stack-colour diagram) — MANIFEST.json rehashed.
    --framecheck (new): pre-flight NDC projection of every object through
    every camera (hand-rolled lens/sensor maths; Blender 5.x dropped
    scene.world_to_camera_info). All shots PASS with margins before any
    sampling. Catches this round: (1) macro_enc targeted the PRE-pose
    encoder coordinate — the tented halves moved it and the camera stared
    at an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
2026-10-24 env: full desk-environment renders (desk + mat closeup) + reusable build_keyboard refactor
    scene.py: extracted init_scene() + build_keyboard(args) from main()
    (allows importing the exact assembly without executing the studio
    pipeline; entry point now guarded). Regression: framecheck numbers
    byte-identical to the committed run for every shot. Two depsgraph
    fixes found while regressing: bbox_mm/move_z now evaluate
    view_layer themselves — the exploded shot's move-back previously
    left the NEXT shot's bbox reading stale +52mm transforms.
    scene_env.py (new): wraps the same posed keyboard in a desk
    environment —
    desk: monitor + stand, Mac mini squircle, mouse, pen cup with 3
    pens, no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
2026-10-26 renders r9-r18: full render programme — shotlist, env scenes, colourways, exploded overhaul
    The round-9 SHOTLIST restructure (kickstarter research: Keyboardio
    macro-detail, Das Keyboard 4-colourway sets, X-Bows lighting,
    Kinesis split-gaming) drove this whole arc. Agent-built modules
    integrated: env_props.py (sculpted mouse/mug/notebook/lamp/minipc/
    monitor/pens/tower), env_materials.py (vector-warped walnut,
    marble, PCB trace web, page-edge sheet lines, cable braid,
    smoked glass), build_assets choc_glb + artisan_glb.
    scene.py: build_keyboard() extracted (importable); framecheck NDC
    pre-flight for every camera; colourways (dark stealth on dark
    marble / play mirror-symmetric 6-colour / art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
2026-10-27 render r19-21: detail overhaul — agent modules integrated, detail audit, pp pipeline
    Agent modules (built by parallel glm-5.3 sessions, each owning one file):
    - env_surfaces.py: plank desk with end-grain strips, thickness
    variance, y-jitter and one bowed board; 3mm mat with folded
    corner + 342-piece raised welt; room (stepped baseboard, chair
    rail, rug); office chair
    - render_pp.py: Cycles realism (bounces/clamps/adaptive) + compositor
    (hot-spot bloom, dispersion, warm-key/cool-shadow grade, film
    grain), with five 5.2 API changes probe-measured and documented
    (scene.node_tree -> compositing_node_group, NodeGroupOutput is the
    composite, Glare has no Mix socket, display-referre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
2026-10-28 render r22: stack-palette scoping fix, screw/plate/nano/pcb detail, pp retune
    Root cause of the round-22 bright-hero complaints: the --stack-colors
    palette applied scene-wide, so hero+top rendered in the exploded's
    colours (silver plate, graphite case, flat PCB board, gold jack =
    'odd floating plate sections', 'random gold under thumbs', 'blank
    black microcontroller'). The palette now applies inside the exploded
    shot block only — verified one-apply, correct order, hero/top
    untouched.
    - corner screws inset 7 -> 16mm (7mm sat inside the case's corner
    radius, hovering over the edge)
    - plate verified a SINGLE welded shell (the 763 apparent fragments
    were unmerged export vertices — the '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
2026-10-28 render r23: screws removed, stack revert, label bg fix, pcb traces, no pp
    - SCREWS: fully removed — the design has none (magnets hold the
    cover); round-20's corner hardware was invented from a misread and
    floated in every shot
    - stack palette: snapshot/restore of every material assignment +
    visibility around the exploded shot — the top (rendered after the
    exploded in the same invocation) was inheriting the tainted flat
    materials ('grey nano in bright')
    - labels: the world-dimming matched NOTHING (node.type enum is
    'BACKGROUND', not 'SHADER_NODE_BACKGROUND') so light text sat on
    the bright studio white; fixed + bpy_prop_array has no .copy() ->
    tuple(). Exploded mean 0.895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
2026-10-29 render r24: gerber PCB artwork, walnut/plaster/mat textures, growth fixes
    Snapshot of the round-24 render state, committed before the laptop-set
    work so it can be rolled back to.
    Studio:
    * exploded PCB: the real KiCad layer solids (copper / soldermask /
    silkscreen / FR4) each keep their own material instead of one
    striped shader, and the visible layer is UV-mapped in board
    millimetres and carries generated gerber artwork (renders/pcb_tex.py:
    routed traces, pads, vias, silkscreen, ground pour) from the real
    placements.
    * exploded palette: graphite cover, gunmetal plate, dark gaskets;
    camera on a 74 mm lens so the stack fills the frame; no text.
    * nice!nano: thinner gold (0.55 ->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
2026-10-30 render r24e: gasket pads, gerber trace legibility, mat polish, cable look
    Exploded:
    * PORON gaskets are real pads on the cover-tab roots (8 per face
    per half, 7x4 mm from plate/*-lands.json) instead of one slab:
    4 mm along the tab's outward axis and 7 mm across it (the first
    pass had that transposed, so every pad sat 90 deg on its tab).
    Top pads explode with the plate (+24), bottom with the foam
    (-17.5), and the round-14 "hide the top gasket" rule is gone --
    it was why they never appeared in any render.
    * PCB artwork: the pad/via/hole drawing was missing the board-origin
    offset, so every switch footprint landed ~49 mm away and only its
    silkscreen outline sat at the switch. Tr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
2026-10-30 render r24f: flat mat border, softer cable jacket
    Review: "the braided edge -- make it flatter, more subtle, not a thick
    cable on the outer edge of mat".
    * The mat's border was a raised rim band plus a twisted stitch run,
    which at review size read as a cord lying along the perimeter. A
    real bound mat is FLAT: the binding is pressed into the fabric and
    all you see is a fine stitch line. The band is deleted, the
    stitches are small low domes (1.9 x 0.55 x 0.28 mm at 3 mm pitch,
    0.12 mm proud, no twist), and the corner label is flatter to match.
    * The cable jacket loses its rope look: strand contrast 0.62-1.22 ->
    0.84-1.10 and the braid bump 0.55/0.6 mm -> 0.28/0.35 mm, leaving a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
